RalphBacon/205-Internet-Radio/Arduino IDE Version/readme.md

### Follow the instructions in the ESP32-WROVER_Web_Radio folder

If you have an ESP32-WROVER (ie with extra PSRAM) that we can use for the Circular (Ring) Buffer follow the instructions in the Circular Buffer folder **when you have a working model**.
