RalphBacon/205-Internet-Radio/Arduino IDE Version/ESP32-WROVER_Web_Radio/images/VS1053 Cable connection.jpg

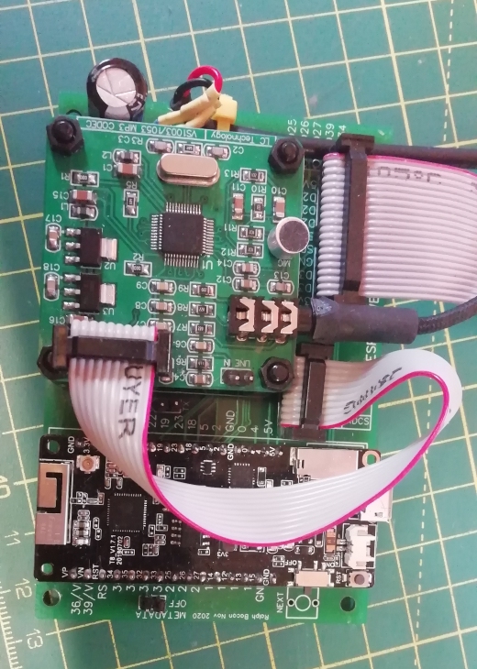
Arduino IDE Version/ESP32-WROVER_Web_Radio/images/VS1053 Cable connection.jpg
