RalphBacon/205-Internet-Radio/Design Schematics/Schematic Jan 2022.jpg

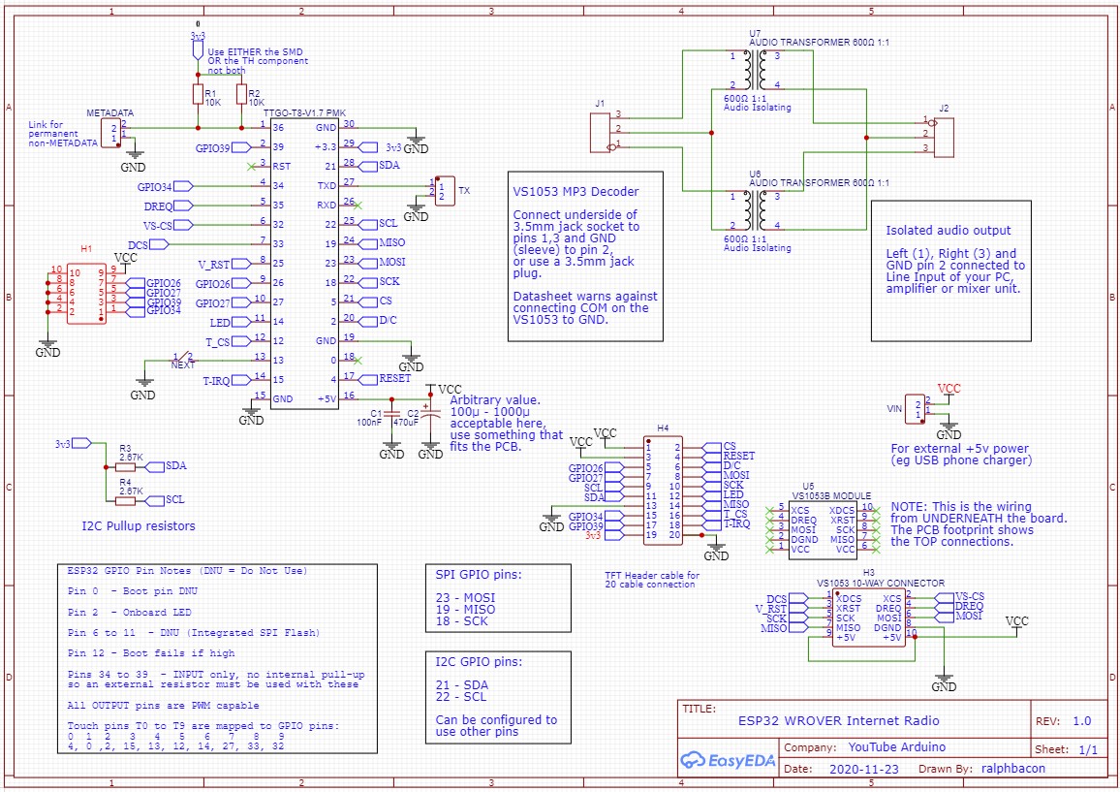
Design Schematics/Schematic Jan 2022.jpg
