RalphBacon/205-Internet-Radio/Design Schematics/TFT Screen Schematic Jan 2022.jpg

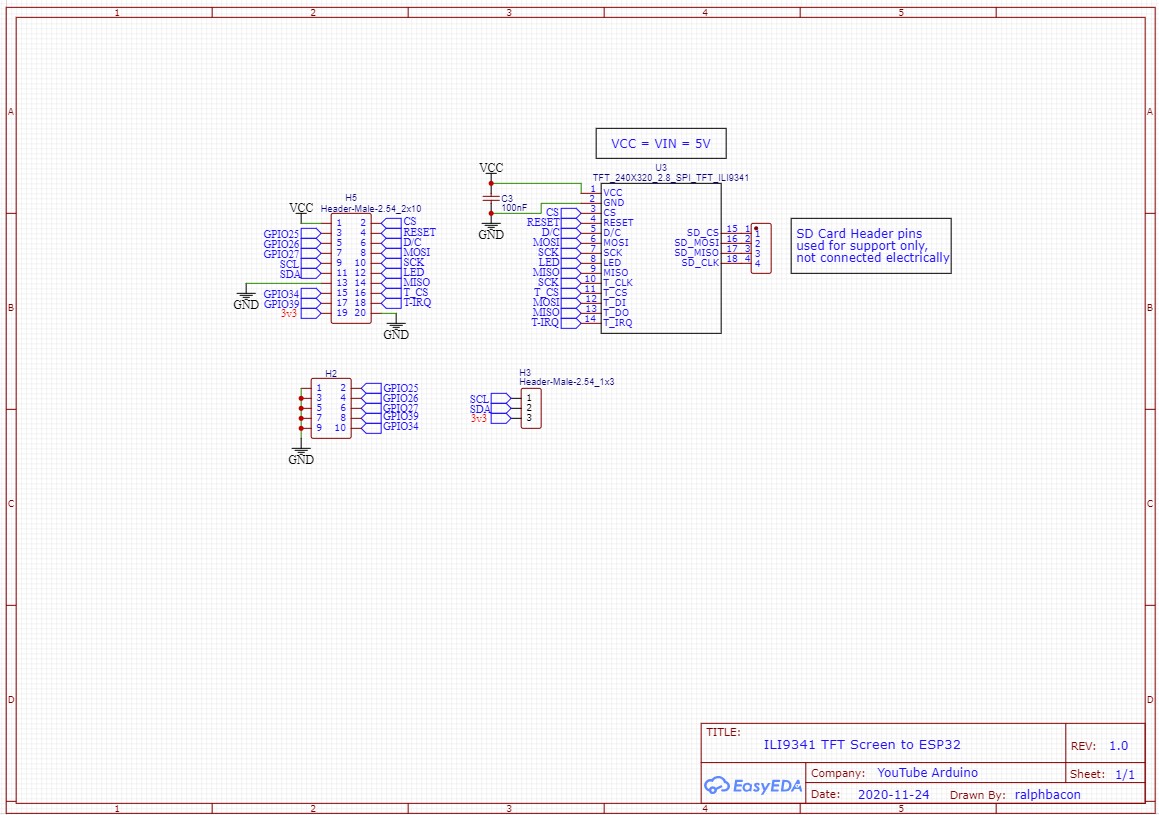
Design Schematics/TFT Screen Schematic Jan 2022.jpg
