RalphBacon/205-Internet-Radio/images/32bytes of data plays for 2mS.JPG

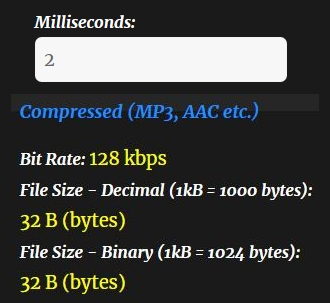
images/32bytes of data plays for 2mS.JPG
