RalphBacon/205-Internet-Radio/images/Internet_Radio.jpg

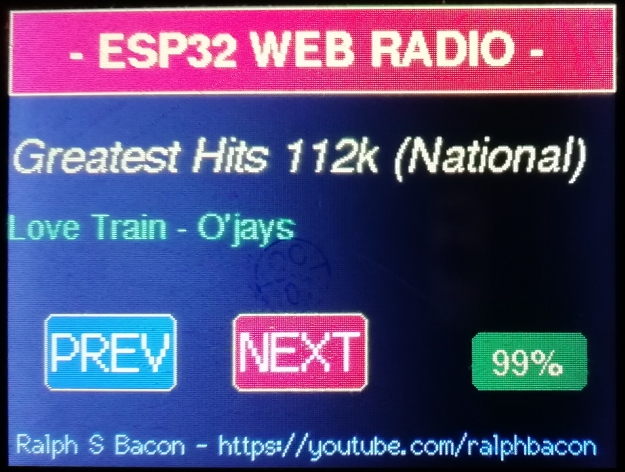
images/Internet_Radio.jpg
