RalphBacon/205-Internet-Radio/images/Long Song Title.jpg

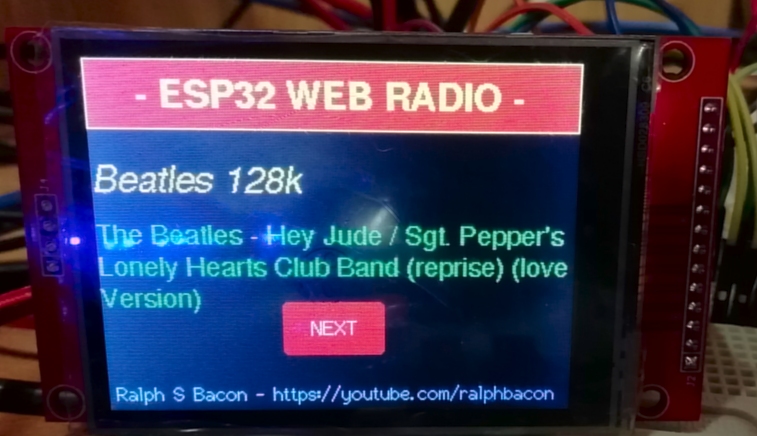
images/Long Song Title.jpg
