RalphBacon/205-Internet-Radio/images/VS1053 PICTURE.JPG

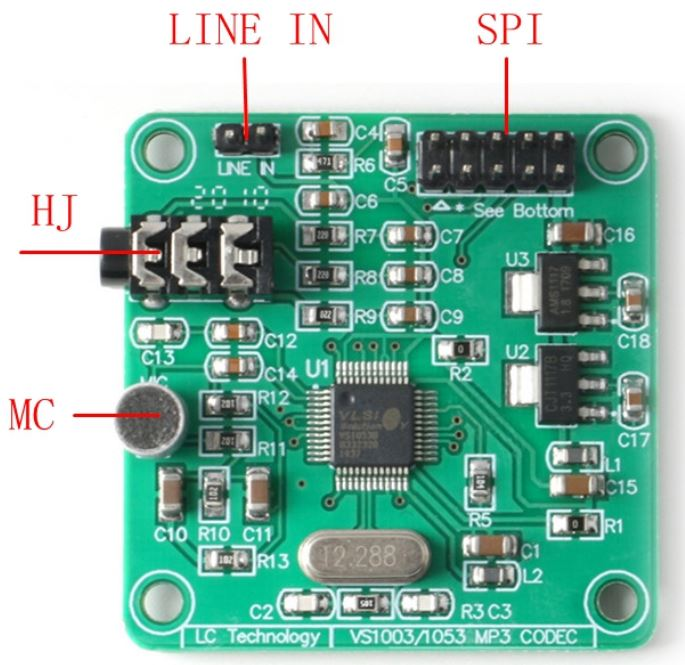
images/VS1053 PICTURE.JPG
