RalphBacon/205-Internet-Radio/PlatformIO/ESP32 Better Internet Radio - YouTube/data/Redirect 2 Example.JPG

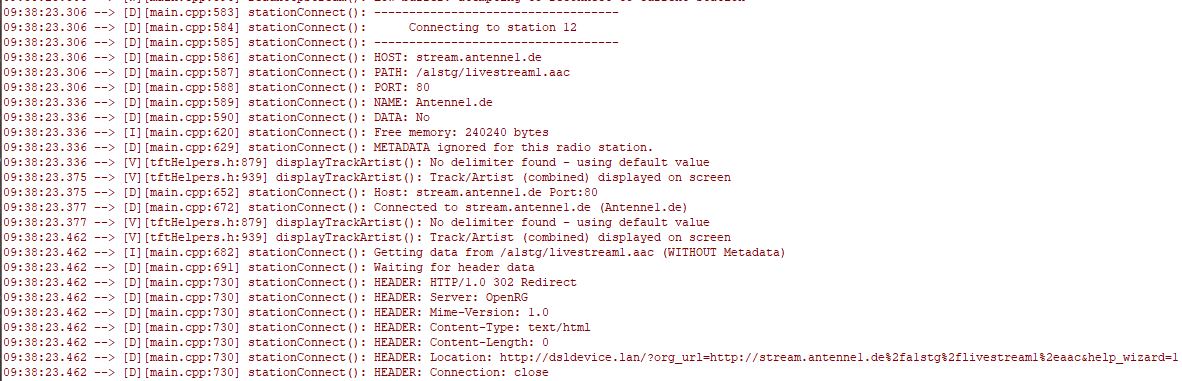
PlatformIO/ESP32 Better Internet Radio - YouTube/data/Redirect 2 Example.JPG
