RalphBacon/205-Internet-Radio/PlatformIO/ESP32 Better Internet Radio - YouTube/data/Redirect Example.JPG

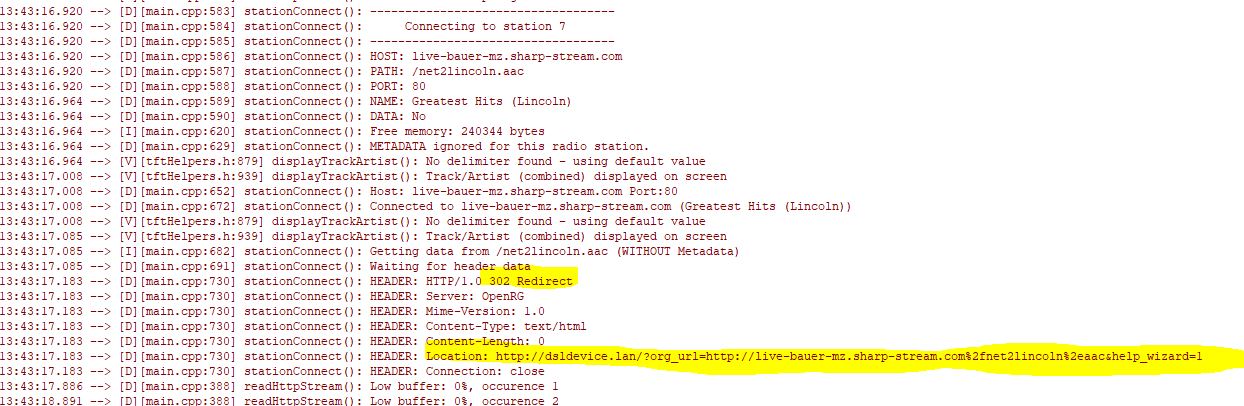
PlatformIO/ESP32 Better Internet Radio - YouTube/data/Redirect Example.JPG
