RalphBacon/205-Internet-Radio/ESP32-Web-Radio-Construction/Audio Isolation Transformers/readme.md

### Instructional video

**If you want to watch a video to show you what I did, click on the link below (the file is too large for GitHub to handle).**

https://www.dropbox.com/s/5mf6carv6id329i/Instructions%20Video%20DVD%20Quality.mp4?dl=0 

If you need the PCB (and you live in the UK) let me know.
