RalphBacon/205-Internet-Radio/ESP32-Web-Radio-Construction/Audio Isolation Transformers/IMG_20210102_132214.jpg

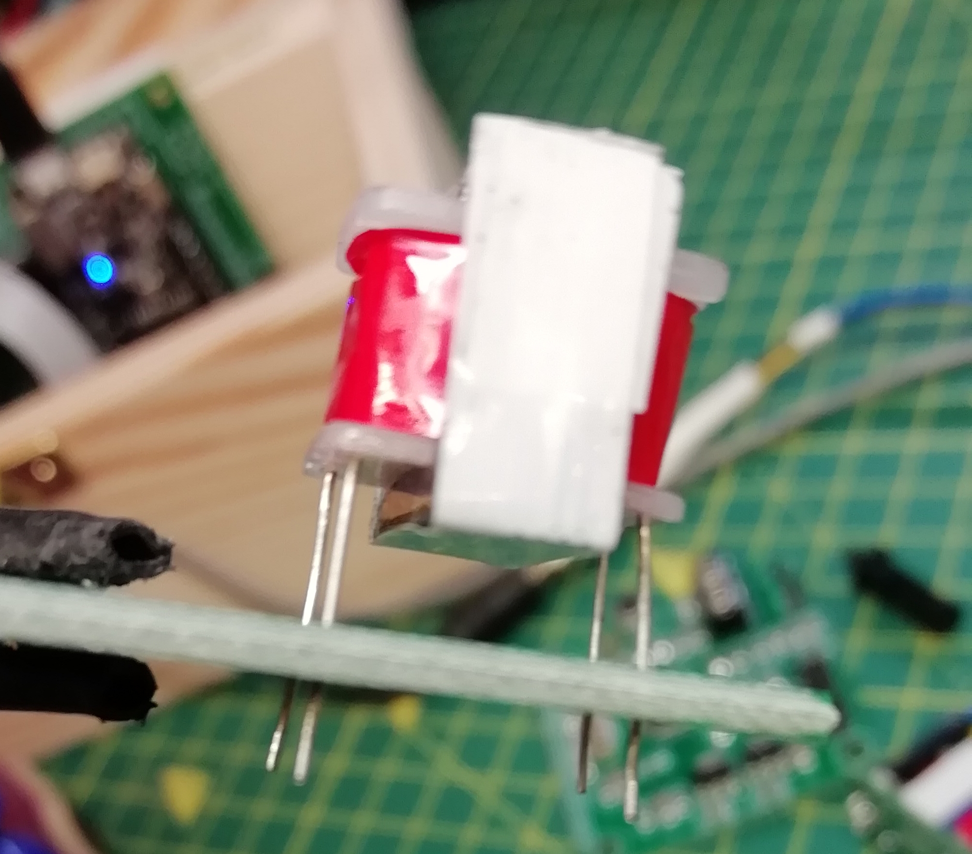
ESP32-Web-Radio-Construction/Audio Isolation Transformers/IMG_20210102_132214.jpg
