RalphBacon/205-Internet-Radio/ESP32-Web-Radio-Construction/Audio Isolation Transformers/IMG_20210102_133005.jpg

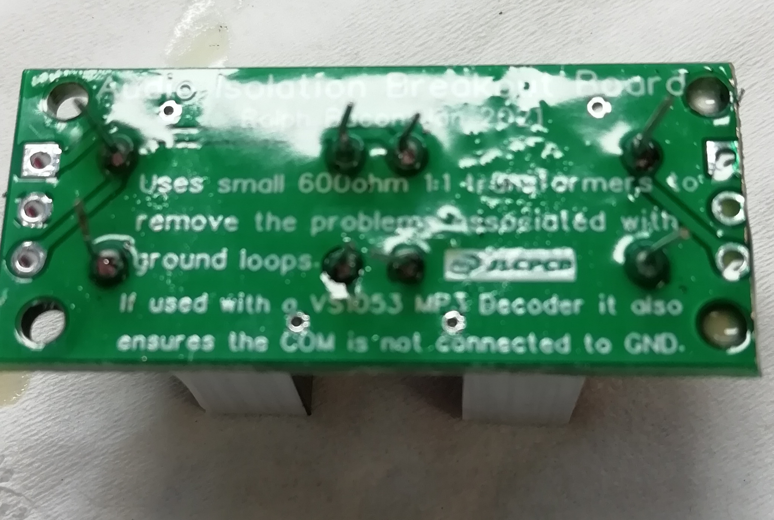
ESP32-Web-Radio-Construction/Audio Isolation Transformers/IMG_20210102_133005.jpg
