RalphBacon/205-Internet-Radio/ESP32-Web-Radio-Construction/Audio Isolation Transformers/IMG_20210108_091936.jpg

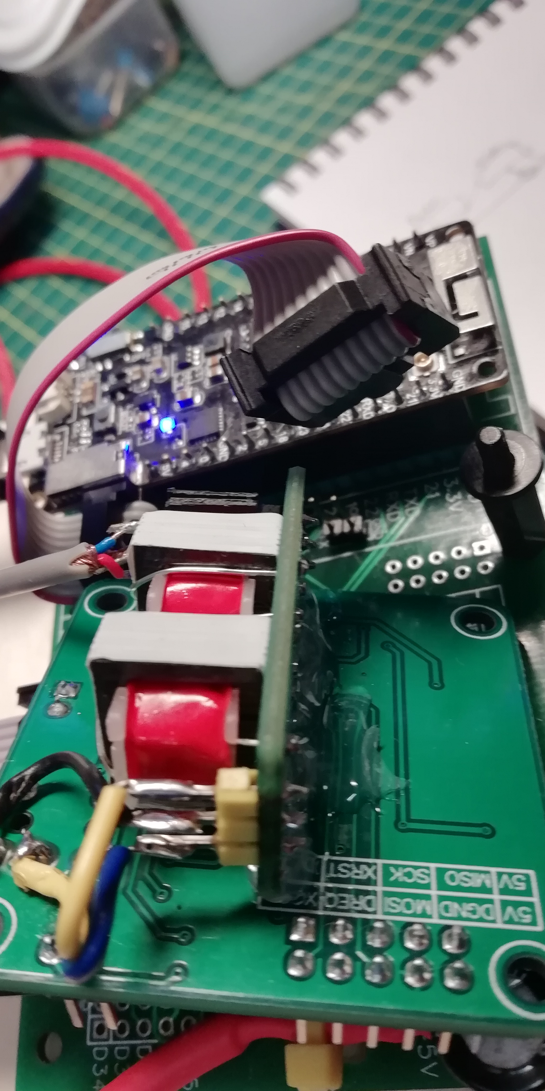
ESP32-Web-Radio-Construction/Audio Isolation Transformers/IMG_20210108_091936.jpg
