RalphBacon/205-Internet-Radio/ESP32-Web-Radio-Construction/Audio Isolation Transformers/Isolating Transformers.JPG

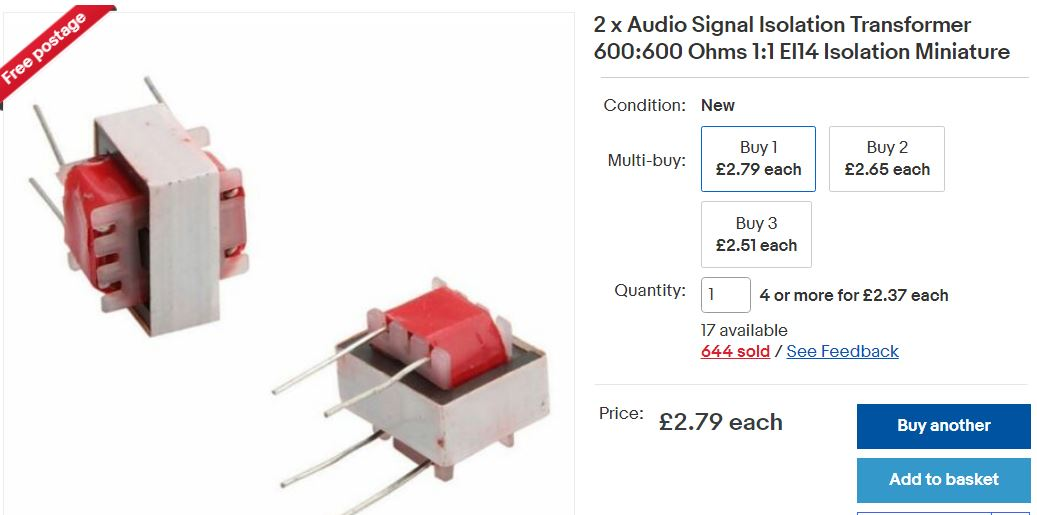
ESP32-Web-Radio-Construction/Audio Isolation Transformers/Isolating Transformers.JPG
