RalphBacon/205-Internet-Radio/ESP32-Web-Radio-Construction/Audio Isolation Transformers/PCB Layout.JPG

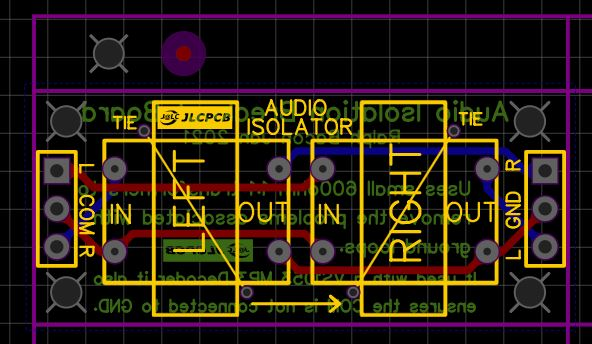
ESP32-Web-Radio-Construction/Audio Isolation Transformers/PCB Layout.JPG
