RalphBacon/205-Internet-Radio/ESP32-Web-Radio-Construction/images/IMG_20201226_133501.jpg

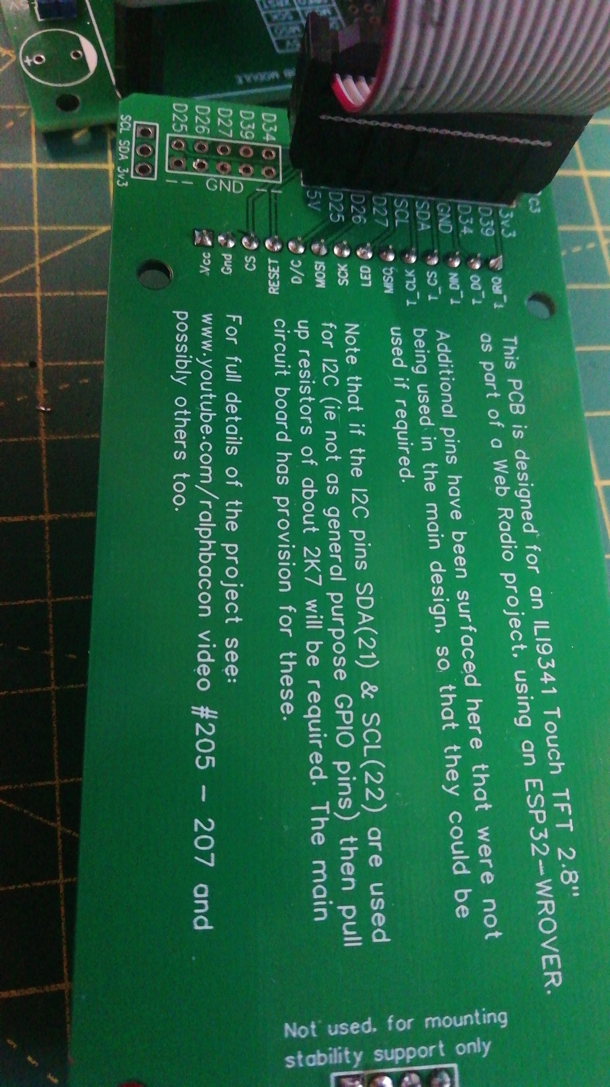
ESP32-Web-Radio-Construction/images/IMG_20201226_133501.jpg
