RalphBacon/205-Internet-Radio/PlatformIO/ESP32 Better Internet Radio - YouTube/data/tune.jpg

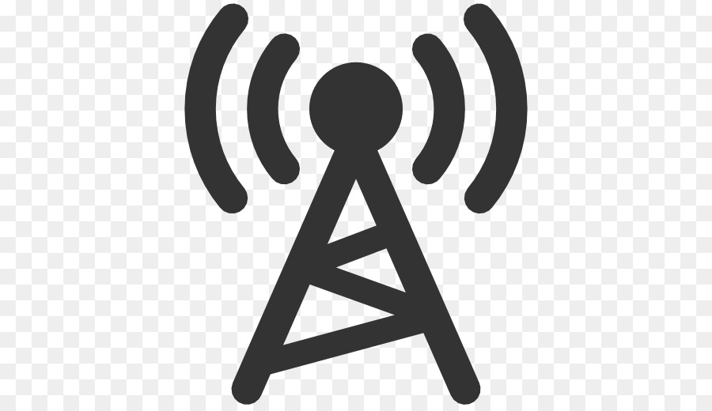
PlatformIO/ESP32 Better Internet Radio - YouTube/data/tune.jpg
