RalphBacon/205-Internet-Radio/(threads)

Thread 1 (2020-11-20):

ESP32 ECO V3

NonaSuomy, 2020-11-20:
Hi Ralph,

Was just watching your video and heard you say the latest version is V1 and that you were looking at using the PSRAM. Just wanted to show you this nfo from Expressif in case you hit these issues with the WROVER PSRAM on older V1 versions instead of the V3.

https://www.espressif.com/sites/default/files/documentation/ESP32_ECO_V3_User_Guide__EN.pdf

Earlier versions had bugs in the silicon which they have fixed in this revision.

Design Change in ECO V3

Espressif has recently released one wafer-level change on ESP32 Series of products (ECO
V3). This document describes differences between V3 and previous ESP32 silicon wafer
revisions. Below are the main design changes in ECO V3 Series of chips:

1. PSRAM Cache Bug Fix: Fixed “When the CPU accesses the external SRAM in a certain
sequence, read & write errors can occur.”. Details of the issue can be found in item 3.9
in ESP32 ECO and Workarounds for Bugs.

2. Fixed “When each CPU reads certain different address spaces simultaneously, a read
error can occur.” Details of the issue can be found in item 3.10 in ESP32 ECO and
Workarounds for Bugs.

3. Optimized 32.768 KHz crystal oscillator stability, the issue was reported by client that
there is a low probability that under ECO V1 hardware, the 32.768 KHz crystal oscillator
couldn’t start properly.

4. Fixed Fault injection issues regarding secure boot and flash encryption are fixed.
Reference: Security Advisory concerning fault injection and eFuse protections
(CVE-2019-17391) & Espressif Security Advisory Concerning Fault Injection and Secure
Boot (CVE-2019-15894)

5. Improvement: Changed the minimum baud rate supported by the CAN module from 25
kHz to 12.5 kHz.

6. Allowed Download Boot mode to be permanently disabled by programming new eFuse
bit UART_DOWNLOAD_DIS. When this bit is programmed to 1, Download Boot mode
cannot be used and booting will fail if the strapping pins are set for this mode. Software
program this bit by writing to bit 27 of EFUSE_BLK0_WDATA0_REG, and read this bit by
reading bit 27 of EFUSE_BLK0_RDATA0_REG. Write disable for this bit is shared with
write disable for the flash_crypt_cnt eFuse field.

Great job with the webradio videos keep it up! Please keep deep-diving into how the code and ring buffers work!

I was playing with https://github.com/Edzelf/ESP32-Radio before and helped include iHeartRadio to it a long while ago. The thing I liked about this code base is you can use MQTT to control the radio for home automation.

RalphBacon, 2020-11-21:
Good morning Nona Suomy!

Thank you so much for the information.

Unfortunately I get a “forbidden” message when accessing that web page, but your summary serves well. I will read it in much more detail today.

I have implemented a software workaround for the PSRAM error in V1 chips (makes me wonder how much testing they ever did).

I looked at the Web Radio from “Edzelf” aka Ed Smallenburg and realised it was very well featured but I wanted to be able to design and build my own design, which I feel I have now done (hardware issues not withstanding). But I have quite a lot more work to do if I am going to make more useful so I won’t get bored.

I’ve been running my ESP32 Rev 1 WROVER board (delivered yesterday) all last night and overnight without a single disconnect. I’m going to be testing how well it (re) connects to the WiFi today and see whether my issues have disappeared. My other V1 chip ran great for 2 days then got the same errors. I have a nagging doubt that it was my config, the router or just my Internet connection that might have been to blame. Perhaps I’ll never find out. What I do know is the ESP8266 version ran without issue at all, ever.

Thanks for the info again, great to hear from you.

Best Regards

Ralph S Bacon

 <https://www.youtube.com/ralphbacon> https://www.youtube.com/ralphbacon

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

NonaSuomy, 2020-11-23:
Sorry I fixed the link on github but it already emailed you the bad link. Was basically just what I put below that.

Here is the ECO V3 version https://www.aliexpress.com/item/4001095751970.html?spm=a2g0o.cart.0.0.c58e3c00UAaLaV&mp=1

I wonder if using an antenna on the board as well would help with reception instead of the pcb ant. Some breakout boards put the ground planes under the pcb ant which is apparently a no-no.

Even with edzelf and karadio https://github.com/karawin/Ka-Radio32 I had that same stuttering issue. Will be great if you find a solution with your build!

I'm glad you are doing your own version as it's nice to see someone explain all the finer details instead of just dumping a bunch of code online. Just doesn't do justice for the extreme curious.

I one time contacted SpriteTM (ExpressIF staff) and asked what he thinks about using this 1053 codec board with the esp32 as a webradio. He told me in his colourful way that it's pointless as the esp32 can do all that without it :) more food for thought? haha...

Keep on hacking! Great content and thanks!

RalphBacon, 2020-11-23:
Thanks for the link to the up-to-date ESP32 V3 (ECO no less!) – I wish there was a suitable board to mount it on, rather than having to remove an existing ESP32 or creating a brand new board (with the voltage regulators, USB connectivity etc). I did find several like this (“Adapter board for welding”):

 <https://www.aliexpress.com/item/32980341113.html> https://www.aliexpress.com/item/32980341113.html

but the design is only suitable for DuPont cables or a PCB – in which case I could do a better job with a custom PCB myself! And I have vague memories of Andreas Spiess warning against them as they were missing a couple of essential resistors.

I have no stuttering at all on my WROVER version (you will hear my thoughts in Friday’s video, but not the radio). Rock solid. Working now for 4 days without a problem. I will have to post the updated code to my GitHub soon. Of course, stuttering depends on the Internet generally, but also the radio server to which you are connected. My buffering (10 seconds) will do nothing for problems in either of those areas! Apart from BBC Radio 4 (don’t get me started) my design work just fine. If I connect to BBC Radio 4 without requesting metadata then that works fine too. Good old BBC. Not.

Actually, it works “too well”. I’m very tempted to just throw it into a box and keep it running in there!!! But I want a PCB and an enclosure of some sort, bearing in mind the screen must be exposed for the touch functionality. I’ve been urged by other viewers to use a Nextion screen (just three wires, including the power!) so I will make the whole design screen agnostic for other to plug in what they want. Time permitting.

Regarding the antenna, my WROVER has a built in bit of flimsy metal (not a PCB trace) that seems to work well, but also has a connection point for an external aerial. I discuss this in Friday’s video.

I’m learning so much on this project about the ESP32 (and PlatformIO) it’s been a great topic and could go on and on!

Thanks for all the info, really useful, keep tuned!

Best Regards

Ralph S Bacon

 <https://www.youtube.com/ralphbacon> https://www.youtube.com/ralphbacon

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

RalphBacon, 2021-01-24:
This will be progressed (using a V3 ECO chip) in the future.

Closed 2021-01-24.

Thread 2 (2021-01-06):

Need help to start, please

Aleks-Ale, 2021-01-06:
Please help me to run this project by any method.
ESP32 WROOM + 2.8"ili9341 w/touch + VS1053
TFT_eSPI-2.2.23\examples\320 x 240\TFT_Clock - work fine
ESP_VS1053_Library\examples\SimpleMp3Player - work fine

Arduino IDE: Compilation runs without errors. But after loading the program into ESP32, I see only a white screen and a cyclic restart in the serial port monitor.

```
rst:0xc (SW_CPU_RESET),boot:0x13 (SPI_FAST_FLASH_BOOT)
configsip: 0, SPIWP:0xee
clk_drv:0x00,q_drv:0x00,d_drv:0x00,cs0_drv:0x00,hd_drv:0x00,wp_drv:0x00
mode:DIO, clock div:1
load:0x3fff0018,len:4
load:0x3fff001c,len:1044
load:0x40078000,len:8896
load:0x40080400,len:5816
entry 0x400806ac
abort() was called at PC 0x401578ef on core 0

Backtrace: 0x4008dc5c:0x3ffe3ab0 0x4008de8d:0x3ffe3ad0 0x401578ef:0x3ffe3af0 0x40157936:0x3ffe3b10 0x4013f85f:0x3ffe3b30 0x4013f94e:0x3ffe3b50 0x4013f905:0x3ffe3b70 0x400dd0b9:0x3ffe3b90 0x400d1ef4:0x3ffe3bb0 0x400e063b:0x3ffe3bd0 0x400820d9:0x3ffe3bf0 0x400822e8:0x3ffe3c20 0x40079053:0x3ffe3c40 0x400790b9:0x3ffe3c70 0x400790c4:0x3ffe3ca0 0x4007928d:0x3ffe3cc0 0x400806de:0x3ffe3df0 0x40007c31:0x3ffe3eb0 0x4000073d:0x3ffe3f20

Rebooting...`
```

PlatformIO: Unsuccessfully again.
I installed for the first time Visual Studio Code with PlatformIO Core: 5.0.4 in Python 3.9.1.

```
Library Manager: Installing git+https://github.com/lorol/LITTLEFS.git
FileNotFoundError: [WinError 2]
  File "C:\users\alexander\.platformio\penv\lib\site-packages\platformio\builder\main.py", line 170:
    env.SConscript("$BUILD_SCRIPT")
  File "C:\Users\Alexander\.platformio\packages\tool-scons\scons-local-4.0.1\SCons\Script\SConscript.py", line 598:
    return _SConscript(self.fs, *files, **subst_kw)
  File "C:\Users\Alexander\.platformio\packages\tool-scons\scons-local-4.0.1\SCons\Script\SConscript.py", line 287:
    exec(compile(scriptdata, scriptname, 'exec'), call_stack[-1].globals)
  File "C:\users\alexander\.platformio\platforms\espressif32\builder\main.py", line 224:
    target_elf = env.BuildProgram()
  File "C:\Users\Alexander\.platformio\packages\tool-scons\scons-local-4.0.1\SCons\Environment.py", line 219:
    return self.method(*nargs, **kwargs)
  File "C:\users\alexander\.platformio\penv\lib\site-packages\platformio\builder\tools\platformio.py", line 62:
    env.ProcessProjectDeps()
  File "C:\Users\Alexander\.platformio\packages\tool-scons\scons-local-4.0.1\SCons\Environment.py", line 219:
    return self.method(*nargs, **kwargs)
  File "C:\users\alexander\.platformio\penv\lib\site-packages\platformio\builder\tools\platformio.py", line 140:
    project_lib_builder = env.ConfigureProjectLibBuilder()
  File "C:\Users\Alexander\.platformio\packages\tool-scons\scons-local-4.0.1\SCons\Environment.py", line 219:
    return self.method(*nargs, **kwargs)
  File "C:\users\alexander\.platformio\penv\lib\site-packages\platformio\builder\tools\piolib.py", line 1062:
    project.install_dependencies()
  File "C:\users\alexander\.platformio\penv\lib\site-packages\platformio\builder\tools\piolib.py", line 898:
    lm.install(spec)
  File "c:\users\alexander\.platformio\penv\lib\site-packages\platformio\package\manager\_install.py", line 49:
    spec, silent=silent, skip_dependencies=skip_dependencies, force=force
  File "c:\users\alexander\.platformio\penv\lib\site-packages\platformio\package\manager\library.py", line 86:
    force=force,
  File "c:\users\alexander\.platformio\penv\lib\site-packages\platformio\package\manager\_install.py", line 97:
    pkg = self.install_from_url(spec.url, spec, silent=silent)
  File "c:\users\alexander\.platformio\penv\lib\site-packages\platformio\package\manager\_install.py", line 141:
    vcs = VCSClientFactory.new(tmp_dir, url)
  File "c:\users\alexander\.platformio\penv\lib\site-packages\platformio\package\vcsclient.py", line 55:
    src_dir, remote_url, tag, silent
  File "c:\users\alexander\.platformio\penv\lib\site-packages\platformio\package\vcsclient.py", line 137:
    self.configure()
  File "c:\users\alexander\.platformio\penv\lib\site-packages\platformio\package\vcsclient.py", line 146:
    result = proc.exec_command([cls.command, "--exec-path"])
  File "c:\users\alexander\.platformio\penv\lib\site-packages\platformio\proc.py", line 113:
    p = subprocess.Popen(*args, **kwargs)
  File "C:\Users\Alexander\.platformio\python3\lib\subprocess.py", line 800:
    restore_signals, start_new_session)
  File "C:\Users\Alexander\.platformio\python3\lib\subprocess.py", line 1207:
    startupinfo)
```

RalphBacon, 2021-01-06:
The Arduino version is somewhat out-of-date and I don't think it auto-detects whether you have a WROVER installed or not (ie additional PSRAM) so I suspect it's trying to allocate all your SRAM to the circular buffer. Go to the main.h and reduce the circular buffer size to 10,000 (ten thousand) which will be fine for WROOM-based ESP32s, although you only get about half a second of buffering. Let me know.

Aleks-Ale, 2021-01-07:
> reduce the circular buffer size to 10,000
Thank you! I tested different values. 80,000 is good.
Now I'm trying to understand why pressing the NEXT button on touch srceen does not work. I added calibration and getTouchRaw for the test. These tests work. But pressing the touch button does not work to switch station.
Any ideas?

RalphBacon, 2021-01-07:
Do any on screen controls work? Check that the T_IRQ from the screen is connected correctly and is being detected.

Aleks-Ale, 2021-01-08:
I understood and corrected all my stupid mistakes.
This made it possible to prepare for your next project # 208. I really liked your work.
This is a good example for understanding and learning.
For example, your solution to change the screen brightness is very interesting.
I will gladly study your project code # 208.
Do you have a plan to integrate a spectrum analyzer? For example like this:
https://github.com/blotfi/ESP32-Radio-with-Spectrum-analyzer
It is also possible to create a screen with station names to scroll through the screen and select the desired station by touching.

RalphBacon, 2021-01-08:
I regret that I won't be implementing a spectrum analyser.
But I have already implemented a station lister (it now reads from a text file in the SPIFFS partition) and selects from the screen; I have not uploaded to GitHub yet, as it is in PlatformIO project format only right now. I will have to port it to the Arduino format "soon".
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

The two photos show the new format of the screen. Pressing the "?" button will bring up pages of stations to choose from.

Aleks-Ale, 2021-01-08:
> implemented a station lister (it now reads from a text file in the SPIFFS partition) and selects from the screen

OMG!!! You rock!!! You're cool!!
Short story. My first web player is a project from Edzelf. The next modification with a spectrum analyzer from blotfi.
I made this screen design for myself.

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

It works, but a lot of code, a lot of unnecessary functions, no touch.
I dreamed of finding a short project with touch control. Web radio only.
Because I am a beginner and cannot create such a solution.
Your project is short and understandable.
If you can send me this project, as in your photo, as it is, I will be very grateful to you. Maybe I can port it for arduino ide.

Aleks-Ale, 2021-01-18:
> I have already implemented a station lister

Dear Mr. Ralph Bacon,
Sorry to bother you again.
May I ask you to share this project with me?
This is very interesting and important to me.
Thank you!

RalphBacon, 2021-01-18:
There is now an Arduino ported version here:
https://github.com/RalphBacon/205-Internet-Radio

See the Arduino IDE Version folder.

Aleks-Ale, 2021-01-18:
Thank you SO MUCH! I will see right now!

Aleks-Ale, 2021-01-22:
Dear Ralf,
Could you check it out:

stationList.txt : Is necessary to have a comma at the end of each line except the last.
stationSelectHelper.h : swap port and path

```
typedef struct radioStationLayout
{
	std::string host;
        uint16_t port;
	std::string path;
	std::string friendlyName;
	uint8_t useMetaData;

```
Thank you.

RalphBacon, 2021-01-22:
1. You do not need a comma at the end of each line. This is an extract of my current list:
"stream.antenne1.de",80,"/a1stg/livestream1.aac","Antenne1.de","1"
"bbcmedia.ic.llnwd.net","80","/stream/bbcmedia_radio4fm_mf_q","BBC Radio 4",0
"stream.antenne1.de",80,"/a1stg/livestream2.mp3","Antenne1 128k",1

2. The only way to close the station list without changing station is to find the (highlighted) current station and choose that, as you have found out. I will probably change that behaviour in the future with a simple cancel button at the foot of the list (near page X of y). All a work in progress!

tadder, 2021-01-22:
Hi Ralph,
Your station lister addition is fortuitous as I have been attempting to add an extra station to the code as follows.
//8
  "internetradio.com",
  "/virgin",
  80,
  "Virgin Radio",
  1,
The lister renders this code redundant, so I will concentrate on adding the lister. Are there any guidelines I should follow when adding a new station?

RalphBacon, 2021-01-22:
The format of the station listing is pretty straightforward:

<host>,<port>,<path>,<friendly name>,<use MetaData>

Quotes are optional, it's the commas that matter (so ensure you don't have any, except to delimit the fields)

http is assumed (so don't add that as part of the host.
Port is mostly 80 but might be something else.
Friendly name is what you see on screen, so don't make it too long.
Metadata (0=no, 1=yes) will cause the station to fail if it does not transmit Metadata but you have put a 1 here - that said, the station SHOULD still honour that setting (and just send 0 byte metadata) but some don't seem to follow the rules. Always try it out on a browser (or Winamp) if you have problems to see whether track/artist information is being sent out.

Note that the absence of Track/Artist does not mean they don't send out metadata: I'm listening to a radio station right now that SHOULD send out metadata (and does, but only 0 byte markers, no actual track info) and when I queried it with them they said they were running off a backup server that doesn't send out that info but their main one (when repaired) will do so again!

Aleks-Ale, 2021-01-22:
> 1. You do not need a comma at the end of each line.
Unfortunately, I am not an expert in programming and I do not know why we have different results.
I see what I see :)  This is the log if you run the sketch without any changes.

```

[I][tftHelpers.h:148] setupDisplayModule(): TFT Initialised
[D][ESP32-WROVER_Web_Radio.ino:79] setup(): Starting player
[V][tftHelpers.h:484] displayTrackArtist(): No delimiter found - using default value
[D][ESP32-WROVER_Web_Radio.ino:84] setup(): Waiting for VS1053 initialisation to complete.
[D][ESP32-WROVER_Web_Radio.ino:91] setup(): Switch player to MP3 mode
[V][tftHelpers.h:484] displayTrackArtist(): No delimiter found - using default value
[V][tftHelpers.h:484] displayTrackArtist(): No delimiter found - using default value
[V][stationSelectHelper.h:399] populateStationList(): Parameter:'stream.antenne1.de'
[V][stationSelectHelper.h:399] populateStationList(): Parameter:'80'
[V][stationSelectHelper.h:399] populateStationList(): Parameter:'/a1stg/livestream1.aac'
[V][stationSelectHelper.h:399] populateStationList(): Parameter:'Antenne1.de'
[V][stationSelectHelper.h:399] populateStationList(): Parameter:'1bbcmedia.ic.llnwd.net'
[V][stationSelectHelper.h:474] addStationToArray(): Vector size:1
[V][stationSelectHelper.h:399] populateStationList(): Parameter:'80'
[V][stationSelectHelper.h:399] populateStationList(): Parameter:'/stream/bbcmedia_radio4fm_mf_q'
[V][stationSelectHelper.h:399] populateStationList(): Parameter:'BBC Radio 4'
[V][stationSelectHelper.h:399] populateStationList(): Parameter:'0stream.antenne1.de'
[V][stationSelectHelper.h:399] populateStationList(): Parameter:'80'
[V][stationSelectHelper.h:474] addStationToArray(): Vector size:2
[V][stationSelectHelper.h:399] populateStationList(): Parameter:'/a1stg/livestream2.mp3'
[V][stationSelectHelper.h:399] populateStationList(): Parameter:'Antenne1 128k'
[V][stationSelectHelper.h:399] populateStationList(): Parameter:'1listen.181fm.com'
[V][stationSelectHelper.h:399] populateStationList(): Parameter:'80'
[V][stationSelectHelper.h:399] populateStationList(): Parameter:'/181-beatles_128k.mp3'

[I][stationSelectHelper.h:446] populateStationList(): Radio stations imported successfully.
[D][stationSelectHelper.h:456] populateStationList(): 0 - stream.antenne1.de /a1stg/livestream1.aac 80 (Antenne1.de) YES
[D][stationSelectHelper.h:456] populateStationList(): 1 - 80 BBC Radio 4 0 (0stream.antenne1.de) NO
[D][stationSelectHelper.h:456] populateStationList(): 2 - /a1stg/livestream2.mp3 1listen.181fm.com 0 (80) NO
[D][stationSelectHelper.h:456] populateStationList(): 3 - Beatles 128k 80 1 (/magicmellow.mp3) NO
[D][stationSelectHelper.h:456] populateStationList(): 4 - 1edge-bauermz-03-gos2.sharp-stream.com /net2national.mp3 80 (Greatest Hits 112k (National)) YES
[D][stationSelectHelper.h:456] populateStationList(): 5 - 8024 Mowtown Magic Oldies 0 (1live-bauer-mz.sharp-stream.com) NO
[D][stationSelectHelper.h:456] populateStationList(): 6 - /magicmellow.aac 1stream.btsstream.com 0 (8000) NO

```

As you can see, the sections are formed incorrectly. Now I put commas at the end of the line.
Parsing completes correctly and creates a list of stations.

```
[V][tftHelpers.h:484] displayTrackArtist(): No delimiter found - using default value
[V][stationSelectHelper.h:399] populateStationList(): Parameter:'stream.antenne1.de'
[V][stationSelectHelper.h:399] populateStationList(): Parameter:'80'
[V][stationSelectHelper.h:399] populateStationList(): Parameter:'/a1stg/livestream1.aac'
[V][stationSelectHelper.h:399] populateStationList(): Parameter:'Antenne1.de'
[V][stationSelectHelper.h:399] populateStationList(): Parameter:'1'
[V][stationSelectHelper.h:474] addStationToArray(): Vector size:1
[V][stationSelectHelper.h:399] populateStationList(): Parameter:'bbcmedia.ic.llnwd.net'
[V][stationSelectHelper.h:399] populateStationList(): Parameter:'80'
[V][stationSelectHelper.h:399] populateStationList(): Parameter:'/stream/bbcmedia_radio4fm_mf_q'
[V][stationSelectHelper.h:399] populateStationList(): Parameter:'BBC Radio 4'
[V][stationSelectHelper.h:399] populateStationList(): Parameter:'0'
[V][stationSelectHelper.h:474] addStationToArray(): Vector size:2
[V][stationSelectHelper.h:399] populateStationList(): Parameter:'stream.antenne1.de'
[V][stationSelectHelper.h:399] populateStationList(): Parameter:'80'
[V][stationSelectHelper.h:399] populateStationList(): Parameter:'/a1stg/livestream2.mp3'
[V][stationSelectHelper.h:399] populateStationList(): Parameter:'Antenne1 128k'
[V][stationSelectHelper.h:399] populateStationList(): Parameter:'1'

[I][stationSelectHelper.h:446] populateStationList(): Radio stations imported successfully.
[D][stationSelectHelper.h:456] populateStationList(): 0 - stream.antenne1.de /a1stg/livestream1.aac 80 (Antenne1.de) YES
[D][stationSelectHelper.h:456] populateStationList(): 1 - bbcmedia.ic.llnwd.net /stream/bbcmedia_radio4fm_mf_q 80 (BBC Radio 4) NO
[D][stationSelectHelper.h:456] populateStationList(): 2 - stream.antenne1.de /a1stg/livestream2.mp3 80 (Antenne1 128k) YES
[D][stationSelectHelper.h:456] populateStationList(): 3 - listen.181fm.com /181-beatles_128k.mp3 80 (Beatles 128k) YES
[D][stationSelectHelper.h:456] populateStationList(): 4 - stream-mz.planetradio.co.uk /magicmellow.mp3 80 (Mellow Magic (Redirected)) YES
[D][stationSelectHelper.h:456] populateStationList(): 5 - edge-bauermz-03-gos2.sharp-stream.com /net2national.mp3 80 (Greatest Hits 112k (National)) YES
[D][stationSelectHelper.h:456] populateStationList(): 6 - airspectrum.cdnstream1.com /1302_192 8024 (Mowtown Magic Oldies) YES
```

RalphBacon, 2021-01-23:
Make sure you've taken the complete set of code in my GitHub - this looks like a previous codeset.

tadder, 2021-01-23:
I have uploaded the latest Arduino Version and followed the instruction fully. As you can see from the attached photo it is working up to a point. However, I suspect there are issues with reading the ‘stationList’ file. The first in the list ‘Antenne1.de’ plays with no problem but when changing station there appears to be a loss of sync (see 2 Ostream.antenne1 which should be radio 4. 3 is picking up the port number instead of the friendly name). Selecting some reports ‘Connecting’ and hangs others report ‘Could not connect to this station’ and allow further connection. Either way only the first station works.

As an aside, discovering radio station URL’s is difficult. I wonder if this is a ploy to get us to use ‘commercial’ WEB radios with inbuilt station lists?

As a separate exercise I also tried enabling PSRAM which results in ‘almost’ continuous reboots. I tried to get a copy of the output using the Arduino serial monitor, but was unsuccessful (though monitor appears to work when PSRAM is disabled).

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

Aleks-Ale, 2021-01-23:
> I have uploaded the latest Arduino Version

I wrote about this problem above.
Just add a comma at the end of every line except the last line in the station list file.
I think that Ralph doesn't have such a error.

```
"live-bauer-mz.sharp-stream.com",80,"/net2lincoln.aac",Greatest Hits (Lincoln),1,
ais-edge09-live365-dal02.cdnstream.com,80,/a52107?listenerId=esAdblock0650048,Heckington Community Radio,1,
live-bauer-mz.sharp-stream.com,80,/net1lincoln.aac,Radio Lincs FM,1

```

RalphBacon, 2021-01-23:
I've just uploaded **a new version v1.19** for the Arduino IDE.
Remember to also update/upload the **data partition** on your ESP32 to ensure the stationList is in the right format.
The **circular buffer** will not work above about 10000 bytes without a change to the underlying ESP32 Circular Buffer file (which I can document, but it's a bit hacky). Anyone interested?

RalphBacon, 2021-01-23:
Compare your code to the picture in the readme.md file for the Arduino IDE.

Just to be clear, you should NOT need a trailing comma at the end of the stationList.txt file if you are using the most recent codebase.

Aleks-Ale, 2021-01-23:
> Anyone interested?

Yes, of course! Thank you!

RalphBacon, 2021-01-23:
Instructions on how to enable the circular buffer on ESP32-WROVER boards added:

https://github.com/RalphBacon/205-Internet-Radio/tree/main/Arduino%20IDE%20Version

tadder, 2021-01-23:
Thanks for that, I didn’t fully understand that you were describing the same problem. You are indeed right, I have now terminated each line with a comma and they now all work. I am using the Arduino code so I wonder if Ralph doesn’t get this issue because he is using PlatformIO? Just a thought.

I am now attempting to add an extra line at the end as follows:

internet-radio.com,80,/station/xrds/,XRDS.fm Clarksdale,0

This results in “Connected Reading stream…” and no sound. I couldn’t find the Port number so guessed at 80, I wonder if this might be the issue?

Aleks-Ale, 2021-01-23:
> ESP32-WROVER boards
I understood. I used ESP 32 WROOM without SPRAM. I expect delivery of WROVER soon.

RalphBacon, 2021-01-23:
You CAN use the SP32-WROOM quite successfully, just be aware that you might experience more "drop outs".

Use the new code I posted today and get that station list issue sorted out! Otherwise you are hacking, or working around, some sort of weird conflict (perhaps you did not upload the Data folder again?). Whatever, new version is there.

Aleks-Ale, 2021-01-23:
> new version is there

Thanks. Please tell me, for what reasons do you use LITTLEFS instead of the standard SPIFFS ? Is it possible to use SPIFFS in your project? I just replaced LITTLEFS -> SPIFFS in the program text . I use a single ESP32 chip for a couple of current projects that use SPIFFS.

tadder, 2021-01-23:
Software V1.19 now being used. I am using stationList as is (no extra comma’s).

- Libaries ARDUINO_LOG, ESP_vs1053_Library, TFT_eSPI-2.2.23 updated by copying direct to libaries folder in sketch folder (overwrite).
- Data folder content upgraded via ESP32 Sketch Data Upload.
- Code now stops at ‘Starting MP3 Decoder’
-
- So I believe I have carried out the procedure correctly, but no doubt I am missing something.

MONITOR OUTPUT:
ets Jun  8 2016 00:22:57

rst:0x1 (POWERON_RESET),boot:0x13 (SPI_FAST_FLASH_BOOT)
configsip: 0, SPIWP:0xee
clk_drv:0x00,q_drv:0x00,d_drv:0x00,cs0_drv:0x00,hd_drv:0x00,wp_drv:0x00
mode:DIO, clock div:1
load:0x3fff0018,len:4
load:0x3fff001c,len:1216
ho 0 tail 12 room 4
load:0x40078000,len:9720
ho 0 tail 12 room 4
load:0x40080400,len:6352
entry 0x400806b8

[E][ESP32-WROVER_Web_Radio.ino:27] setup(): Version v1.210123_19 - 2021-01-23 14:29:43.815057
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

Aleks-Ale, 2021-01-23:
I see the same problem as Tudder.
Is it possible that we are making the same mistake?
The new version 1.19 is installed.
But you still need a comma at the end of the lines in the list of stations.
Without a comma, the list of stations is formed incorrectly. And I see the same offset of station names in the list.
It doesn't matter to me. It works anyway.
This is a great tutorial on how to work with the touch screen and organize your code.

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

RalphBacon, 2021-01-23:
If it stops at "Starting MP3 Decoder" just it's the reboot on the device. This only happens to me (sometimes) after a new code upload, never at other times. You are powering board from separate +5v supply, not via USB port, right?

RalphBacon, 2021-01-23:
I will look at station list offset tomorrow, i know the problem but I have fixed it, perhaps I have not given you the new library. Only cosmetic!

Aleks-Ale, 2021-01-23:
> i know the problem

No problem, I just use

row[nthRow].setLabelDatum(-140,

tadder, 2021-01-23:
>
>
> If it stops at "Starting MP3 Decoder" just press the reset button on the device. This only happens to me (sometimes) after a new code upload, never at other times. You are powering board from separate +5v supply, not via USB port, right?

Yes, I confirm I am powering the board from a seperate 5V PSU. Unfortunately pressing the reset button just cycles back to the same "Starting MP3 Decoder message.

tadder, 2021-01-23:
Aleks_Ale - Take a look at Ralphs Video #203 it contains a great introduction to LittleFS.

Aleks-Ale, 2021-01-24:
> Video #203

Thanks! I found it now! :)

RalphBacon, 2021-01-24:
Regarding the **on-screen station list being offset,** please check the following:

**library**: TFT_eSPI-2.2.23
**file**: Button.cpp

Line 82/83 was:
   `   _gfx->drawString(long_name, _x1 + (_w/2) + _xd, _y1 + (_h/2) - 4 + _yd);`

Now should be (with above line commented out):
```
// RSB to correct centre alignment regardless of DATUM
_gfx->drawString(long_name, _x1 + _xd, _y1 + (_h/2) - 4 + _yd);

```
This is the correction that works on Arduino IDE and PlatformIO.

RalphBacon, 2021-01-24:
Regarding the **stationList.txt** and the strange comma at the end of the line, please confirm/check the following:

Open the file in an editor that can show you HEX characters (eg notepad++)

At the end of each station line, the last two characters should be 0D 0A (carriage return, line feed). If you don't use Windows it might be different. The order of those characters is important.

"stream.antenne1.de",80,"/a1stg/livestream1.aac","Antenne1.de","1"

22 73 74 72 65 61 6d 2e 61 6e 74 65 6e 6e 65 31 2e 64 65 22 2c 38 30 2c 22 2f 61 31 73 74 67 2f 6c 69 76 65 73 74 72 65 61 6d 31 2e 61 61 63 22 2c 22 41 6e 74 65 6e 6e 65 31 2e 64 65 22 2c 22 31 22 **0d 0a**

If the last two characters are not as shown (in bold) then we have found the issue. Re-edit the file with an editor that puts those characters in there.

tadder, 2021-01-24:
I have reloaded V1.19 but it still hangs at “Starting MP3 Decoder” as described yesterday.
Any thoughts?

RalphBacon, 2021-01-24:
This means the VS1053 is not initialising.

Check the orientation of the cable going from the VS1053 to the motherboard. Specifically, ensure the 5v connections on the VS1053 go to the correct pins on the motherboard. If the cable points away from the VS1053 then it should do the same on the motherboard. If the cable runs across the VS1053 then it will connect to the motherboard with the cable running right next to the socket (a tight fit - see the pictures here: [https://github.com/RalphBacon/205-Internet-Radio/tree/main/ESP32-Web-Radio-Construction](url))

If you disconnect the cable from the VS1053 it will probably continue booting up but, obviously, you will hear no sound.

RalphBacon, 2021-01-24:
I've added a picture of the preferred way of connecting the VS1053:
[https://github.com/RalphBacon/205-Internet-Radio/tree/main/Arduino%20IDE%20Version/ESP32-WROVER_Web_Radio/images](url)
It's in the images folder for the Arduino IDE version.

tadder, 2021-01-24:
Thanks for your assistance Ralph. The board had been working prior to loading V1.19 so to double check I reloaded this prior version and it works. I have checked the wiring but I suspect you would agree in view of the old version working it’s unlikely to be a hardware issue. As you can see the VS1053 is mounted as per your suggestion.

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

RalphBacon, 2021-01-24:
I wasn't aware you had it working prior to the current version!

Go to your sketch, find the setup() routine and find these lines:
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

Comment out those lines and add:
`player.begin();`

This is how it was previously (it doesn't check the result from the call). See how far you get.

Aleks-Ale, 2021-01-24:
> the last two characters should be 0D 0A

Yes, you right. This is your original stationList.txt
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

Aleks-Ale, 2021-01-24:
> _gfx->drawString(long_name, _x1 + _xd, _y1 + (_h/2) - 4 + _yd);

Thanks! Now correct.
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

RalphBacon, 2021-01-24:
@Aleks-Ale  I can only assume that the stationList.txt you show there must be an early version. This is the problem trying to keep two code bases in-line (not forgetting non-code files)!

At least the station list now lines up correctly on-screen, excellent.

Aleks-Ale, 2021-01-24:
> I can only assume that the stationList.txt you show there must be an early version.

Is this the correct download path?
https://github.com/RalphBacon/205-Internet-Radio
I just downloaded this archive again.
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

tadder, 2021-01-24:
OK, that worked, a couple of steps further, it now outputs the welcome message and reads the station list. However it will only connect to the first station in the list, so perhaps I am now experiencing similar issues to Aleks? I will re-visit the thread you have had with him a see if this helps. Thanks as always, looks as if I might actually have this working by the end of the day.

Aleks-Ale, 2021-01-24:
> I can only assume that the stationList.txt you show there must be an early version.

I found a solution to this problem. You just need to open the stations file in MS Word and save it again.
After that, the correct codes appear at the end of the line.

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

Aleks-Ale, 2021-01-24:
I'm really looking forward to seeing how you solve the issue of returning from the list without changing the station.

RalphBacon, 2021-01-24:
Interesting about having to edit that stationList.txt file. My (local) GitHub shows the correct line endings. Perhaps it is the way GitHub processes this? Are you using Windows 10? something for me to bear in mind.

Returning from the station list (without click the current station again) is probably going to be done by touching the Page X of Y area (simple but not so obvious). I shall think about it some more. Perhaps a separate "Return Icon" button would be better.

RalphBacon, 2021-01-24:
@tadder  When you say it "only connects to the first station", does that mean when you select another one it tries to
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

Thread 3 (2021-01-09):

Bug during touch calibration data read

watts-on-root, 2021-01-09:
Whilst trying to figure out the format of the touch calibration data file I noticed a bug in file "tfthelpers.h" at line 40:

			uint16_t calData[5];
			if (f.readBytes((char *)calData, 14) == 14)

A 10 byte buffer (5 x 16-bit) is allocated, but then 14 bytes are being read into it. I'm not sure where the value 14 comes from as I assume 10 is the correct value.

RalphBacon, 2021-01-09:
Yes, this was weird, and I knew it was not logical but I exported the generated TFT calibration file and it had 14-bytes of info (if my memory serves)  If you run the same sketch from the TFT_eSPI-2.2.23 library you can then either export or just check  what it produces. I've attached the source file I hacked to get it to print the values. (I've add to rename it to a .txt type, it's really a .cpp)
[main.cpp.txt](https://github.com/RalphBacon/205-Internet-Radio/files/5791172/main.cpp.txt)

watts-on-root, 2021-01-13:
Yeah, it sure is odd. Maybe once upon a time, the cal data was stored as ascii data, which would be more bytes.
Anyway I've changed my code to only read the 10 bytes as otherwise it is for sure going the trample 4 other bytes of memory, which could hold some other unrelated variable(s).

RalphBacon, 2021-01-16:
I've done the same. I didn't realise I hadn't created the buffer large enough for 14 bytes (oops). But now I only read 10 bytes, the TFT keeps working as it always did, and there's no danger of memory corruption. In the fullness of time I will discover why the TFT calibration sketch stores 14 bytes.

RalphBacon, 2021-01-24:
I've tested this with just the (first) 10 bytes and all seems well, so no further action required.

Closed 2021-01-24.

Thread 4 (2021-01-10):

https

Aleks-Ale, 2021-01-10:
I used the following changes and these changes allow me to listen to https stations and http stations that have mirrored https.

```
main.h
#include <WiFiClientSecure.h>
WiFiClientSecure client;
```

Unfortunately this does not work if the station is http only.
Also I tried to make such improvements, but unfortunately it does not work.
WiFiClient client does not switch to WiFiClientSecure client
Any ideas?

**main.h**
```
#include <WiFiClientSecure.h>
WiFiClientSecure client;
bool http_s = true;
struct radioStationLayout
{
char host[64];
char path[128];
int port;
bool https;       // http=0 | https=1 <-----------!
char friendlyName[64];
uint8_t useMetaData;
};
```

**ESP32-WROVER_Web_Radio.ino**

```
void setup
{
http_s = preferences.getUInt("http_s", 0);
}

bool stationConnect(int stationNo)
{
if (http_s) {
WiFiClientSecure client;
int redirectedPort = 443;
}
else {
WiFiClient client;
int redirectedPort = 80;
}

http_s = radioStation[stationNo].https;
...
preferences.putUInt("http_s", http_s);
...
}
```
*These are not complete changes just to demonstrate the idea.

RalphBacon, 2021-01-11:
That's a good start, but as you have discovered you have to end the current Http session and start a new one (either secure or not) to get https / http. This can be done via the StationConnect function, if we store the flag in the station information (ie whether that station requires https or http).
It's something I can put on the improvements list but so far I've not found an https-only station - but they are bound to exist as http (not secure) is withdrawn by Google).
I wonder if they all transmit on port 443 (the http version have various ports, not always 80).

Aleks-Ale, 2021-01-11:
I use two stations for my tests:

```
//10
"radio-nice.ru",
"/stream",
8285,
0,
"http_S RADIO NICE LOFI",
0,

//11
"radio-nice.ru",
"/radio",
5110,
1,
"http RADIO NICE DEEP",
0,
```
it seems to me that this method has a better perspective of use.

main.h

```
WiFiClient* client = (http_s) ? new WiFiClient() : new WiFiClientSecure();
//WiFiClient client;
```

I tried different possibilities of using this method in the ESP32-WROVER_Web_Radio.ino.
But unfortunately I don't understand very well what I was doing. Therefore, there is no success.
Probably, when switching stations, the client type does not change.

```
void changeStation(int8_t btnValue)

  if (prevStnNo != nextStnNo)
  {
    prevStnNo = nextStnNo;
 client_stop ();
 WiFiClient* client = (http_s) ? new WiFiClient() : new WiFiClientSecure();
```

But my intuition tells me that this has a good perspective.
I need help here please.

Aleks-Ale, 2021-01-11:
The first problem is how to restore http_s from EEPROM in main.h for the correct start of the last station.

main.h

```
Preferences preferences;
bool http_s = true;
  preferences.begin("WebRadio", false);
  http_s = preferences.getUInt("http_s", 0);
WiFiClient* client = (http_s) ? new WiFiClient() : new WiFiClientSecure();
```
main.h:45:3: error: 'preferences' does not name a type
   preferences.begin("WebRadio", false);
   ^
main.h:46:3: error: 'http_s' does not name a type
   http_s = preferences.getUInt("http_s", 0);

Aleks-Ale, 2021-01-11:
> This can be done via the StationConnect function

_Step 1:_

ESP32-WROVER_Web_Radio.ino - No any changes
**main.h**

```
bool http_s = 0;  //For manual switch to unsecure WiFiClient
const int8_t stationCnt = 1;
// Only one HTTP station
struct radioStationLayout radioStation[stationCnt] = {
"radio-nice.ru",
"/radio",
5110,
0,
"http RADIO NICE DEEP",
0,
};
WiFiClient* client = (http_s) ? new WiFiClientSecure() : new WiFiClient();
```
It starts and plays normally.

```
http_s: 0
Current station number: 0
--------------------------------------
        Connecting to station 0
--------------------------------------
http_s_stationConnect: 0
Free memory: 160768 bytes
METADATA ignored for this radio station.
Host: radio-nice.ru Port:5110
Connected to radio-nice.ru (http RADIO NICE DEEP)
Getting data from /radio (WITHOUT Metadata)
Waiting for header data
Bit rate:192
Restored screen brightness to 115
Free memory: 156296 bytes
--------------------------------------
```

_Step 2:_

**ESP32-WROVER_Web_Radio.ino**

```
bool stationConnect(int stationNo)
{
 client->stop (); // Del multiple definition for client
 http_s = 0;  // For manual test

 WiFiClient* client = (http_s) ? new WiFiClientSecure() : new WiFiClient();
}
```
 Unfortunately I saw an error.

```
http_s: 0
Current station number: 0
--------------------------------------
        Connecting to station 0
--------------------------------------
http_s_stationConnect: 0
Free memory: 160712 bytes
METADATA ignored for this radio station.
Host: radio-nice.ru Port:5110
Connected to radio-nice.ru (http RADIO NICE DEEP)
Getting data from /radio (WITHOUT Metadata)
Waiting for header data
Bit rate:192
Restored screen brightness to 115
Free memory: 156252 bytes
Client not connected.      <-------------
Connecting to SSID: brg
Disconnecting from WiFi
Setting ESP32 to STA mode
Setting ESP32 to NOT store credentials in NVR
Setting ESP32 to NOT allow sleep
Setting ESP32 to NOT auto re-connect[D][WiFiGeneric.cpp:337] _eventCallback(): Event: 5 - STA_DISCONNECTED
[W][WiFiGeneric.cpp:353] _eventCallback(): Reason: 8 - ASSOC_LEAVE
Initiating connection with WiFi.
[D][WiFiGeneric.cpp:337] _eventCallback(): Event: 4 - STA_CONNECTED
[D][WiFiGeneric.cpp:337] _eventCallback(): Event: 7 - STA_GOT_IP
[D][WiFiGeneric.cpp:381] _eventCallback(): STA IP: 192.168.1.115, MASK: 255.255.255.0, GW: 192.168.1.1
Waiting for WiFi connection...
WiFi connected with (local) IP address of: 192.168.1.115
--------------------------------------
        Connecting to station 0
--------------------------------------
http_s_stationConnect: 0
Free memory: 151348 bytes
METADATA ignored for this radio station.
.....

```
I do not know what to do.

RalphBacon, 2021-01-11:
There is no need to store this information in EEPROM. When a station change occurs, read the station info (eg host, path, port, metaData AND http format). Then retain the existing webclient if you can, or close it and open a secure one.
The error you highlight is what happens when a connection fails - it retries again, so it is probably retrying using standard http.

Aleks-Ale, 2021-01-11:
My brain is exploding. I give up!
My knowledge is not enough for this.
Are you interested in solving this problem?

RalphBacon, 2021-01-24:
I will look at this but it will be several weeks (if not months) before I get my new workshop setup and that is after moving home (happening any day now).

Keep tuned for an update around Easter (aspirational date).

Closed 2021-01-24.

Thread 5 (2021-01-24):

Editing the Station List

tadder, 2021-01-24:
I am attempting to edit the contents of stationList loaded in LittleFS. I have added an extra line at the end as follows:

internet-radio.com,80,/station/xrds,XRDS.fm Clarksdale,0

This is picked up on the screen but there is no sound only the message “Connected. Reading stream...”

The info comes from the internet-radio web page. I have guessed at the port number because so far I haven't found it specified anywhere.

Have others found a process for adding new stations that has better success?

`"stream.antenne1.de",80,"/a1stg/livestream1.aac","Antenne1.de","1"
"bbcmedia.ic.llnwd.net","80","/stream/bbcmedia_radio4fm_mf_q","BBC Radio 4",0
"stream.antenne1.de",80,"/a1stg/livestream2.mp3","Antenne1 128k",1
"listen.181fm.com",80,"/181-beatles_128k.mp3","Beatles 128k",1
"stream-mz.planetradio.co.uk",80,"/magicmellow.mp3","Mellow Magic (Redirected)",1
"edge-bauermz-03-gos2.sharp-stream.com",80,"/net2national.mp3","Greatest Hits 112k (National)",1
"airspectrum.cdnstream1.com",8024,"/1302_192","Mowtown Magic Oldies",1
"live-bauer-mz.sharp-stream.com",80,"/magicmellow.aac","Mellow Magic (48k AAC)",1
"stream.btsstream.com",8000,"/seaac","South East Radio (AAC 64k)",1
"uk2.internet-radio.com",8024,"/",UK Dance Radio,1
"us4.internet-radio.com",8197,"/stream?type=http&nocache=72","EZ Hits South FLA",0
s1.slotex.pl,7274,"/",Radio Kehlkopf,0
204.187.100.18,1485,"/",De Natchegaal,1
"live-bauer-mz.sharp-stream.com",80,"/net2lincoln.aac",Greatest Hits (Lincoln),1
ais-edge09-live365-dal02.cdnstream.com,80,/a52107?listenerId=esAdblock0650048,Heckington Community Radio,1
live-bauer-mz.sharp-stream.com,80,/net1lincoln.aac,Radio Lincs FM,1
internet-radio.com,80,/station/xrds,XRDS.fm Clarksdale,0`

RalphBacon, 2021-01-24:
Does the buffer show anything other than 0%? If it shows zero then nothing is coming down the line (possibly due to incorrect port). Try typing in the full (ie concatenated) url into your browser. If that doesn't start playing music (wihtout having to click anything) then that's the reason.

This web page has many stations:
https://www.internet-radio.com/

This is UK based:
http://www.radiofeeds.co.uk/mp3.asp

Sometimes you have to download the .pls file and look inside that to get the URL - but always test first on a browser (or WinAmp, even better).

tadder, 2021-01-24:
Thanks for that, internet-radio.com is in fact where I got the first station I tried from.
The latest line I have tried is as follows:
	www.internet-radio.com,80,/station/majesticjukebox/,Majestic Jukebox,1
With the 1 at the end I get ‘No MetaData interval found’ 0%
changing to 0 at the end I get ‘Connected Reading stream’ 1%
I tried with and without WWW.

I put internet-radio.com/station/majesticjukebox/ in my browser which changes it to:
https://www.internet-radio.com/station/majesticjukebox/ it then plays OK in the browser

RalphBacon, 2021-01-25:
That might the problem:

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

My ESP32 Web Radio does not support secure (https) addresses at this time; something I may look at in the future. You need to see if they mirror the stream with a standard http (port 80) url. Most commercial radio stations do, because they want you to listen to them (and the adverts).

RalphBacon, 2021-01-25:
@tadder
I looked at this station and the WinAmp playlist (,pls) shows that the station translates to:
uk3.internet-radio.com,8405,/live,Majestic Jukebox,1
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

Plays OK. No https required.

tadder, 2021-01-25:
Ralph, That great, so my final issue was down to how I interpreted the URL. On Internet-radio.com I just click on the .pls button and read how it's translated. I don’t know if this works for all stations but I have added three so far and they all work. Really pleased.
Some stutter a little so I assume I need to get PSRAM up and running to see if that helps.
Thanks again, I couldn’t have done it without your support.

RalphBacon, 2021-01-26:
@tadder
Yes, downloading the WinAmp .pls file will (should) always show one or more URLs that only require http.

I'll close this issue (for now) but in the fullness of time I want to be able to parse the entire URL (splitting this way was the first step).

In the even longer term I want to be able to upload the URLs without having to upload the entire "data" folder to LittleFS - but that's some way off.

Let me know if you can follow the instruction on the GitHub to getting the circular buffer running (open a different issue if you get stuck).

Closed 2021-01-26.

Thread 6 (2021-01-26):

Loop logging  TFT Calibration Data

rjshiffer, 2021-01-26:
Problem:  Infinite for loop while logging TFT Calibration Data

Environment: Arduino IDE
Hardware:  ESP-WROOM-32 + ILI9341  + VS1053

See file tftHelpers.h, near line 47 and 72:
```
// There are 10 bytes (5 integers @ 2 bytes each) for TFT calibration
#define totCalibrationBytes 10
.
.
.
// Buffer (integer 2 bytes * 5) to hold calibration data
uint16_t calData[5];

// On calibration, 14 bytes were written. TODO: why?
//if (f.readBytes((char *)calData, 14) == 14)
if (f.readBytes((char *)calData, totCalibrationBytes) == totCalibrationBytes)
	tft.setTouch(calData);

log_v("TFT Calibration data:");
for (auto cnt = 0; cnt < totCalibrationBytes; cnt++)
{
	log_v("%04X, ", calData[cnt]);
}

f.close();
log_i("Touch Calibration completed");
```
Notice that calData[5] array only has 5 elements, but the for loop will
end after "totCalibrationBytes" (10+1 for 0 start) loops.  The reference to calData[cnt]
refers to uint16_t (2 bytes), so the loop only needs to execute 5 times.
```
17:42:51.245 -> [E][ESP32-WROVER_Web_Radio.ino:34] setup(): Version v1.210123_19 - 2021-01-23 14:29:43.815057
17:42:51.292 -> [D][ESP32-WROVER_Web_Radio.ino:42] setup(): Total heap: 331196
17:42:51.292 -> [D][ESP32-WROVER_Web_Radio.ino:43] setup(): Free heap: 294856
17:42:51.292 -> [D][ESP32-WROVER_Web_Radio.ino:44] setup(): Total PSRAM: 0
17:42:51.292 -> [D][ESP32-WROVER_Web_Radio.ino:45] setup(): Free PSRAM: 0
17:42:51.292 -> [D][ESP32-WROVER_Web_Radio.ino:46] setup(): Used PSRAM: 0
17:42:51.292 -> [D][ESP32-WROVER_Web_Radio.ino:55] setup(): Starting SPI
17:42:51.292 -> [D][ESP32-WROVER_Web_Radio.ino:59] setup(): Free memory: 294732 bytes
17:42:51.292 -> [I][ESP32-WROVER_Web_Radio.ino:70] setup(): LITTLEFS system mounted SUCCESSFUL.
17:42:51.339 -> [V][tftHelpers.h:80] initDisplay(): TFT Calibration data:
17:42:51.339 -> [V][tftHelpers.h:84] initDisplay(): 0183,
17:42:53.324 -> [V][tftHelpers.h:84] initDisplay(): 0D96,
17:42:55.340 -> [V][tftHelpers.h:84] initDisplay(): 00FA,
17:42:57.320 -> [V][tftHelpers.h:84] initDisplay(): 0D86,
17:42:59.306 -> [V][tftHelpers.h:84] initDisplay(): 0007,
17:43:01.307 -> [V][tftHelpers.h:84] initDisplay(): 7304,
17:43:03.336 -> [V][tftHelpers.h:84] initDisplay(): 3F40,
17:43:05.320 -> [V][tftHelpers.h:84] initDisplay(): 0000,
17:43:07.337 -> [V][tftHelpers.h:84] initDisplay(): 0000,
17:43:09.315 -> [V][tftHelpers.h:84] initDisplay(): 0000,
17:43:11.298 -> [V][tftHelpers.h:84] initDisplay(): 0000,
17:43:13.329 -> [V][tftHelpers.h:84] initDisplay(): 0000,
17:43:15.313 -> [V][tftHelpers.h:84] initDisplay(): 0000,
17:43:17.334 -> [V][tftHelpers.h:84] initDisplay(): 8CE4,
17:43:19.305 -> [V][tftHelpers.h:84] initDisplay(): 3FFB,
17:43:21.333 -> [V][tftHelpers.h:84] initDisplay(): 8C34,
17:43:23.320 -> [V][tftHelpers.h:84] initDisplay(): 3FFB,
17:43:25.343 -> [V][tftHelpers.h:84] initDisplay(): 1EE0,
17:43:27.324 -> [V][tftHelpers.h:84] initDisplay(): 3FFB,
17:43:29.339 -> [V][tftHelpers.h:84] initDisplay(): 1EC0,
.
.
.
.
```
Changing the for loop code to:
```
for (int cnt = 0; cnt <= 4; cnt++)
{
   log_v("%04X, ", calData[cnt]);
}
```
results in:
```
17:46:27.370 -> [I][ESP32-WROVER_Web_Radio.ino:70] setup(): LITTLEFS system mounted SUCCESSFUL.
17:46:27.418 -> [V][tftHelpers.h:80] initDisplay(): TFT Calibration data:
17:46:27.418 -> [V][tftHelpers.h:91] initDisplay(): 0183,
17:46:27.418 -> [V][tftHelpers.h:91] initDisplay(): 0D96,
17:46:27.418 -> [V][tftHelpers.h:91] initDisplay(): 00FA,
17:46:27.418 -> [V][tftHelpers.h:91] initDisplay(): 0D86,
17:46:27.418 -> [V][tftHelpers.h:91] initDisplay(): 0007,
17:46:27.418 -> [I][tftHelpers.h:95] initDisplay(): Touch Calibration completed
```
I have no idea why it loops, but certainly referring to elements beyond array
size is an error.  Also, can't help with the 10 bytes vs 14 bytes question.

Also, I have the same problem with this code found in the utility program that
writes the /TouchCalData1.txt file to the LITTLEFS.
```
Serial.println("Calibration data (14 integers of two bytes each):");
for (int cnt = 0; cnt < 14; cnt++)
{
	Serial.printf("%d. ", cnt);
	Serial.printf("%04X\n", calData[cnt]);
}
```
Ralph, I don't remember where I got the utility code to write the
TouchCalData1.txt file, but I think I may have gotten it from your comments
somewhere.  I couldn't find it on your Github (which would have helped with
may confusion as to how to create the file.)

The project is great.  I have your PCBs ready and I'm just waiting for my
TTGO T8 v1.7 to arrive.

RalphBacon, 2021-01-26:
@rjshiffer
I had issues (very occasionally) when I tried to read 14 bytes into a 10-byte buffer (doh!) but I thought my change had fixed it.

However, you tracing shows that it must be reading 10 bytes (5 integers of 2 bytes). Reading more probably just corrupts the loop counter (as you found out).

I'll look at this again.

rjshiffer, 2021-01-26:
The change with Version V1.29 only prints 2 calData entries.

Version v1.210126_29 - 2021-01-26 10:39:16.425885

```
log_v("TFT Calibration data:");
for (auto cnt = 0; cnt < totCalibrationBytes / sizeof(int); cnt++)
{
    log_v("%04X, ", calData[cnt]);
}
```
The sizeof(int) is 4, but calData is type uint16_t which is 2 bytes. 10/4 = 2  (truncated)

This works:
```
for (auto cnt = 0; cnt < totCalibrationBytes / sizeof(uint16_t); cnt++)
```

``

RalphBacon, 2021-01-27:
@rjshiffer
Oops. That's what happens when you spend years using 8-bit microcontrollers and just "know" that int is 2-bytes long! I've made this correction and I'll upload soon.

RalphBacon, 2021-01-27:
As this is a non-functional change (it just displays the calibration data, with the workaround described above) and will be included in the next release this bug is now closed.

Closed 2021-01-27.

Thread 7 (2021-01-26):

ESP32 log messages do not appear in Serial Monitor

rjshiffer, 2021-01-26:
Problem: ESP32 log messages from the log_n, log_d, etc., functions do not appear in the Serial Monitor
Environment: Arduino IDE
Hardware: ESP-WROOM-32 + ILI9341 + VS1053

I may be doing something wrong, but I could not get the logging messages from all the logging functions
(log_e, log_d, etc.) to appear in the Serial Monitor.

Is there something in the Arduino IDE to set to enable this logging by default?  Perhaps the Platform.io environment sets something during the build process to enable logging.

I had to add the following to the very beginning of ESP32-WROVER_Web_Radio.ino file:
```
#ifdef CORE_DEBUG_LEVEL
#undef CORE_DEBUG_LEVEL
#endif

#define CORE_DEBUG_LEVEL 5
#define LOG_LOCAL_LEVEL ESP_LOG_DEBUG
```
After this, all the logging messages appeared on the Serial Monitor.

RalphBacon, 2021-01-26:
@rjshiffer  Yup, this is a recent regression bug!

When I now compile the code for the Arduino (using PlatformIO initially, so that it increments the build number you see in the title bar and in the serial monitor output) I have set the debugging level to _Informational_ - meaning that messages for debug (_d) and verbose (_v) won't be shown. I do this because my "stable" version (as used in the Arduino) is the version I listen to all day and don't need so much debugging; I have another unit for that.

Your workaround was perfect and something I need to think about how I might incorporate that into the Arduino version. I need to so this otherwise when you get the next version (has a cancel button in the on-screen station list, amongst other refinements in the code) your version will get reverted.

Of course, you could switch to PlatformIO... :)

RalphBacon, 2021-01-27:
@rjshiffer
Alsoi, ensure you have set the Core Debug Level correctly:
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

My Arduino version "just works" by doing this.

rjshiffer, 2021-01-27:
@RalphBacon
Perfect!  That's exactly what I needed.  No code changes either.  I learn something new from you every day. And yes,  PlatformIO is next!  :)  Thanks.

RalphBacon, 2021-01-27:
Good luck with PlatformIO - it's definitely worth the initial head-against-brick-wall moments!

Closed 2021-01-27.

Thread 8 (2021-01-26):

Incorporating PSRAM

tadder, 2021-01-26:
I downloaded the latest version and straight off the bat it works fine. However when I attempt to incorporate PSRAM with the new cbuf.cpp code the following two results are manifest.

       With PSRAM enabled and the new version of cbuf.cpp
       Serial monitor output:

Rebooting...
ets Jun  8 2016 00:22:57

rst:0xc (SW_CPU_RESET),boot:0x13 (SPI_FAST_FLASH_BOOT)
configsip: 0, SPIWP:0xee
clk_drv:0x00,q_drv:0x00,d_drv:0x00,cs0_drv:0x00,hd_drv:0x00,wp_drv:0x00
mode:DIO, clock div:1
load:0x3fff0018,len:4
load:0x3fff001c,len:1216
ho 0 tail 12 room 4
load:0x40078000,len:9720
ho 0 tail 12 room 4
load:0x40080400,len:6352
entry 0x400806b8
[E][ESP32-WROVER_Web_Radio.ino:27] setup(): Version v1.210126_29 - 2021-01-26 10:39:16.425885
Guru Meditation Error: Core  0 panic'ed (LoadProhibited). Exception was unhandled.
Core 0 register dump:
PC      : 0x40165225  PS      : 0x00060030  A0      : 0x80167e40  A1      : 0x3ffaf330
A2      : 0xfffffffd  A3      : 0x0000001f  A4      : 0x00000034  A5      : 0x00000000
A6      : 0x00000000  A7      : 0x00000000  A8      : 0x3f401670  A9      : 0x00000000
A10     : 0x00000000  A11     : 0x00000000  A12     : 0x00000000  A13     : 0x00000001
A14     : 0x00060420  A15     : 0x00000000  SAR     : 0x00000010  EXCCAUSE: 0x0000001c
EXCVADDR: 0xfffffffd  LBEG    : 0x4000c2e0  LEND    : 0x4000c2f6  LCOUNT  : 0xffffffff

Backtrace: 0x40165225:0x3ffaf330 0x40167e3d:0x3ffaf350 0x40092047:0x3ffaf370 0x40093508:0x3ffaf3a0 0x400912ab:0x3ffaf3d0 0x4009331d:0x3ffaf470 0x4008c905:0x3ffaf4b0

           With PSRAM disabled and the new version of cbuf.cpp:

Arduino: 1.8.13 (Windows 10), Board: "ESP32 Dev Module, Disabled, Default 4MB with spiffs (1.2MB APP/1.5MB SPIFFS), 240MHz (WiFi/BT), QIO, 80MHz, 4MB (32Mb), 921600, None"

C:\Users\Tadder\AppData\Local\Arduino15\packages\esp32\hardware\esp32\1.0.4\cores\esp32\cbuf.cpp: In member function 'size_t cbuf::resize(size_t)':

C:\Users\Tadder\AppData\Local\Arduino15\packages\esp32\hardware\esp32\1.0.4\cores\esp32\cbuf.cpp:59:6: error: 'BOARD_HAS_PSRAM' was not declared in this scope

  if (BOARD_HAS_PSRAM)

      ^

Multiple libraries were found for "User_Setup.h"

 Used: C:\Users\Tadder\Documents\Arduino\libraries\TFTTFT_eSPI-2.2.23

 Not used: C:\Users\Tadder\Documents\Arduino\libraries\TFT_eSPI-2.2.23

Multiple libraries were found for "ArduinoLog.h"

 Used: C:\Users\Tadder\Documents\Arduino\libraries\ArduinoArduinoLog

 Not used: C:\Users\Tadder\Documents\Arduino\libraries\Arduino-Log

Multiple libraries were found for "VS1053.h"

 Used: C:\Users\Tadder\Documents\Arduino\libraries\ESP_VS1053_Library

 Not used: C:\Users\Tadder\Documents\Arduino\libraries\ESPESP_VS1053_Library

exit status 1

Error compiling for board ESP32 Dev Module.

RalphBacon, 2021-01-27:
When you  selected the board, did you ensure it was the ES32-WROVER board? If you selected ESP32 Dev Module you need an additional parameter:

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

Please check and confirm. The first error you got looks very much as though PSRAM was NOT being used so you used all the SRAM up. Keep the circular buffer value (in main.h) to 10000 (ten thousand) until we have this working for you.

The serial output will show immediately  (unless it panics) whether PSRAM is detected and how much was used.

tadder, 2021-01-27:
You were spot on, I did indeed have Dev Module selected. I have changed this to Wrover Module and this does compile. I note that Wrover Board does not provide the option in Tools of enabling PSRAM.

Confirmed that CIRCULARBUFFERSIZE is 10000

The board works for a few seconds and then reboots with the message:
Guru Meditation Error: Core  1 panic'ed (StoreProhibited). Exception was unhandled.
What does ‘panic’ mean in this context?

Serial OP is as follows:

[V][tftHelpers.h:809] displayTrackArtist(): No delimiter found - using default value
[V][tftHelpers.h:809] displayTrackArtist(): No delimiter found - using default value
[V][tftHelpers.h:809] displayTrackArtist(): No delimiter found - using default value
[V][tftHelpers.h:809] displayTrackArtist(): No delimiter found - using default value
[V][tftHelpers.h:809] displayTrackArtist(): No delimiter found - using default value
[V][tftHelpers.h:809] displayTrackArtist(): No delimiter found - using default value
[V][tftHelpers.h:809] displayTrackArtist(): No delimiter found - using default value
[V][tftHelpers.h:809] displayTrackArtist(): No delimiter found - using default value
[V][tftHelpers.h:809] displayTrackArtist(): No delimiter found - using default value
[D][ESP32-WROVER_Web_Radio.ino:86] setup(): Waiting for VS1053 initialisation to complete.
[V][tftHelpers.h:809] displayTrackArtist(): No delimiter found - using default value
[D][ESP32-WROVER_Web_Radio.ino:97] setup(): Switch player to MP3 mode
[V][tftHelpers.h:809] displayTrackArtist(): No delimiter found - using default value
[V][ESP32-WROVER_Web_Radio.ino:119] setup(): Previous volume was 99
[V][tftHelpers.h:809] displayTrackArtist(): No delimiter found - using default value
[V][tftHelpers.h:809] displayTrackArtist(): No delimiter found - using default value
[V][stationSelectHelper.h:420] populateStationList(): Parameter:'stream.antenne1.de'
[V][stationSelectHelper.h:420] populateStationList(): Parameter:'80'
[V][stationSelectHelper.h:420] populateStationList(): Parameter:'/a1stg/livestream1.aac'
[V][stationSelectHelper.h:420] populateStationList(): Parameter:'Antenne1.de'
[V][stationSelectHelper.h:420] populateStationList(): Parameter:'1'
[V][stationSelectHelper.h:496] addStationToArray(): Vector size:1
[V][stationSelectHelper.h:420] populateStationList(): Parameter:'bbcmedia.ic.llnwd.net'
[V][stationSelectHelper.h:420] populateStationList(): Parameter:'80'
[V][stationSelectHelper.h:420] populateStationList(): Parameter:'/stream/bbcmedia_radio4fm_mf_q'
[V][stationSelectHelper.h:420] populateStationList(): Parameter:'BBC Radio 4'
[V][stationSelectHelper.h:420] populateStationList(): Parameter:'0'
[V][stationSelectHelper.h:496] addStationToArray(): Vector size:2
[V][stationSelectHelper.h:420] populateStationList(): Parameter:'stream.antenne1.de'
[V][stationSelectHelper.h:420] populateStationList(): Parameter:'80'
[V][stationSelectHelper.h:420] populateStationList(): Parameter:'/a1stg/livestream2.mp3'
[V][stationSelectHelper.h:420] populateStationList(): Parameter:'Antenne1 128k'
[V][stationSelectHelper.h:420] populateStationList(): Parameter:'1'
[V][stationSelectHelper.h:496] addStationToArray(): Vector size:3
[V][stationSelectHelper.h:420] populateStationList(): Parameter:'listen.181fm.com'
[V][stationSelectHelper.h:420] populateStationList(): Parameter:'80'
[V][stationSelectHelper.h:420] populateStationList(): Parameter:'/181-beatles_128k.mp3'
[V][stationSelectHelper.h:420] populateStationList(): Parameter:'Beatles 128k'
[V][stationSelectHelper.h:420] populateStationList(): Parameter:'1'
[V][stationSelectHelper.h:496] addStationToArray(): Vector size:4
[V][stationSelectHelper.h:420] populateStationList(): Parameter:'stream-mz.planetradio.co.uk'
[V][stationSelectHelper.h:420] populateStationList(): Parameter:'80'
[V][stationSelectHelper.h:420] populateStationList(): Parameter:'/magicmellow.mp3'
[V][stationSelectHelper.h:420] populateStationList(): Parameter:'Mellow Magic (Redirected)'
[V][stationSelectHelper.h:420] populateStationList(): Parameter:'1'
[V][stationSelectHelper.h:496] addStationToArray(): Vector size:5
[V][stationSelectHelper.h:420] populateStationList(): Parameter:'edge-bauermz-03-gos2.sharp-stream.com'
[V][stationSelectHelper.h:420] populateStationList(): Parameter:'80'
[V][stationSelectHelper.h:420] populateStationList(): Parameter:'/net2national.mp3'
[V][stationSelectHelper.h:420] populateStationList(): Parameter:'Greatest Hits 112k (National)'
[V][stationSelectHelper.h:420] populateStationList(): Parameter:'1'
[V][stationSelectHelper.h:496] addStationToArray(): Vector size:6
[V][stationSelectHelper.h:420] populateStationList(): Parameter:'airspectrum.cdnstream1.com'
[V][stationSelectHelper.h:420] populateStationList(): Parameter:'8024'
[V][stationSelectHelper.h:420] populateStationList(): Parameter:'/1302_192'
[V][stationSelectHelper.h:420] populateStationList(): Parameter:'Mowtown Magic Oldies'
[V][stationSelectHelper.h:420] populateStationList(): Parameter:'1'
[V][stationSelectHelper.h:496] addStationToArray(): Vector size:7
[V][stationSelectHelper.h:420] populateStationList(): Parameter:'live-bauer-mz.sharp-stream.com'
[V][stationSelectHelper.h:420] populateStationList(): Parameter:'80'
[V][stationSelectHelper.h:420] populateStationList(): Parameter:'/magicmellow.aac'
[V][stationSelectHelper.h:420] populateStationList(): Parameter:'Mellow Magic (48k AAC)'
[V][stationSelectHelper.h:420] populateStationList(): Parameter:'1'
[V][stationSelectHelper.h:496] addStationToArray(): Vector size:8
[V][stationSelectHelper.h:420] populateStationList(): Parameter:'stream.btsstream.com'
[V][stationSelectHelper.h:420] populateStationList(): Parameter:'8000'
[V][stationSelectHelper.h:420] populateStationList(): Parameter:'/seaac'
[V][stationSelectHelper.h:420] populateStationList(): Parameter:'South East Radio (AAC 64k)'
[V][stationSelectHelper.h:420] populateStationList(): Parameter:'1'
[V][stationSelectHelper.h:496] addStationToArray(): Vector size:9
[V][stationSelectHelper.h:420] populateStationList(): Parameter:'uk2.internet-radio.com'
[V][stationSelectHelper.h:420] populateStationList(): Parameter:'8024'
[V][stationSelectHelper.h:420] populateStationList(): Parameter:'/'
[V][stationSelectHelper.h:420] populateStationList(): Parameter:'UK Dance Radio'
[V][stationSelectHelper.h:420] populateStationList(): Parameter:'1'
[V][stationSelectHelper.h:496] addStationToArray(): Vector size:10
[V][stationSelectHelper.h:420] populateStationList(): Parameter:'us4.internet-radio.com'
[V][stationSelectHelper.h:420] populateStationList(): Parameter:'8197'
[V][stationSelectHelper.h:420] populateStationList(): Parameter:'/stream?type=http&nocache=72'
[V][stationSelectHelper.h:420] populateStationList(): Parameter:'EZ Hits South FLA'
[V][stationSelectHelper.h:420] populateStationList(): Parameter:'0'
[V][stationSelectHelper.h:496] addStationToArray(): Vector size:11
[V][stationSelectHelper.h:420] populateStationList(): Parameter:'s1.slotex.pl'
[V][stationSelectHelper.h:420] populateStationList(): Parameter:'7274'
[V][stationSelectHelper.h:420] populateStationList(): Parameter:'/'
[V][stationSelectHelper.h:420] populateStationList(): Parameter:'Radio Kehlkopf'
[V][stationSelectHelper.h:420] populateStationList(): Parameter:'0'
[V][stationSelectHelper.h:496] addStationToArray(): Vector size:12
[V][stationSelectHelper.h:420] populateStationList(): Parameter:'204.187.100.18'
[V][stationSelectHelper.h:420] populateStationList(): Parameter:'1485'
[V][stationSelectHelper.h:420] populateStationList(): Parameter:'/'
[V][stationSelectHelper.h:420] populateStationList(): Parameter:'De Natchegaal'
[V][stationSelectHelper.h:420] populateStationList(): Parameter:'1'
[V][stationSelectHelper.h:496] addStationToArray(): Vector size:13
[V][stationSelectHelper.h:420] populateStationList(): Parameter:'live-bauer-mz.sharp-stream.com'
[V][stationSelectHelper.h:420] populateStationList(): Parameter:'80'
[V][stationSelectHelper.h:420] populateStationList(): Parameter:'/net2lincoln.aac'
[V][stationSelectHelper.h:420] populateStationList(): Parameter:'Greatest Hits (Lincoln)'
[V][stationSelectHelper.h:420] populateStationList(): Parameter:'1'
[V][stationSelectHelper.h:496] addStationToArray(): Vector size:14
[V][stationSelectHelper.h:420] populateStationList(): Parameter:'ais-edge09-live365-dal02.cdnstream.com'
[V][stationSelectHelper.h:420] populateStationList(): Parameter:'80'
[V][stationSelectHelper.h:420] populateStationList(): Parameter:'/a52107?listenerId=esAdblock0650048'
[V][stationSelectHelper.h:420] populateStationList(): Parameter:'Heckington Community Radio'
[V][stationSelectHelper.h:420] populateStationList(): Parameter:'1'
[V][stationSelectHelper.h:496] addStationToArray(): Vector size:15
[V][stationSelectHelper.h:420] populateStationList(): Parameter:'live-bauer-mz.sharp-stream.com'
[V][stationSelectHelper.h:420] populateStationList(): Parameter:'80'
[V][stationSelectHelper.h:420] populateStationList(): Parameter:'/net1lincoln.aac'
[V][stationSelectHelper.h:420] populateStationList(): Parameter:'Radio Lincs FM'
[V][stationSelectHelper.h:420] populateStationList(): Parameter:'1'
[V][stationSelectHelper.h:496] addStationToArray(): Vector size:16
[V][stationSelectHelper.h:420] populateStationList(): Parameter:'uk3.internet-radio.com'
[V][stationSelectHelper.h:420] populateStationList(): Parameter:'8405'
[V][stationSelectHelper.h:420] populateStationList(): Parameter:'/live'
[V][stationSelectHelper.h:420] populateStationList(): Parameter:'Majestic Jukebox'
[V][stationSelectHelper.h:420] populateStationList(): Parameter:'1'
[V][stationSelectHelper.h:496] addStationToArray(): Vector size:17
[V][stationSelectHelper.h:420] populateStationList(): Parameter:'198.58.106.133'
[V][stationSelectHelper.h:420] populateStationList(): Parameter:'8321'
[V][stationSelectHelper.h:420] populateStationList(): Parameter:'/stream'
[V][stationSelectHelper.h:420] populateStationList(): Parameter:'XRDS.fm  Clarksdale Mississippi'
[V][stationSelectHelper.h:496] addStationToArray(): Vector size:18
[I][stationSelectHelper.h:467] populateStationList(): Radio stations imported successfully.
[D][stationSelectHelper.h:478] populateStationList(): 0 - stream.antenne1.de /a1stg/livestream1.aac 80 (Antenne1.de) YES
[D][stationSelectHelper.h:478] populateStationList(): 1 - bbcmedia.ic.llnwd.net /stream/bbcmedia_radio4fm_mf_q 80 (BBC Radio 4) NO
[D][stationSelectHelper.h:478] populateStationList(): 2 - stream.antenne1.de /a1stg/livestream2.mp3 80 (Antenne1 128k) YES
[D][stationSelectHelper.h:478] populateStationList(): 3 - listen.181fm.com /181-beatles_128k.mp3 80 (Beatles 128k) YES
[D][stationSelectHelper.h:478] populateStationList(): 4 - stream-mz.planetradio.co.uk /magicmellow.mp3 80 (Mellow Magic (Redirected)) YES
[D][stationSelectHelper.h:478] populateStationList(): 5 - edge-bauermz-03-gos2.sharp-stream.com /net2national.mp3 80 (Greatest Hits 112k (National)) YES
[D][stationSelectHelper.h:478] populateStationList(): 6 - airspectrum.cdnstream1.com /1302_192 8024 (Mowtown Magic Oldies) YES
[D][stationSelectHelper.h:478] populateStationList(): 7 - live-bauer-mz.sharp-stream.com /magicmellow.aac 80 (Mellow Magic (48k AAC)) YES
[D][stationSelectHelper.h:478] populateStationList(): 8 - stream.btsstream.com /seaac 8000 (South East Radio (AAC 64k)) YES
[D][stationSelectHelper.h:478] populateStationList(): 9 - uk2.internet-radio.com / 8024 (UK Dance Radio) YES
[D][stationSelectHelper.h:478] populateStationList(): 10 - us4.internet-radio.com /stream?type=http&nocache=72 8197 (EZ Hits South FLA) NO
[D][stationSelectHelper.h:478] populateStationList(): 11 - s1.slotex.pl / 7274 (Radio Kehlkopf) NO
[D][stationSelectHelper.h:478] populateStationList(): 12 - 204.187.100.18 / 1485 (De Natchegaal) YES
[D][stationSelectHelper.h:478] populateStationList(): 13 - live-bauer-mz.sharp-stream.com /net2lincoln.aac 80 (Greatest Hits (Lincoln)) YES
[D][stationSelectHelper.h:478] populateStationList(): 14 - ais-edge09-live365-dal02.cdnstream.com /a52107?listenerId=esAdblock0650048 80 (Heckington Community Radio) YES
[D][stationSelectHelper.h:478] populateStationList(): 15 - live-bauer-mz.sharp-stream.com /net1lincoln.aac 80 (Radio Lincs FM) YES
[D][stationSelectHelper.h:478] populateStationList(): 16 - uk3.internet-radio.com /live 8405 (Majestic Jukebox) YES
[D][stationSelectHelper.h:478] populateStationList(): 17 - 198.58.106.133 /stream 8321 (XRDS.fm  Clarksdale Mississippi) YES
[I][stationSelectHelper.h:83] stationSelectSetup(): Total stations found: 18
[D][stationSelectHelper.h:87] stationSelectSetup(): This will require 4 pages
[V][ESP32-WROVER_Web_Radio.ino:599] readLITTLEFSInfo(): Looking for key 'SSID'
[D][ESP32-WROVER_Web_Radio.ino:662] readLITTLEFSInfo(): LITTLEFS parameter 'SSID'
[V][ESP32-WROVER_Web_Radio.ino:599] readLITTLEFSInfo(): Looking for key 'WiFiPassword'
[D][ESP32-WROVER_Web_Radio.ino:662] readLITTLEFSInfo(): LITTLEFS parameter 'WiFiPassword'
[D][wifiHelpers.h:8] connectToWifi(): -----------------------------------
[D][wifiHelpers.h:9] connectToWifi(): Connecting to SSID: ASUSBUCK_45
[D][wifiHelpers.h:10] connectToWifi(): -----------------------------------
[D][wifiHelpers.h:21] connectToWifi(): Setting ESP32 to STA mode
[D][WiFiGeneric.cpp:337] _eventCallback(): Event: 0 - WIFI_READY
[D][WiFiGeneric.cpp:337] _eventCallback(): Event: 2 - STA_START
[D][wifiHelpers.h:25] connectToWifi(): Setting ESP32 to NOT store credentials in NVR
[D][wifiHelpers.h:29] connectToWifi(): Setting ESP32 to NOT allow sleep
[D][wifiHelpers.h:32] connectToWifi(): Setting ESP32 to ALLOW auto re-connect
[D][wifiHelpers.h:44] connectToWifi(): Initiating connection with WiFi.
[D][wifiHelpers.h:47] connectToWifi(): Setting ESP32 to REDUCE maximum transmit power
[D][WiFiGeneric.cpp:337] _eventCallback(): Event: 4 - STA_CONNECTED
[D][WiFiGeneric.cpp:337] _eventCallback(): Event: 7 - STA_GOT_IP
[D][WiFiGeneric.cpp:381] _eventCallback(): STA IP: 192.168.1.229, MASK: 255.255.255.0, GW: 192.168.1.1
[D][wifiHelpers.h:53] connectToWifi(): Waiting for WiFi connection...
[D][wifiHelpers.h:63] connectToWifi(): WiFi connected with (local) IP address of: 192.168.1.229
[D][ESP32-WROVER_Web_Radio.ino:181] setup(): Current station 0 appears on page 0
[V][tftHelpers.h:809] displayTrackArtist(): No delimiter found - using default value
[D][ESP32-WROVER_Web_Radio.ino:185] setup(): Current station number: 0
[D][ESP32-WROVER_Web_Radio.ino:388] stationConnect(): -----------------------------------
[D][ESP32-WROVER_Web_Radio.ino:389] stationConnect():      Connecting to station 0
[D][ESP32-WROVER_Web_Radio.ino:390] stationConnect(): -----------------------------------
[D][ESP32-WROVER_Web_Radio.ino:391] stationConnect(): HOST: stream.antenne1.de
[D][ESP32-WROVER_Web_Radio.ino:392] stationConnect(): PATH: /a1stg/livestream1.aac
[D][ESP32-WROVER_Web_Radio.ino:393] stationConnect(): PORT: 80
[D][ESP32-WROVER_Web_Radio.ino:394] stationConnect(): NAME: Antenne1.de
[D][ESP32-WROVER_Web_Radio.ino:395] stationConnect(): DATA: Yes
[D][ESP32-WROVER_Web_Radio.ino:977] fadeOutMusic(): Fading music OUT
[V][ESP32-WROVER_Web_Radio.ino:409] stationConnect(): Player volume now: 0
[D][ESP32-WROVER_Web_Radio.ino:412] stationConnect(): Circ buffer FLUSHED
[I][ESP32-WROVER_Web_Radio.ino:417] stationConnect(): Free memory: 137260 bytes
[V][tftHelpers.h:809] displayTrackArtist(): No delimiter found - using default value
[D][ESP32-WROVER_Web_Radio.ino:449] stationConnect(): Host: stream.antenne1.de Port:80
[D][ESP32-WROVER_Web_Radio.ino:469] stationConnect(): Connected to stream.antenne1.de (Antenne1.de)
[V][tftHelpers.h:809] displayTrackArtist(): No delimiter found - using default value
[I][ESP32-WROVER_Web_Radio.ino:478] stationConnect(): Getting data from /a1stg/livestream1.aac (WITH Metadata)
[D][ESP32-WROVER_Web_Radio.ino:487] stationConnect(): Waiting for header data
[V][ESP32-WROVER_Web_Radio.ino:526] stationConnect(): HEADER: ⸮⸮⸮?
[V][ESP32-WROVER_Web_Radio.ino:526] stationConnect(): HEADER: ⸮⸮⸮?
[V][ESP32-WROVER_Web_Radio.ino:526] stationConnect(): HEADER: ⸮⸮⸮?
[V][ESP32-WROVER_Web_Radio.ino:526] stationConnect(): HEADER: icy-br:64
[V][ESP32-WROVER_Web_Radio.ino:542] stationConnect(): Bit rate:64
[V][ESP32-WROVER_Web_Radio.ino:526] stationConnect(): HEADER: ⸮⸮⸮?O
[V][ESP32-WROVER_Web_Radio.ino:526] stationConnect(): HEADER: icy-br:64
[V][ESP32-WROVER_Web_Radio.ino:542] stationConnect(): Bit rate:64
[V][ESP32-WROVER_Web_Radio.ino:526] stationConnect(): HEADER: ⸮⸮⸮?O
[V][ESP32-WROVER_Web_Radio.ino:526] stationConnect(): HEADER: ⸮⸮⸮?
[V][ESP32-WROVER_Web_Radio.ino:526] stationConnect(): HEADER: ⸮⸮⸮?
[V][ESP32-WROVER_Web_Radio.ino:526] stationConnect(): HEADER: ⸮⸮⸮?
[V][ESP32-WROVER_Web_Radio.ino:526] stationConnect(): HEADER: icy-pub:1
[V][ESP32-WROVER_Web_Radio.ino:526] stationConnect(): HEADER: ⸮⸮⸮?
[V][ESP32-WROVER_Web_Radio.ino:526] stationConnect(): HEADER: ⸮⸮⸮?
[V][ESP32-WROVER_Web_Radio.ino:526] stationConnect(): HEADER: ⸮⸮⸮?/
[V][ESP32-WROVER_Web_Radio.ino:526] stationConnect(): HEADER: ⸮⸮⸮?
[V][ESP32-WROVER_Web_Radio.ino:526] stationConnect(): HEADER: ⸮⸮⸮?
[V][ESP32-WROVER_Web_Radio.ino:526] stationConnect(): HEADER: ⸮⸮⸮?O
[V][ESP32-WROVER_Web_Radio.ino:526] stationConnect(): HEADER: ⸮⸮⸮??
[V][ESP32-WROVER_Web_Radio.ino:526] stationConnect(): HEADER: ⸮⸮⸮?
[V][ESP32-WROVER_Web_Radio.ino:526] stationConnect(): HEADER: ⸮⸮⸮?/
[V][ESP32-WROVER_Web_Radio.ino:526] stationConnect(): HEADER: ⸮⸮⸮?
[D][ESP32-WROVER_Web_Radio.ino:534] stationConnect(): NEW Metadata Interval:16000
[D][ESP32-WROVER_Web_Radio.ino:221] setup(): Restored screen brightness to 215
[D][ESP32-WROVER_Web_Radio.ino:227] setup(): Free memory: 126476 bytes
[D][ESP32-WROVER_Web_Radio.ino:763] readMetaData(): Metadata block size: 48
[D][ESP32-WROVER_Web_Radio.ino:766] readMetaData(): Waiting for METADATA
[D][ESP32-WROVER_Web_Radio.ino:780] readMetaData(): MetaData: StreamTitle='MAX GIESINGER - LEGENDEN';
[I][ESP32-WROVER_Web_Radio.ino:833] readMetaData(): MAX GIESINGER - LEGENDEN
[V][tftHelpers.h:783] displayTrackArtist(): Found delimiter at position 13
[D][tftHelpers.h:788] displayTrackArtist(): Artist: 'Max Giesinger'
[D][tftHelpers.h:793] displayTrackArtist(): Title: 'Legenden'
[W][ESP32-WROVER_Web_Radio.ino:361] populateRingBuffer(): Unable to read data from the stream, attempt:1
[V][tftHelpers.h:232] drawPercentageLine(): Volume 50, volume line length 5
[V][tftHelpers.h:232] drawPercentageLine(): Volume 50, volume line length 5
[V][tftHelpers.h:232] drawPercentageLine(): Volume 50, volume line length 5
[V][tftHelpers.h:232] drawPercentageLine(): Volume 50, volume line length 5
[V][tftHelpers.h:232] drawPercentageLine(): Volume 50, volume line length 5
[V][tftHelpers.h:232] drawPercentageLine(): Volume 60, volume line length 25
[V][tftHelpers.h:232] drawPercentageLine(): Volume 61, volume line length 27
[V][tftHelpers.h:232] drawPercentageLine(): Volume 62, volume line length 29
[V][tftHelpers.h:232] drawPercentageLine(): Volume 63, volume line length 31
[V][tftHelpers.h:232] drawPercentageLine(): Volume 64, volume line length 33
[V][tftHelpers.h:232] drawPercentageLine(): Volume 65, volume line length 35
[V][tftHelpers.h:232] drawPercentageLine(): Volume 66, volume line length 37
[V][tftHelpers.h:232] drawPercentageLine(): Volume 67, volume line length 40
[V][tftHelpers.h:232] drawPercentageLine(): Volume 68, volume line length 42
[V][tftHelpers.h:232] drawPercentageLine(): Volume 69, volume line length 44
[V][tftHelpers.h:232] drawPercentageLine(): Volume 70, volume line length 46
[V][tftHelpers.h:232] drawPercentageLine(): Volume 71, volume line length 48
[V][tftHelpers.h:232] drawPercentageLine(): Volume 72, volume line length 50
[V][tftHelpers.h:232] drawPercentageLine(): Volume 73, volume line length 52
[V][tftHelpers.h:232] drawPercentageLine(): Volume 74, volume line length 54
[V][tftHelpers.h:232] drawPercentageLine(): Volume 75, volume line length 56
[V][tftHelpers.h:232] drawPercentageLine(): Volume 76, volume line length 58
[V][tftHelpers.h:232] drawPercentageLine(): Volume 77, volume line length 60
[V][tftHelpers.h:232] drawPercentageLine(): Volume 78, volume line length 62
[V][tftHelpers.h:232] drawPercentageLine(): Volume 79, volume line length 64
[V][tftHelpers.h:232] drawPercentageLine(): Volume 80, volume line length 66
[V][tftHelpers.h:232] drawPercentageLine(): Volume 81, volume line length 68
[V][tftHelpers.h:232] drawPercentageLine(): Volume 82, volume line length 70
[V][tftHelpers.h:232] drawPercentageLine(): Volume 83, volume line length 72
[V][tftHelpers.h:232] drawPercentageLine(): Volume 84, volume line length 75
[V][tftHelpers.h:232] drawPercentageLine(): Volume 85, volume line length 77
[V][tftHelpers.h:232] drawPercentageLine(): Volume 86, volume line length 79
[V][tftHelpers.h:232] drawPercentageLine(): Volume 87, volume line length 81
[V][tftHelpers.h:232] drawPercentageLine(): Volume 88, volume line length 83
[V][tftHelpers.h:232] drawPercentageLine(): Volume 89, volume line length 85
[V][tftHelpers.h:232] drawPercentageLine(): Volume 90, volume line length 87
[V][tftHelpers.h:232] drawPercentageLine(): Volume 91, volume line length 89
[V][tftHelpers.h:232] drawPercentageLine(): Volume 92, volume line length 91
[V][tftHelpers.h:232] drawPercentageLine(): Volume 93, volume line length 93
[V][tftHelpers.h:232] drawPercentageLine(): Volume 94, volume line length 95
[V][tftHelpers.h:232] drawPercentageLine(): Volume 95, volume line length 97
[V][tftHelpers.h:232] drawPercentageLine(): Volume 96, volume line length 99
[V][tftHelpers.h:232] drawPercentageLine(): Volume 97, volume line length 101
[V][tftHelpers.h:232] drawPercentageLine(): Volume 98, volume line length 103
[V][tftHelpers.h:232] drawPercentageLine(): Volume 99, volume line length 105
Guru Meditation Error: Core  1 panic'ed (Unhandled debug exception)
Debug exception reason: BREAK instr
Core 1 register dump:
PC      : 0x400803c0  PS      : 0x00060736  A0      : 0x00000001  A1      : 0x3ffd1530
A2      : 0x800976a2  A3      : 0x00000000  A4      : 0x00000001  A5      : 0x400e56a6
A6      : 0x7dc8bf9b  A7      : 0x58a6ead8  A8      : 0x800d81fd  A9      : 0xc8bf9b59
A10     : 0x3ffc157c  A11     : 0x00000003  A12     : 0x00000050  A13     : 0x3ffb1cb0
A14     : 0x00000000  A15     : 0x3ffd1690  SAR     : 0x00000018  EXCCAUSE: 0x00000001
EXCVADDR: 0x800976a2  LBEG    : 0x4000c349  LEND    : 0x4000c36b  LCOUNT  : 0x00000000

Backtrace: 0x400803c0:0x3ffd1530 0x7ffffffe:0x3ffd1610 0x400d2787:0x3ffd1630 0x400d27c6:0x3ffd1650 0x4008c8f1:0x3ffd1670

Rebooting...
ets Jun  8 2016 00:22:57

rst:0xc (SW_CPU_RESET),boot:0x13 (SPI_FAST_FLASH_BOOT)
configsip: 0, SPIWP:0xee
clk_drv:0x00,q_drv:0x00,d_drv:0x00,cs0_drv:0x00,hd_drv:0x00,wp_drv:0x00
mode:DIO, clock div:1
load:0x3fff0018,len:4
load:0x3fff001c,len:1216
ho 0 tail 12 room 4
load:0x40078000,len:9720
ho 0 tail 12 room 4
load:0x40080400,len:6352
entry 0x400806b8
[D][esp32-hal-psram.c:47] psramInit(): PSRAM enabled
[E][ESP32-WROVER_Web_Radio.ino:27] setup(): Version v1.210126_29 - 2021-01-26 10:39:16.425885
[D][ESP32-WROVER_Web_Radio.ino:35] setup(): Total heap: 321148
[D][ESP32-WROVER_Web_Radio.ino:36] setup(): Free heap: 195120
[D][ESP32-WROVER_Web_Radio.ino:37] setup(): Total PSRAM: 4194252
[D][ESP32-WROVER_Web_Radio.ino:38] setup(): Free PSRAM: 4194252
[D][ESP32-WROVER_Web_Radio.ino:39] setup(): Used PSRAM: 0
[D][ESP32-WROVER_Web_Radio.ino:47] setup(): Starting SPI
[D][ESP32-WROVER_Web_Radio.ino:51] setup(): Free memory: 194996 bytes
[I][ESP32-WROVER_Web_Radio.ino:62] setup(): LITTLEFS system mounted SUCCESSFUL.
[V][tftHelpers.h:80] initDisplay(): TFT Calibration data:
[V][tftHelpers.h:83] initDisplay(): 0179,
[V][tftHelpers.h:83] initDisplay(): 0DD2,
[I][tftHelpers.h:87] initDisplay(): Touch Calibration completed
[V][bitmapHelper.h:74] drawBmp(): Loaded in 4l ms
[V][bitmapHelper.h:74] drawBmp(): Loaded in 6l ms
[V][bitmapHelper.h:74] drawBmp(): Loaded in 5l ms
[I][tftHelpers.h:206] setupDisplayModule(): TFT Initialised
[D][ESP32-WROVER_Web_Radio.ino:70] setup(): Starting player
[V][tftHelpers.h:809] displayTrackArtist(): No delimiter found - using default value
[V][tftHelpers.h:809] displayTrackArtist(): No delimiter found - using default value

RalphBacon, 2021-01-27:
@tadder
The key point to note here is that PSRAM is enabled (by default on the WROVER board) but is NOT being used:

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

You need to add the "patch" (it's only a one line change) by following the instructions in the Circular Buffer folder (part of the Arduino IDE Version folder).

The reboot seems to indicate that you're running out of memory but even if it does allocate the 10K circular buffer in SRAM it should not cause a reboot. I'm suspicious of the 10000 (10K) buffer you say you have allocated, compare the output from my startup:

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
According to this I have an extra 100K of SRAM for the program to run in!

Also, check that the SPI frequency set to 40MHz (not 80Mhz which can cause issues)?

Try the circular buffer "hack" as described and let me see the debug output from a clean reboot (I need to see the stuff right at the start of the output, as shown in my snip above).

tadder, 2021-01-27:
Just to confirm I copied cbuf.cpp direct (the entire file) from Arduino IDE Version/Circular Buffer on github. However to double check here is the code:

// RSB Use PSRAM here if required
	char *newbuf;
	if (BOARD_HAS_PSRAM)
	{
		newbuf = (char *)ps_malloc(newSize);
	}
	else
	{
		newbuf = new char[newSize];
	}
	char *oldbuf = _buf;

To confirm Circular Buffer Size here is the relevant code in main.h. I assume I have the correct file?

// Circular "Read Buffer" to stop stuttering on some stations
#ifdef BOARD_HAS_PSRAM
#define CIRCULARBUFFERSIZE 10000 // Divide by 32 to see how many 2mS samples this can store
#else
#define
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

Thread 10 (2021-02-09):

PSRAM

tadder, 2021-02-09:
Circular (Ring) Buffer

As suggested before my ESP32 went to the PCB bin in the sky, I have carried out a new implementation of the Arduino IDE (1.8.13) on my laptop. I have downloaded the alternative version of “cbuf.cpp” from the Circular Buffer section in github (205-Internet-Radio) and this I have placed in:
C:\Users\Tadder\AppData\Local\Arduino15\packages\esp32\hardware\esp32\1.0.4\cores\esp32

I confirm that the CIRCULARBUFFERSIZE is set at 10,000

As can be seen from the following output PSRAM is enabled, but Used PSRAM still reports 0.
Any further thoughts?

ets Jun  8 2016 00:22:57

rst:0x1 (POWERON_RESET),boot:0x13 (SPI_FAST_FLASH_BOOT)
configsip: 0, SPIWP:0xee
clk_drv:0x00,q_drv:0x00,d_drv:0x00,cs0_drv:0x00,hd_drv:0x00,wp_drv:0x00
mode:DIO, clock div:1
load:0x3fff0018,len:4
load:0x3fff001c,len:1216
ho 0 tail 12 room 4
load:0x40078000,len:9720
ho 0 tail 12 room 4
load:0x40080400,len:6352
entry 0x400806b8
[D][esp32-hal-psram.c:47] psramInit(): PSRAM enabled
[E][ESP32-WROVER_Web_Radio.ino:27] setup(): Version v1.210126_29 - 2021-01-26 10:39:16.425885
[D][ESP32-WROVER_Web_Radio.ino:35] setup(): Total heap: 321172
[D][ESP32-WROVER_Web_Radio.ino:36] setup(): Free heap: 285232
[D][ESP32-WROVER_Web_Radio.ino:37] setup(): Total PSRAM: 4194252
[D][ESP32-WROVER_Web_Radio.ino:38] setup(): Free PSRAM: 4194252
[D][ESP32-WROVER_Web_Radio.ino:39] setup(): Used PSRAM: 0
[D][ESP32-WROVER_Web_Radio.ino:47] setup(): Starting SPI
[D][ESP32-WROVER_Web_Radio.ino:51] setup(): Free memory: 285108 bytes
[I][ESP32-WROVER_Web_Radio.ino:62] setup(): LITTLEFS system mounted SUCCESSFUL.
[V][tftHelpers.h:80] initDisplay(): TFT Calibration data:
[V][tftHelpers.h:83] initDisplay(): 0179,
[V][tftHelpers.h:83] initDisplay(): 0DD2,
[I][tftHelpers.h:87] initDisplay(): Touch Calibration completed
[V][bitmapHelper.h:74] drawBmp(): Loaded in 6l ms
[V][bitmapHelper.h:74] drawBmp(): Loaded in 9l ms
[V][bitmapHelper.h:74] drawBmp(): Loaded in 9l ms
[I][tftHelpers.h:206] setupDisplayModule(): TFT Initialised
[D][ESP32-WROVER_Web_Radio.ino:70] setup(): Starting player
[V][tftHelpers.h:809] displayTrackArtist(): No delimiter found - using default value
[D][ESP32-WROVER_Web_Radio.ino:86] setup(): Waiting for VS1053 initialisation to complete.
[V][tftHelpers.h:809] displayTrackArtist(): No delimiter found - using default value
[D][ESP32-WROVER_Web_Radio.ino:97] setup(): Switch player to MP3 mode
[V][tftHelpers.h:809] displayTrackArtist(): No delimiter found - using default value

RalphBacon, 2021-02-09:
Another maker (see the previous thread on this topic) reinstalled everything including the Arduino IDE, ESP32 boards and it all "just worked" without any hacks required. It also seemed to depend on where he took the Arduino IDE code from and what version of Windows he ran (7 or 10).

However, back to your issue, that is a clear sign that PSRAM is not being used. Try removing just the ESP32 board(s) so that everything in this folder (and below) should disappear:
`C:\Users\Tadder\AppData\Local\Arduino15\packages\esp32\hardware\esp32\1.0.4\`
Then reinstall the ESP32 boards (and hence environment) and check the cbuf.cpp to see whether it is the updated version that requires no hack. If it still has the edited hack then it is not being replaced by doing the above. You might have to manually deep clean it all and try again.

When you recompile, look very closely at the output from the compiler. It is is using a cached, previously compiled version you will have to delete that to force a new compilation. But I don't fully understand why the Arduino behaviour is so different from that of PlatformIO. Talk about confusing us all.

tadder, 2021-02-11:
Yes, I remember the other maker and the ‘cure’ that worked for him. I am using Windows 10 Pro and downloaded the Arduino IDE (1.8.13) from www.arduino.cc/en/Main/Software&.
As you suggested I removed the ESP32 core and confirm that everything in
C:\Users\Tadder\AppData\Local\Arduino15\packages\esp32\hardware\esp32\1.0.4\
did disappear. Once the core was reloaded (via the Expressif link in additional board manager) cbuf.cpp was indeed a new version.
Unfortunately PSRAM usage is still 0. I cannot see any reference in the compiler output to a previously cached version being used.

The fact that I appear to be the only one of your Arduino IDE users having an issue is worrying and I am very aware of taking up a significant amount of you time. I therefore think the best way forward is for me to attempt to utilise PlatformIO as this clearly works for you. The process of working out how to import your code into my copy of PlatformIO seems to be my biggest challenge, but once I have conquered that hurdle I will hopefully be on the road to a solution. The project is currently working well with the odd ‘hiccup’ due to buffering issues, so although not urgent I would rather not be beaten by this. Challenges like this are what being an “Arduinoite” is all about (he said with his positive hat on).

RalphBacon, 2021-07-21:
New version v1.35 for the Arduino IDE now available.

Closed 2021-07-21.

Thread 9 (2021-02-09):

Static Issues

tadder, 2021-02-09:
"At this point I'd suspect that you are zapping the devices with static electricity. If they are all connected up via the USB socket (but with the switch set to OFF, so the main unit is not powered via it) then they are grounded. If you then switch them on and off via a wall wart (mains switch, don't keep unplugging them) they should last. It's too easy to zap devices with static (thankfully rare, though) so try the above of keeping them connected to a GND point. And don't physically touch them!"

The first of my replacement ESP32 has arrived and has been flashed OK.
Exactly what switch are you referring to above?

In the future I shall treat the board with a little more respect and be less cavalier with my static precautions.

But, your suggestion has got me thinking (always dangerous). In my setup, power reaches the WebRadio by two routes:
    1. Via USB connected to my PC, usually only when flashing, but sometimes concurrent with -
    2. Bench PSU (Tenma 72-2690) to a barrel jack connected to the main PCB +5V.

However, I don’t currently strap the PSU negative to GND, so I wonder is it possible that allowing this to float combined with the USB derived power could result in excessive voltage?
I’m not very o fay with this subject, but my limited research would suggest that this is at least theoretically possible?

RalphBacon, 2021-02-09:
There is a slide switch near the battery connector (assuming you have a TTGO T8-style unit) on the LHS when viewed from the battery connector end. Push that _away_ from the USB socket end. This now means that the USB cable will only power the serial interface but not the ESP32 and other circuitry. Using two power sources simultaneously is often fraught with danger as power can flow in the wrong direction (eg into a laptop's USB port with potentially disastrous consequences). You'll know when you have done this correctly because the PC will identify a COM port but the ESP32 (and screen etc) will not be running.

My unit is powered by a wall wart-type phone charger, 5v (about 2A but I take that with a pinch of salt). It's not connected to ground. The USB cable is, of course, connected to ground via my PC and I have noticed that if I (dis)connect the cable it can cause lockups. Hence I leave it connected all the time on one of my units so I can monitor the serial output. The other is not connected via the USB at all (except when I infrequently reflash an updated program).

I'd want to check the Tenma power supply on a scope to see what happens when you switch it on (or off). Is there a spike, however brief? It's the same PSU as I have and I've never experienced any issues whilst prototyping with it but you never know. You might want to consider a dedicated wall wart charger (a better quality one, not a cheap Chinese one that delivers 6v @ 100mA). When I built my mum's Home Alone (movement alert) monitor, I bought a medical grade plug-in PSU just to be safe. Yeah, cost about 5 times what a cheap Asian brand would sell at.

Now, I don't think you will get excessive voltage with your setup, but unless you actually check it you won't know. I'd suspect the static zapping by you touching the device rather than that. You can mitigate that risk by earthing yourself via a wrist band (connected to mains earth via a built-in 1MΩ resistor - some don't have the resistor which are death traps!) Alternatively, don't touch the device, especially not the pins, just the edge of the board. And touch a GND connector first to discharge any static you are carrying.

I'll leave you to setting this up and getting it running - good luck and no more failed devices! My two units are running all day (no longer overnight, my soak testing is now complete) without an issue.

tadder, 2021-02-11:
I have checked the output of my PSU with a scope and as far as I can see it’s very clean. There is no visible sign of any spikes although I have to accept if it was very fast It wouldn't show. But on balance I would say this is not my problem.

So I will continue to implement the suggestions you have made re static precautions. Thanks as always for sharing your knowledge.

I will now close this issue.

tadder, 2021-08-08:
The following may be of interest just for the record:
After replacing the ESP32 WROVER board in February everything has worked fine. However, the other day I went to switch the project on and my finger slipped off the ‘POWER’ switch (on my Tenma PSU). I surmise that this may have sent a spike to the board, because afterward it was dead. Did some fault finding which with my competence level is pretty much restricted to ensuring VCC is present (it was). Luckily after the problems earlier in the year I had a spare in the draw and after replacing the dead unit everything jumped back to life.
I now have three ESP 32 WROVER boards that are RIP. They do appear to be a little sensitive to power glitches. I have now moved to using a WallWart PSU, lets hope this stops me consuming the boards which are this year costing in excess of £10 a piece.

RalphBacon, 2021-08-08:
Condolences on your loss.

However, I have to admit I would never leave an item connected to my Tenma PSU then switch the PSU on. At switch on there could easily be a surge, spike or some other nasty. I  always switch on the PSU, _then_ connect any equipment.

Maybe you were unlucky, but a lesson learned for us all, for sure.

Regarding sensitivity of the ESP32 modules, I noticed that if I even _touch_ the GND connection (eg via the USB cable) with another cable (ie the metal outer sheath of another cable to a spare USB socket) my ESP32 will crash/hang. A power on reset sorts it out. Drives me nuts, but luckily the ESP32 is pretty much a floating ground device as long as the USB cable is not attached (I power mine from a wall-wart and the audio output is isolated via those tiny transformers).

tadder, 2021-08-09:
I have the project power connected via a standard barrel jack. The irony is that I switched on my Tenma after connecting for the very reason (I thought) that this would ensure a clean connection i.e. no potential fiddling around with the jack trying to make a connection whilst the power alternatively made and unmade its connection due to my fumbling hands. I suspect from what you say, that my thinking is flawed as far as this goes.
At the time I was experimenting with adding extra stations to the list. This involved much trial and error and subsequent multiple downloads to the data folder. It therefore seemed to make sense to retain the USB connection at least while developing.

Closed 2021-08-13.

Thread 11 (2021-02-13):

Using PlatformIO with the Code from this github

tadder, 2021-02-13:
I am attempting to get to grips with platformio. I have successfully compiled and loaded to a TTGO T8 a blink sketch. But so far no luck with the Web Radio Sketch.

In the Sketch folder you have a README.md file that states:
### For PlatformIO
This is the complete project, you know what to do to include it into your workspace. (Note, you may need to edit your workspace folder at the same level as your Project's folder) to something like this:
```
"folders": [
		{
			"name": "ESP32 Better Internet Radio",
			"path": "Projects\\ESP32 Better Internet Radio"
		}
	],
  ```
  It will then appear in PlatformIO's workspace list of projects.

When I attempt to compile it throws up a number of ‘include’ errors and I suspect it may be something to do with ‘levels’ Can you explain what you mean by the above please?
Maybe I need to get up to speed with vcpkg package manager?

RalphBacon, 2021-02-14:
If you find my email address in the about tab of my channel here: https://www.youtube.com/c/RalphBacon/about and click on the Show Email Address button (this won't work using a phone BTW) then we can communicate via email.

I've just created a new VM running Window 10 so I can (eventually) show Arduinites how to install PlatformIO (for this project, ostensibly, but it will apply for all uses) and all the things I did to get it to work so wonderfully well!

Closed 2021-07-21.

Thread 12 (2021-02-23):

compile issue

pipikupi, 2021-02-23:
hi
durring compilation had some errors how can I deal with it ?
Thanks indeed

In file included from C:\Users\user\AppData\Local\Temp\arduino_build_369445\sketch\main.h:40:0,
                 from C:\Users\user\Documents\Arduino\ESP32-WROVER_Web_Radio\ESP32-WROVER_Web_Radio.ino:2:
C:\Users\user\Documents\Arduino\libraries\TFT_eSPI/TFT_eSPI.h:368:25: error: 'TFT_WIDTH' was not declared in this scope
   TFT_eSPI(int16_t _W = TFT_WIDTH, int16_t _H = TFT_HEIGHT);
                         ^
C:\Users\user\Documents\Arduino\libraries\TFT_eSPI/TFT_eSPI.h:368:49: error: 'TFT_HEIGHT' was not declared in this scope
   TFT_eSPI(int16_t _W = TFT_WIDTH, int16_t _H = TFT_HEIGHT);
                                                 ^
In file included from C:\Users\user\Documents\Arduino\ESP32-WROVER_Web_Radio\ESP32-WROVER_Web_Radio.ino:2:0:
main.h:211:25: error: call to 'TFT_eSPI::TFT_eSPI(int16_t, int16_t)' uses the default argument for parameter 1, which is not yet defined
 TFT_eSPI tft = TFT_eSPI();
                         ^
main.h:211:25: error: call to 'TFT_eSPI::TFT_eSPI(int16_t, int16_t)' uses the default argument for parameter 2, which is not yet defined
In file included from C:\Users\user\Documents\Arduino\ESP32-WROVER_Web_Radio\ESP32-WROVER_Web_Radio.ino:3:0:
C:\Users\user\AppData\Local\Temp\arduino_build_369445\sketch\tftHelpers.h: In function 'void initDisplay()':
tftHelpers.h:78:9: error: 'class TFT_eSPI' has no member named 'setTouch'
     tft.setTouch(calData);
         ^
C:\Users\user\AppData\Local\Temp\arduino_build_369445\sketch\tftHelpers.h: In function 'void setupDisplayModule(bool)':
tftHelpers.h:151:19: error: 'FreeSansBold12pt7b' was not declared in this scope
  tft.setFreeFont(&FreeSansBold12pt7b);
                   ^
C:\Users\user\AppData\Local\Temp\arduino_build_369445\sketch\tftHelpers.h: In function 'void drawStnChangeButton()':
tftHelpers.h:304:19: error: 'FreeSansBold12pt7b' was not declared in this scope
  tft.setFreeFont(&FreeSansBold12pt7b);
                   ^
C:\Users\user\AppData\Local\Temp\arduino_build_369445\sketch\tftHelpers.h: In function 'void drawPlusButton(bool)':
tftHelpers.h:351:19: error: 'FreeSansBold12pt7b' was not declared in this scope
  tft.setFreeFont(&FreeSansBold12pt7b);
                   ^
C:\Users\user\AppData\Local\Temp\arduino_build_369445\sketch\tftHelpers.h: In function 'void drawMinusButton(bool)':
tftHelpers.h:357:19: error: 'FreeSansBold12pt7b' was not declared in this scope
  tft.setFreeFont(&FreeSansBold12pt7b);
                   ^
C:\Users\user\AppData\Local\Temp\arduino_build_369445\sketch\tftHelpers.h: In function 'void drawBufferLevel(size_t, bool)':
tftHelpers.h:423:21: error: 'FreeSans9pt7b' was not declared in this scope
    tft.setFreeFont(&FreeSans9pt7b);
                     ^
C:\Users\user\AppData\Local\Temp\arduino_build_369445\sketch\tftHelpers.h: In function 'bool getStnChangeButtonPress()':
tftHelpers.h:436:24: error: 'class TFT_eSPI' has no member named 'getTouch'
  boolean pressed = tft.getTouch(&t_x, &t_y, 50);
                        ^
C:\Users\user\AppData\Local\Temp\arduino_build_369445\sketch\tftHelpers.h: In function 'void getPlusButtonPress()':
tftHelpers.h:472:25: error: 'class TFT_eSPI' has no member named 'getTouch'
   boolean pressed = tft.getTouch(&t_x, &t_y);
                         ^
C:\Users\user\AppData\Local\Temp\arduino_build_369445\sketch\tftHelpers.h: In function 'void getMinusButtonPress()':
tftHelpers.h:548:25: error: 'class TFT_eSPI' has no member named 'getTouch'
   boolean pressed = tft.getTouch(&t_x, &t_y);
                         ^
C:\Users\user\AppData\Local\Temp\arduino_build_369445\sketch\tftHelpers.h: In function 'void getSpkrButtonPress()':
tftHelpers.h:624:25: error: 'class TFT_eSPI' has no member named 'getTouch'
   boolean pressed = tft.getTouch(&t_x, &t_y, 20);
                         ^
C:\Users\user\AppData\Local\Temp\arduino_build_369445\sketch\tftHelpers.h: In function 'void getBulbButtonPress()':
tftHelpers.h:714:25: error: 'class TFT_eSPI' has no member named 'getTouch'
   boolean pressed = tft.getTouch(&t_x, &t_y, 50);
                         ^
C:\Users\user\AppData\Local\Temp\arduino_build_369445\sketch\tftHelpers.h: In function 'void displayStationName(std::__cxx11::string)':
tftHelpers.h:755:19: error: 'FreeSansOblique12pt7b' was not declared in this scope
  tft.setFreeFont(&FreeSansOblique12pt7b);
                   ^
C:\Users\user\AppData\Local\Temp\arduino_build_369445\sketch\tftHelpers.h: In function 'void displayTrackArtist(std::__cxx11::string)':
tftHelpers.h:819:19: error: 'FreeSans9pt7b' was not declared in this scope
  tft.setFreeFont(&FreeSans9pt7b);
                   ^
tftHelpers.h:830:20: error: 'FreeSans12pt7b' was not declared in this scope
   tft.setFreeFont(&FreeSans12pt7b);
                    ^
C:\Users\user\AppData\Local\Temp\arduino_build_369445\sketch\tftHelpers.h: In function 'void drawDummyPlusMinusButtons()':
tftHelpers.h:844:19: error: 'FreeSansBold12pt7b' was not declared in this scope
  tft.setFreeFont(&FreeSansBold12pt7b);
                   ^
In file included from C:\Users\user\Documents\Arduino\ESP32-WROVER_Web_Radio\ESP32-WROVER_Web_Radio.ino:6:0:
C:\Users\user\AppData\Local\Temp\arduino_build_369445\sketch\stationSelectHelper.h: In function 'void listStationsOnScreen(int)':
stationSelectHelper.h:147:20: error: 'FreeSans9pt7b' was not declared in this scope
   tft.setFreeFont(&FreeSans9pt7b);
                    ^
C:\Users\user\AppData\Local\Temp\arduino_build_369445\sketch\stationSelectHelper.h: In function 'void drawNextStationBtn(bool)':
stationSelectHelper.h:180:19: error: 'FreeSans9pt7b' was not declared in this scope
  tft.setFreeFont(&FreeSans9pt7b);
                   ^
C:\Users\user\AppData\Local\Temp\arduino_build_369445\sketch\stationSelectHelper.h: In function 'void drawPrevStationBtn(bool)':
stationSelectHelper.h:196:19: error: 'FreeSans9pt7b' was not declared in this scope
  tft.setFreeFont(&FreeSans9pt7b);
                   ^
C:\Users\user\AppData\Local\Temp\arduino_build_369445\sketch\stationSelectHelper.h: In function 'void drawStationCancelButton()':
stationSelectHelper.h:212:19: error: 'FreeSansBold9pt7b' was not declared in this scope
  tft.setFreeFont(&FreeSansBold9pt7b);
                   ^
C:\Users\user\AppData\Local\Temp\arduino_build_369445\sketch\stationSelectHelper.h: In function 'void stationNextPrevButtonPressed()':
stationSelectHelper.h:233:22: error: 'class TFT_eSPI' has no member named 'getTouch'
   bool pressed = tft.getTouch(&x, &y, 30);
                      ^
C:\Users\user\AppData\Local\Temp\arduino_build_369445\sketch\stationSelectHelper.h: In function 'int getStationListPress()':
stationSelectHelper.h:314:22: error: 'class TFT_eSPI' has no member named 'getTouch'
   bool pressed = tft.getTouch(&x, &y, 30);
                      ^
C:\Users\user\Documents\Arduino\ESP32-WROVER_Web_Radio\ESP32-WROVER_Web_Radio.ino: In function 'void setup()':
ESP32-WROVER_Web_Radio:80:24: error: could not convert 'player.VS1053::begin()' from 'void' to 'bool'
  } while (!player.begin() && mp3StartCount > 0);
                        ^
ESP32-WROVER_Web_Radio:80:25: error: in argument to unary !
  } while (!player.begin() && mp3StartCount > 0);
                         ^
ESP32-WROVER_Web_Radio:115:25: error: invalid conversion from 'uint16_t {aka short unsigned int}' to 'uint8_t* {aka unsigned char*}' [-fpermissive]
  player.setTone(SCI_BASS);
                         ^
In file included from C:\Users\user\AppData\Local\Temp\arduino_build_369445\sketch\main.h:29:0,
                 from C:\Users\user\Documents\Arduino\ESP32-WROVER_Web_Radio\ESP32-WROVER_Web_Radio.ino:2:
C:\Users\user\Documents\Arduino\libraries\ESP_VS1053_Library-master\src/VS1053.h:136:10: note:   initializing argument 1 of 'void VS1053::setTone(uint8_t*)'
     void setTone(uint8_t *rtone);
          ^
ESP32-WROVER_Web_Radio:208:16: error: 'TFT_BL' was not declared in this scope
  ledcAttachPin(TFT_BL, 0);

RalphBacon, 2021-02-24:
The problem lies with the TFT_eSPI-2.2.23 library - I can only assume you are using a different version. Use the one I included in the libraries folder (205-Internet-Radio/Arduino IDE Version/ESP32-WROVER_Web_Radio/libraries/) in the GitHub and ensure you do not have any other libraries that might be picked up by the Arduino IDE instead of this one.

Closed 2021-07-21.

Thread 13 (2021-06-10):

Very choppy audio (without PSRAM) and some more questions

bepaald, 2021-06-10:
Hi! First of all thank you very much for this project and the corresponding youtube videos. I had a TFT display lying around, and always a couple of esp32's so I ordered the vs1053 since this seemed like it would be fun to make.

I think I have a working radio on a breadboard now, though I had a lot of trouble with the wiring. I should note I am not a hardware-guy, and it is all a bit new to me. But after going through the source code, the board schematics and some youtube comments, and realizing 3 of the four SPI connections can be shared (and that the touch devices' mosi and miso are labelled with other names) I think I have the wiring correct. The only one I'm not sure about is the vs1053's 'XRST' pin. I have it hooked up to the esp32's 'EN' pin (which I believe is the reset), but I read in a youtube comment that it should not be connected to the esp32 at all? I think I tested it unconnected, but then I get no audio. Could you help me with that?

Now, I only had WROOM modules around, so I was expecting a bit of a glitch in the audio once in a while, however, it is much worse. I think there is about as much glitching as there is playing even though I already increased the ring buffer to 50000 bytes. I also sometimes hear the audio 'catch up' (playing sped up) after having been cut out for a bit. I made a little video of it here: [https://sendvid.com/nloezqcf](https://sendvid.com/nloezqcf). Is this expected? Is it just a matter of swapping in the WROVER (it is already underway) and enabling the PSRAM, or do you suspect something else is wrong. Maybe my wiring is bad, or am I missing some passive components? At the moment the project is just the esp32, tft, vs1053, a breadboard and dupont wires.

Lastly, I notice that the `player.begin()` loop almost always (but strangely enough not always) runs the full countdown without ever breaking early because `player.begin()` returns true. I notice no change in performance between the 'failed' initializing and the rare few times were true is returned and the countdown doesn't reach zero. Should `player.begin()` usually return true quickly? I notice, in the current upstream version, `VS1053::begin()` is a void function and the example code provided does no checking for success. Also, the next loop again has the structure for a countdown, but `mp3StartCount` is never actually decremented, not sure but that looks unintended.

Thanks again, sorry for the long post.

RalphBacon, 2021-06-12:
Hi bepaald!

Sorry to hear you have issues with choppy sound.

Firstly, even when not using a circular buffer of much substance (eg 10K on a non-WROVER device) the sound should be fine if your internet stream Is stable.

If you are using my code, without any (substantial) changes then it should play just fine (as mine did before I went the WROVER route). Of course, there will be interruptions as the internet stream is never perfect but it should not be choppy as per your example video.

Occasionally, I have had a similar experience if I am outputting too much on the serial port (for debugging/monitoring) as it takes too long and interrupts the process of delivering the 32 byte chunks to the VS1053. If you have lots of serial output (it MUST be at 115200 anyway, anything else is too slow) try reducing the debugging level to WARNING  just to see if that helps.

If the above does not help then I do suspect a wiring issue, but let me know how it goes before we try and investigate further.

One last point: you seem to using an older version (1v29) Arduino ported code; I’ve made some changes to the PlatformIO version 1v32 but the fundamental music streaming should always work.

Best Regards

Ralph S Bacon

 <https://www.youtube.com/ralphbacon> https://www.youtube.com/ralphbacon

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

rjshiffer, 2021-06-12:
Hi Ralph,

In your reply to @bepaald you mentioned that he is using an older version 1v29.  I'm also using that version.  Now that I'm on Platform IO, is the 1v32 Platform IO version available somewhere?  I can't seem to locate it.

Thanks,
Richard (a daily radio listener!)

RalphBacon, 2021-06-12:
A newer version (with a separate task for the music streaming, but it’s not 1v32 as far as I can recall, it was months ago that I did this) for PlatformIO can be found here:  <https://github.com/RalphBacon/208-Arduino-IDE-Web-Radio-using-a-Task> https://github.com/RalphBacon/208-Arduino-IDE-Web-Radio-using-a-Task

If you can install that project into PlatformIO then I can put up a zip of the absolute latest version and it should be simple to update. Yes, I know all this should be done via GitHub but it all takes time.

Remember to update the “data” folder with your Wifisecrets.txt and do calibrate the screen (a bit of a pain) to get the string of numbers out. If you don’t do this you might find all the “buttons” don’t quite seem to be where they should be when you “press” them.

Let me know how it goes.

Best Regards

Ralph S Bacon

 <https://www.youtube.com/ralphbacon> https://www.youtube.com/ralphbacon

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

rjshiffer, 2021-06-12:
Hi Ralph,

The version  <https://github.com/RalphBacon/208-Arduino-IDE-Web-Radio-using-a-Task> is an older version than <https://github.com/RalphBacon/205-Internet-Radio> (version 1v29).  Version1v29 does have a separate task for streaming music.

Let me clarify my setup:  I took  the Arduino IDE version 205-Internet-Radio (1v29) and converted it to PlatformIO. (I used  "208-Arduino-IDE-Web-Radio-using-a-Task" as a PlatformIO model).  So I already have an operating PlatformIO version of the radio.   If you could put up a zip file with the latest version (if not private--1v32 shows in your videos), I could simply replace my PlatformIO version, with the noted exceptions for Wifisecrets.txt and calibration, of course.

Regards,
Richard

RalphBacon, 2021-06-13:
Hi Richard

Well you certainly made yourself a lot of work by re-converting the Arduino code back to PlatformIO code!

Yes, I can zip up my entire project (there will be some external libraries still) and put it in Dropbox, hopefully later today.

Do you get choppy audio too or was that just bepaald?

Best Regards

Ralph S Bacon

 <https://www.youtube.com/ralphbacon> https://www.youtube.com/ralphbacon

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

bepaald, 2021-06-13:
Hi Ralph, thanks for your quick reply. After some fiddling around with the wires yesterday and then applying just the right pressure under just the right angle to some of the connections, I actually had perfect audio! So I definitely have some dodgy dupont wires in my collection. I should be able to work around them (or replace them).

Still, after reading the exchange with @rjshiffer, I too would be very interested in the latest code. No need to port it to arduino on my account if you haven't done so already, I think I can manage. It would be _great_ if you would upload the code to one single git repo sometime in the future, which is then updated from time to time. I also initially thought the code at 208 was newer, but looking at the dates that doesn't seem to be the case. But I do realize it'll be a bit of a time investment to set that up.

Thanks again! Regards,
Selwin

RalphBacon, 2021-07-21:
New version v1.35 for the Arduino IDE now available.

Closed 2021-07-21.

Thread 14 (2021-06-16):

Touch screen problems

pafa17, 2021-06-16:
Hello Ralph
I have just built your excellent radio and most items are working well except for the touch screen. It is the same screen that you used only slightly smaller at 2.4".
The display is perfect but the touch positions don't match. The +,-, Bulb icons can be changed by touching a corresponding position at the top of the screen.
I tried rotating the screen which worked for the background but the button icons stayed in their original positions.
I reverted to original then I ran the touch screen calibration and got " uint16_t calData[5] = [374, 3538, 318, 3518, 3]".
I then substituted this in the folder "TouchCalData1.txt" but still no change.
I am now at a loss as to what to try next. Maybe you could advise

RalphBacon, 2021-06-16:
Hello pafa17

I’m glad you’re getting good (audio) results from this project. Now to your problem.

When you do the screen calibration it must be in the same rotational state as the ESP32 Web Radio sketch.

As the ESP32 Web Radio sketch executes (around line 151 in tftHelpers.h)

    // Rotation as required, the touch calibration MUST match this

    // 0 & 2 Portrait. 1 & 3 landscape

    tft.setRotation(1);

You must also include that line in the screen calibration sketch. If “1” doesn’t work (it’s mirrored/flipped) try “3”. A bit suck it and see. Not very scientific, I know.

It’s been so long since I got this bit working (I too had some issues but I can’t remember if they were the same as yours) that’s the best I can suggest.

When the calibration sketch writes "Touch screen to test!" I’m thinking that should be in the orientation that you are expecting to run the screen. I’m trying to remember whether the display orientation is any different to the touch calibration but I’m pretty sure that as long as the screen was in the correct orientation at the time of calibrating it, it should work fine.

You can always test this theory by rotating the screen using a number from 1 - 4 (0 & 2 Portrait, 1 & 3 landscape) and see where buttons (touch, not displayed) end up!

Let me know how you get on.

Best Regards

Ralph S Bacon

 <https://www.youtube.com/ralphbacon> https://www.youtube.com/ralphbacon

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

pafa17, 2021-06-16:
Hello Ralph,

Thanks for speedy reply.
I have tried the 4 orientations in touch screen calibration with tfthelper line 141 set to (1) and no change whatsoever.

Then I tried changing line 141 to (3) the only thing that flipped was the "ESP32 WEB RADIO" logo ,the v1.29,tune,bulb,+,-,% icons all stayed in their original position and the touch positions never changed position either.

I do not understand
 y Ò
  Ò
  ”?@?
code in the  TouchCalData1.txt file.
 I tried to substitute " uint16_t calData[5] = [374, 3538, 318, 3518, 3]". and
" uint16_t calData[5] = [448, 3432, 343, 3490, 5]" opposite orientation
which I got from touch screen calibrate but it made no difference.
Basically the touch positions stay in their original positions.
Maybe it's my display although I have a second one doing exactly the same thing.

Regards
pafa17

RalphBacon, 2021-06-17:
You may have missed the other orientation commands; see the screen shot where I have highlighted the lines:

The first and last of these commands should be the same, the middle one (rotation 0) is just for the v1.32 so it fits into the banner.

Check you’ve done the first and last rotation setting.

If you’re still having problems, you will need to load another sketch, eg the included examples in lib > TFT_eSPI-2.23 > examples. The Test_Touch_Controller.ino might give you an insight as to how the screen rotation works. I seem to remember I did this before I could understand how it all worked.

FYI the default orientation (rotation 0) of the screen is portrait, which confused me, I was expecting landscape as default.

Best Regards

Ralph S Bacon

 <https://www.youtube.com/ralphbacon> https://www.youtube.com/ralphbacon

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

pafa17, 2021-06-17:
Hello Ralph,
Thankyou for taking the time to help a 72 year old hardware man attempting his first arduino project with very little experience of software.
First of all I can't see a screengrab so I followed your instruction and  changed the rotation  on line
141 tft.setRotation(3); and
166 version no. also to setRotation(3)
I do not see any more rotation instructions
So partial success now I seem to have a mirror image in that the + and minus icons are reversed as are the the bulb and speaker icons.
I could try to figure out the coordinates of these and see if I could swap them.
Thanks again for your help

Best Regards
pafa17

RalphBacon, 2021-06-17:
As you have an earlier version of the code the line numbers here might well be different. Here's the screenshot that you could not see.

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

I'd like to know what screen exactly you have. You should not have to change anything regarding the positioning of the buttons - doing so indicates that the image is mirrored/flipped so we need to resolve that rather than change code (otherwise on my next code update you will lose your updates).

Can you post a photo of your screen, front and back plus anything you know about it please?

pafa17, 2021-06-17:
Hello Ralph,

Those are the very lines that I changed.
I now appreciate the amount of work you put into this project with the slight messing about that I am trying.
The display seems to have the correct touch ic  XPT2046
The label on the display says
2.4" SPI TFT Module
Driver ILI9341
Dots 240x320 touch yes
SKU MSP2402
Thanking You
pafa17

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

RalphBacon, 2021-06-20:
I've checked my TFT lib selections and your screen is identical to mine (except for the actual size). So why you are experiencing a flipped touch screen when using a non-modified version of my code baffles me.

Rather than trying to get it to work by changing the code, I suggest loading up the sketch:
I:\Documents\PlatformIO\Projects\ESP32 Better Internet Radio\lib\TFT_eSPI-2.2.23\examples\Test and diagnostics\Test_Touch_Controller\Test_Touch_Controller.ino

And then check that the coordinates are as expected.

Next try sketch:
I:\Documents\PlatformIO\Projects\ESP32 Better Internet Radio\lib\TFT_eSPI-2.2.23\examples\320 x 240\Keypad_240x320\Keypad_240x320.ino
And see whether the calculator pad behaves correctly.

I remember (vaguely) doing this to get it all working on my setup.

If both these tests work then it is not your screen but something in my code that is either done or hasn't been done but is required for your particular screen.

Have a go with the first two sketches and see what happens before we investigate further.

pafa17, 2021-06-20:
Thanks for the reply Ralph but excuse my ignorance, where do I find both of those files. I am using the arduino ide

RalphBacon, 2021-06-20:
Oh, OK, they are in the library for the screen, in the folder, under examples. Slightly different path but you should find them there.

pafa17, 2021-06-20:
Found them; the test touch controller seems to run forever and unfortunately I cannot interpret it.
The keypad240x320.ino tells me SPIFFS was not declared in this scope.
Sorry for all the hastle but I am a complete noob. I think I might have included a part copy of the test touch controller
[test touch controller.txt](https://github.com/RalphBacon/205-Internet-Radio/files/6682664/test.touch.controller.txt)

pafa17, 2021-06-23:
Hello Ralph
Sorry to be such a pain,I know that you can't lead people by the hand through your projects but finally after watching your video about littlefs & spiffs I finally got the  \TFT_eSPI-2.2.23\examples\320 x 240\Keypad_240x320\Keypad_240x320.ino to work.
I now have the display of the keyboard and when I touch the numbers they all display correctly in the display window so the touch and display sections must be working properly, Any advice where to go from here ?
If you are too busy I will understand and live with the buttons and touch being in reverse

RalphBacon, 2021-06-24:
Hi Ken (I just made that bit up as you are _still_ anonymous!)

Now that you have a working portrait screen, try adding in a line to the sketch to rotate the display using
**tft.setRotation(1);**
as landscape for the parameter - that line is in setup().

Some of the keypad keys may disappear off-screen but we’re not worried about that right now.

Do the keys that you CAN see still correspond to the numbers being displayed? In other words, is the touch orientation the correct one for the screen orientation?

Note: You may have to repeat the calibration part of that sketch again first (i.e. change line **#define REPEAT_CAL false** to **true**).

pafa17, 2021-06-24:
AH! Sorry about that Ralph,I didn't realise. It's Pat from a wet and cool Dublin.
I did as you suggested and the display rotated and the buttons I could see 1-6 when touched displayed perfectly in the display window.
Just to reiterate again as to my situation with the radio display,it seems that only the y axis is reversed ie
V1.29 brings up the station pages.
When the + button is pushed the - button lights up and the volume decreases and vice versa
The bulb icon switches on the mute button
On the station pages the < & > are reversed but the station buttons operate correctly.
Thanks again for your assistance
Pat

RalphBacon, 2021-06-24:
Hi Pat! Thanks for the clarification. Quick question: are you using the Arduino IDE version or PlatformIO?

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

--
Sent from my Android device with K-9 Mail. Please excuse my brevity.

pafa17, 2021-06-24:
Hello Ralph
I'm using the Arduino ide I think it will be a while before I progress to platformio as I am struggling to understand the code in the sketch

Regards

Pat

RalphBacon, 2021-07-21:
New version v1.35 of the Arduino IDE code available.

pafa17, 2021-07-26:
Hi Ralph,

I have used the new version 1.35 and no change in my display issue.
Have you changed anything which may have helped me, if not I will live with
it or possibly buy a third display and see will it work.

Regards

Pat

On Wed, Jul 21, 2021 at 12:12 PM Ralph Bacon ***@***.***>
wrote:

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

RalphBacon, 2021-07-28:
Sorry, I have not found any issues with the screen-related code that would affect you.

That said, you could try loading the calibration sketch and extracting the values to be loaded each time (placed into a file in the data folder).

Alternatively, if you buy the _exact same screen_ as me then you will no issues, as everyone else who has done that testifies. Unfortunately, the price has increased a bit to $10.99 not least because Banggood include VAT now in the price (a 20% increase for UK purchasers and whatever the VAT rate is where you live).
Link: https://www.banggood.com/custlink/3GvdgmuHt3

pafa17, 2021-07-28:
Thanks for the reply Ralph.I just did what you said and purchased the
display from Banggood yesterday. I notice the pcb tracks to the xpt2046 is
different on mine compared to your one
Just as a matter of interest how did you get the data in the file
TouchCaldata 1.txt.
Again thanks for all your help the radio is working well otherwise.

Regards

Pat

On Wed, Jul 28, 2021 at 6:12 PM Ralph Bacon ***@***.***>
wrote:

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

RalphBacon, 2021-07-30:
@pafa17
I’m sure the new screen will perform flawlessly, Pat! Drat the VAT!

I got the data into the text file simply by copying what was on screen (sent via the Serial monitor output) and typing it into a text file! I was too lazy to get the program to write to a file, then me having to extract the file to prevent it being overwritten every time. You should only need to calibrate it once.

Let me know how you get on.

rjshiffer, 2021-08-04:
@pafa17
Hi Pat,

I see that your question about the contents of the "TouchCalData1.txt" file
was not answered.  I too had trouble understanding and creating
the "TouchCalData1.txt" file.   I had to create mine manually. I don't
know a shorter way. Maybe this will help:

Short Answer: The TouchCalData1.txt file contains the 5 2-byte integer
values shown in the serial output of the touch screen calibrate sketch
**EXACTLY** in the format stored in the ESP32 memory (i.e, uint16_t).

Long Answer:  Let's use your data from your 1st post:

>uint16_t calData[5] = [374, 3538, 318, 3518, 3]

1. These are in decimal, so first convert to hex:

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

2. The ESP32 is what's called a "Little endian machine". That is, it stores
data little-end first. When looking at multiple bytes, the first byte is
smallest. For example, 0x'0176' is actually stored in memory as 0x'7601'.
Don't ask me why.

3. Flip the bytes to match EXACTLY the ESP32 format:

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

4. So the TouchCalDate1.txt file should be (in binary):

>7601d20d3e01be0d0300

   @RalphBacon's file is:

>7901d20d0401d20d0700..........

   @RalphBacon's file has more bytes but they are not used.

5.  How do you enter this binary data in the file?  I use the VIM editor
that permits binary editing. If it's easier, I created a TouchCalData1.txt
file using your data and is attached.  Save the original file in
the data folder, replace it with the attached, upload the LITTLEFS file system
using the Arduino IDE.
[TouchCalData1.txt](https://github.com/RalphBacon/205-Internet-Radio/files/6934469/TouchCalData1.txt)

6. Monitor the serial output from ESP32 Radio to verify your touch calibrate numbers are used.

7. Good Luck.

P.S. The extra 2 bytes in the file are CR-LF and are ignored.

pafa17, 2021-08-05:
Hello rjshiffer
Thank you very much for taking the time to explain the data in CalTouchData1.txt.
That is very interesting and quite convoluted.
I did as you suggested and unfortunately the display now works diagonally ie touching bottom left affects top right.
Thinking about it, it occured to me that when I did the original touch cal sketch I didn't set the rotation to 3.
I have rerun the touch cal again and got these values
( 436, 3448, 235, 3458, 5 ) I converted these to hex and got
0x01B4. 0X0D78, 0X0EB, 0X0DB2, 0X0005  which I then changed them to
0XB41. 0X780D, 0XBE0, 0XB20D, 0X0500
Which gives me
B41780DBE0B20D00500
I cannot figure how to get this to the data used in the CalTouchData1.txt file
Any help would be much appreciated.

Regards

Pat

rjshiffer, 2021-08-05:
@pafa17

Hi Pat,

You have a few mistakes.  3458 is 0x'0d82' and you're missing some zeros in the final string of digits.

I made another file:

>b401 780d eb00 820d 0500  <-- digits

>b401780deb00820d0500      <--- file contents

[TouchCalData1.txt](https://github.com/RalphBacon/205-Internet-Radio/files/6940210/TouchCalData1.txt)

I didn't give rotation any thought when I generated my numbers.  I don't know how that will effect the display.  I think we're in "trial and error" mode.

Richard

RalphBacon, 2021-08-05:
Guys, remember you must set the rotation correctly (for the orientation you intend to use the screen) when running the calibration sketch, otherwise the universe will (probably) implode.

As the ESP32 Web Radio is setting the screen to landscape (default is portrait) set the rotation to:
`tft.setRotation(1);`
in your calibration sketch to get the right numbers.

Good luck and if the universe _does_ implode I'll know why.

pafa17, 2021-08-06:
Hi Richard,
Thanks again for your help and sorry for my mistakes.
I ran the new data that you provided and looking at the serial out,the data shows cal data
01B4, 0D78, 20EB, 0D82, 2005.
Does it look as if the 3rd data is wrong (20EB)
No Touch working at the moment

Pat

PVsolar, 2021-08-06:
Hello Richard, Ralph,
I am following your discussion with Pat with more than normal interest; I have simmilar problems (sorry, challenge it should be called). In V1.29 all positioning was ok (but a few other issues)
In V1.35 everything else is solved but the buttons at the lower line (SET, bulb, +, - , and speaker) can only be touched in the area bolow the button. It looks the sensitive area has shifted down exactly the button size. The Station button is right at the correct location. At the station pages the touch position of the stations is ok but also the lower line buttons have to be touched below the button. So I am not sure there is a calibration issue because it not linear from top correct to bottom shifted but 80% top is ok and 20% bottom is shifted. I have modified the position of the bulb and speaker touch area but for the other buttons I have not found the location of the position setting yet. @Ralph, can you give me an indication? But as said before, I do not like to modify in the program as newer releases have to be modified as well. I rather understand the touchcall procedure.
 I have understand following:
Result from the calibration.  uint16_t calData[5] = { 342, 3477, 640, 3110, 7 };
my calculations:
Hex: 		0176, 0D95, 0280, 0C26, 0007
LSBfirst:	        7601, 950D, 8002, 260C, 0700
To VIM editor:	7601950D8002260C0700
But what should the VIM editor do? When I open the touchcall data txt file with a notepad I see some symbols and weird signs but unreadable and less characters as in the list above. It looks simmilar to the result as opening a mp3 file in the notepad. So to which program or code should it be converted?
I am very happy with the result so far and could live with this small deviation but I am also curious and want to learn.
Kind Regards, Hans

pafa17, 2021-08-07:
Hi Richard,

Again apologies,when I had first built the radio I had changed the rotation in tfthelpers file to rotate the display and the data that you worked on originally was pre rotation.
So after thinking about it for a while I realised this and when I reverted the rotation to the original settings the display now functions perfectly,
Thank you for your concise explanation and new data. I would never have been able to fix it myself.
It is good to know that there are people out there that will help novices like myself

Best Regards

Pat

rjshiffer, 2021-08-09:
@pafa17

Hi Pat,

Good news on getting your display working.  It looks like my bad eyes
and bi-focals made errors too on that 2nd file.  Good that the 1st file
worked. Glad I could be of help.

@PVsolar

Hi Hans,

Here is an updated TouchCalData1.txt file for you.

For:

> uint16_t calData[5] = { 342, 3477, 640, 3110, 7 };

I get:

>Hex: 0156, 0d95, 0280, 0c26, 0007
>LSBfirst: 5601, 950d, 8002, 260c, 0700
>File: 5601950d8002260c0700

Notice that for 342 I get 0x'0156'

Here's the file.

[TouchCalData1.txt](https://github.com/RalphBacon/205-Internet-Radio/files/6951987/TouchCalData1.txt)

Save the original file in the data folder, replace it with the attached,
upload the LITTLEFS file system using the Arduino IDE. Monitor the serial
output from ESP32 Radio to verify your touch calibrate numbers are used.

Although I use the VIM editor, you may find that the Notepad++ editor
with the HEX-Editor plugin installed an easier way to create these
binary files.

PVsolar, 2021-08-10:
Hello Richard,
Thank you for the translation (and correction of my typo) of the calibration data.
Unfortunatly it did not work. As you can see in the monitoring data the program could not find the caldata. Using the old file did work as intended.
I installed the HEX converter in notepad++ and played with the data and formats. I still does not understand why in the standard notepad all those weird characters are showed, but notepad++ seems to understand it and converts it back to readable numbers. I noticed two things: in the converted file the last figure 0007 was converted into 2007. That file contains two lines while the original file has three. Maybe not of interest but it shows I do not understand what I am doing. The result of using the new file is that the touch point of the lower line buttons lies on the lower edge of the title block and the station button cannot be used. I did do some calibration repetitions and the outcome gives different but close to each other numbers. Can you explain step by step what I have to do to the conversion via notepad++?

Kind Regards, Hans

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
[Calibration history.txt](https://github.com/RalphBacon/205-Internet-Radio/files/6962055/Calibration.history.txt)

PVsolar, 2021-08-11:
Hello Richard,
It works perfectly! Thank you for spending so much time for us. I don't know what is different now compared to yesterday. The only thing I can think of is that I got several times error messages from littlefs when uploading Data. Sometimes the third or forth time it worked without changing anything. (monitor was off all the times) Today the first attempt was right and all buttons are touchable perfectly in the centre. The data is identical to the CalData except for the 0007 which is now 2007 but it seems not of influence.
Kind Regards, Hans
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

rjshiffer, 2021-08-12:
Hello Hans,

Good news that the button selection is working fine.  Although I'm curious about the last value showing '2007' rather than '0007'.  That means the last part of the file contains x'0720'.  How can that be?

I ran the file I sent you and I get:
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

Can you verify that the last bytes in the TouchCalData1.txt file you are using ends in x'0700'?  I don't know the implications if some future update to the code will cause a problem with the wrong value.

Two solutions:

1.  If you are adventuresome use notepad++ and the HEXeditor to change  x'0720' to x'0700' in the file and upload the data/ folder.

or

2. Simply re-download my file from a previous message to ensure you are using an un-modified file, verify x'0700' at the end (via notepad++, etc)  and then upload the data/ folder.

Richard

PVsolar, 2021-08-12:
Hello Richard,
I noticed the change from 0007 into 2007 already in your first converted file. As there are many different apearances fro the same data (which I do not understand all) I made an overview of all my actions.
First, the difference in line number from tftHelpers (h:90 in yours and h:92 in mine) comes from two modifications I made for the location of the bulb and speaker to try to shift the touchpoint to the icon. I left the original location but commented out so two additional lines. I deleted my modifications and uncommented the original lines because the caldata works fine now. In the monitor output the lines are now h:90 also. (but still 2007)
I made a file "Calibration history.txt" but to show what I see in the various programs and settings I made a screenshot called caldat_history12-8.PNG. In this file you see the different actions I took from calData[5] output until the translation I got from you (first time) but showed in the "simple" notepad. (Kladblok means Notepad)
When I open the TouchCalData1.txt in Notepad++ I get the lines as shown in the lowest line in screenshot caldata12-8. (VSOH.....etc.) I copy/pste these lines in a file called TouchCalData11.txt (just to have another name) and activated the HEX in plugins. Only the 0156 is recognizable but the rest... I don't know. BUT, when I in the original TouchCalData1 (lowest line) switch to Hex via plugins I get the output on the top. Exactly as in the monitor output. At the end of the HEX files some characters are showing up under Dump but I think that is not of interest.
I hope you can make something up from what happens here. Espescially the difference between copy/past> HEX and direct showing in HEX I do not understand at all.

Kind Regards, Hans

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

Thread 15 (2021-07-06):

Simple Schematic Question

geoffw123, 2021-07-06:
I would like to have a crack at building this web radio, but after having downloaded the latest repo I cant find the schematic diagram to work to. Have I missed it, or is it missing ? A link to it here would be great please. Thanks for your help (Ralph or anyone that has a copy of the schematic)

RalphBacon, 2021-07-06:
Just before I dig out that info, Geoff, can you tell me please:

1) Are you in the UK?
2) Can you use PlatformIO as your IDE of choice or are you an Arduino IDE person?

Whilst you answer this I'll dig out that information :)

geoffw123, 2021-07-06:
Hiya Ralph
Thanks for the speedy reply, a PlatformIO Brummie here :)

If I can ask another simple question please, are you selling any excess supplies of  your WebRadio PCB, or maybe your repo provides your  Gerber files for sending to JLPCB?
Thanks

RalphBacon, 2021-07-06:
Hence my reason for asking (although commiserations for having to live in Birmingham, but I guess someone has to 🤣)

Ok, enough foolishness (not to mention rudeness 😁)

Yes, I have a spare PCB. In fact, two, one for the motherboard and one for the screen.

If you are going to use these PCBs there are some other, specific, parts you will need.

- 1 x TFT **Touch** Screen link: https://www.banggood.com/custlink/DmDyHMw4SR
- 1x 10-way (2 rows of 5 pins) IDC female cable (the same as used in programming the Arduino with an ISP)
  Like this one: https://www.hobbytronics.co.uk/idc-ribbon-cable-12-10?keyword=IDC
- 1 x 20-way (2 rows of 10 pins) IDC female cable to connect the screen to the motherboard
  Like this one: https://www.ebay.co.uk/itm/220mm-IDC20-IDC-Female-Female-Flat-Ribbon-Cable-20-Pin-Gray/272723050970
  Or this one: https://www.ebay.co.uk/itm/114032991586?ViewItem=&item=114032991586
- 1 x 470μF capacitor (at least 10v but don’t go mad as they get bigger the higher the voltage) or similar (whatever fits nicely on the board, you can go as low as 100μF)
- 1 x 10kΩ resistor
- 1 x two-pin pushbutton (optional just for testing but mandatory if you don’t have the screen).
- 1 x 100nF SMD capacitor (optional, a case of belt-and-braces)
- 2.5mm (0.1”) pin headers just like on the Arduino, but for the IDC cables to plug into. Total pins approx. 80 pins, very cheap to buy!
- 2 x 15-way female sockets for the ESP32 to plug into: https://amzn.to/3axmvsf

You can also make your own IDC cables of course, something I did too. Just be very careful of the cable orientation or the whole thing will be reversed which will only end badly when you plug it in.

None of the above is particularly pricey, although the Chinese sites now seem to add VAT on as per the EU directive (hang on, didn't we Brexit a while back?). Since I did this project they increased the price of the screen to $11.99 (was $6.99) such is my influence! At least shipping is free to the UK.

Anyway, if you think you can source those components, I'll be more than happy to send you the PCBs FOC, and as you're a PlatformIO developer it makes things _very_ much simpler with the up-to-date code (I'll send the entire project).

Let me know your thoughts.

RalphBacon, 2021-07-06:
Most importantly are the schematics, which you can find here:
https://github.com/RalphBacon/208-Arduino-IDE-Web-Radio-using-a-Task/tree/main/Schematics%20(subject%20to%20change)
Note that this GitHub, although a later video than #205, doesn't contain the latest code (but as you're PlatformIO you get a newer version anyway).

I didn't mention items such as the VS1053 decoder or the ESP32 WROOM TTGO v1.7.1 as I take these requirements as read but if you need to know where I got them from (The ESP32 from a UK supplier) let me know.

The components really need to be an exact replica of what I have if the PCBs are going to work.

geoffw123, 2021-07-06:
Hi Ralph

Many thanks for the detailed reply. I have already got most of the parts for this, I am going to build it on a breadboard to begin with and see what problems I hit. Just a matter of finding the free time and the brain power to do it !  I will give you a shout in the future if I have success and would like to put it on a pcb. Thanks for the offer of your spare board.

RalphBacon, 2021-07-07:
Good luck with your build; it will be much more difficult on the breadboard than a PCB, of course; as you saw in my video there was a huge number of DuPont wires I had to use! The PCB construction is pretty much like Lego, plug and play. No, that's _play_ not _pray_. 😁

When you need the newest code just let me know; I may have organised myself enough to get the PlatformIO repository up-to-date by then :)

If you get stuck let me know how far you've got, the stumbling block and I'll try and help.

RalphBacon, 2021-07-21:
New version v1.35 of the Arduino IDE code now available.

Closed 2021-07-21.

Thread 16 (2021-07-15):

Some stations give no sound

PVsolar, 2021-07-15:
Hello Ralph,

Thank you for this great project. I already build an ESP32 radio but without touch screen and without buffer. I learned a lot from that project (originally I am a hardware guy) but your design is next level. It gave me a lot of learning moments the last weeks and now the radio is working and I am very happy. To learn even more I will modify things, like more than one AP to be selected automatically or on screen and truncating the music title because it now sometimes is printed over the buttons.
But one thing is very important and I don't know what to do: Some radio stations can be contacted, deliver meta data and I can see the bytes are streaming in. But no sound is heard and the buffer remains empty. Selecting the same station on my "old" radio produces music so the station is sending. The difference with working stations is that the logging of the stream is continuing endless and in portions of 2 to max 28 b, while the working stations after some time produce 32b continiously and stop logging because the buffer is full. Can you give me some direction how to get these stations working? The one I like most for the moment is: 208.92.53.98,3690,"/SRGSTR25AAC_SC","Classic FM Chill Out",1
Thank you in advance, Hans.

RalphBacon, 2021-07-15:
@PVsolar
Hi Hans!
Last things first. I added that station to my list and it plays normally. With metadata.
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

However, you did not tell me whether you are using the very, very, very old Arduino code or the slightly less old PlatformIO project?

The code has moved on a bit (now V1.35) but not yet uploaded to GitHub. It now deals with long song titles/artists and reduces the font title until it fits. for example. Plus a few dozen other (mostly behind-the-scenes) fixes. Like working with chunked data on the BBC and HTTP/1v1.

If you are using Arduino this is a problem as I have promised others to upload newer code but this takes time (to convert from PlatformIO to Arduino IDE).

Let me know what IDE you use first please and we will take it from there.

PVsolar, 2021-07-16:
Hello Ralph,
Thank you for the quick response. I am glad to see my issue has been solved already. I also see a new button in the lower left corner so I have to update. I am using version 1.29 from your 205 video on Arduino and Arduino IDE. As said, from education I am a hardware guy and could up till my retirement leave the software to the specialists in my department. I started two years ago learning the Arduino IDE and have found my way more or less but still learning every day. Because of your enthousiasme I want to try to dive in platformIO but I am afraid to be confused and mix both platforms. If it's necessary to follow your updates is a motivator. Originally I used the same ESP32 version as in your earlier videos and there I had the same problem where ti connect the reset. Connecting to enable (pin 1) did not work. So now I have the same T8 version as in your 205 video.
Hans
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

RalphBacon, 2021-07-16:
I think it best that I update the Arduino version, not just for you but for many others too. PlatformIO is not something you can pick up in an hour (I'm still learning after several months - yes, I'm obviously a slow learner).

I will endeavour to update the code in video #205 to V1.35 very soon; if you do not hear anything in one week please nudge me again.

BTW that "SET" button in the bottom left of my screenshot is being developed still, to allow adjustments to the bass, treble and anything else I can think of. But it is not finished yet so don't get too excited about that!

I like your slimline case for the radio - did you 3D print that yourself?

PVsolar, 2021-07-16:
Hello Ralph,

You are fast!
So no need to dive into platformIO yet. I’ll wait for your update to V1.35. I tried to subscribe your channel but it seems I have to have a google account first. Is that true?
The housing is from Otto, Germany but as far as I could find not in production anymore. There are comparable housings from e.g. Hammond. The “secret” in this compact setup is the use of special Ampmodu connectors for the display. The connector body is on the component side but the contact entrance on the solder side. Also I soldered the pins on the ESP at the component side so the components are “hanging” between the headers. The location of the ESP32 and the VS1053 are such that the usb and audio socket are just protruding the side walls. A power inlet fits just beside the ESP and some C’s found a place inbetween. The interconnection board is so simple that I could make it with discrete wires but as always, I made a layout first. Mechanical work at the housing took most of the time. If you are interested I can make a 3D printable housing. That’s another direction I started learning last two years.

Have a nice weekend, Hans
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

RalphBacon, 2021-07-21:
@PVsolar
Good afternoon, Hans!

The new v1.35 is available from this GitHub for the Arduino IDE. I've downloaded it, compiled and uploaded to my test rig and all seems fine.

If you fancy a go please let me know how you get on by opening a new Issue!

Closed 2021-07-21.

Thread 17 (2021-07-21):

Programm too big; continiously rebooting

PVsolar, 2021-07-21:
Hello Ralph,
Thank you for your swift action to convert version 1.35. Unfortunately it did not succeed here up till now.
Because I was working on some older programs I had to replace some files before the compilation id work (cbuf, VS1053)
I also changed the playlist and wifi secrets for my own data.
Then the compilation succeeded but a failure notice poped up the the program was too big for memory.
I put the debug mode to none and that helped somewhat but I had to remove the ToDo.h to get it small enough.
After the upload the processor continiously rebooted.
I have to prepair for tomorrow now and tomorrow I have no time at all so I will continue looking for a solution on Friday and the weekend. If you have a suggestion in the mean time that will be welcome.
Kind Regards, Hans

[reboot data_V1.35- 20210721.txt](https://github.com/RalphBacon/205-Internet-Radio/files/6856755/reboot.data_V1.35-.20210721.txt)
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

rjshiffer, 2021-07-22:
@PVsolar, I  also had continuous reboots after installing v1.35 until I realized that I did not change the size of the Circular Buffer to 10000 if the changes to cbuf.cpp not installed.  The boot error messages seem identical to yours.

I changed the #define found in main.h near line 100:

    #ifdef BOARD_HAS_PSRAM
    //#define CIRCULARBUFFERSIZE 150000 // Divide by 32 to see how many 2mS samples this can store
    #define CIRCULARBUFFERSIZE 10000
    #else
    #define CIRCULARBUFFERSIZE 10000
    #endif

and the radio worked fine without other changes.  Maybe that is also your problem.

@RalphBacon, I have since changed cbuf.cpp and the Circular Buffer size to 150000 and it works without errors.  Even the station that I could not hear the audio now works!  Thanks much.

RalphBacon, 2021-07-23:
@rjshiffer, that's good news! I've since discovered that I need to change the cbuf.cpp to include some compiler directives (rather than a C++ "if" statement) otherwise if you compile a different sketch for the ESP32 you can get compilation errors. I will update in due course on my GitHub.

My cbuf.cpp file resides in this folder:
C:\Users\Ralph\AppData\Local\Arduino15\packages\esp32\hardware\esp32\1.0.6\cores\esp32

If you wish to update your cbuf.cpp file now, this is the change required:
```
//char *newbuf = new char[newSize];
// RSB Use PSRAM here if required
char *newbuf;
#ifdef BOARD_HAS_PSRAM
    newbuf = (char *)ps_malloc(newSize);
#else
#warning "PSRAM not defined or used"
    newbuf = new char[newSize];
#endif

You can remove the warning if you're not bothered about being told about no PSRAM.
	char *oldbuf = _buf;
```

PVsolar, 2021-07-23:
@rjshiffer; Thank you for your solution, it worked!!!! But that made me think: why does this work? I had installed the V1.29 cbuf.cpp so why going back to the smaller size? Just to verify, I checked the version of cbuf.cpp and that was right (V1.29). So without psram the original cbuf.cpp should work also. No way, again rebooting. Going back I changed to the cbuf.cpp from the V1.35 version. That did not work either. But with all this changes I noticed something:
@Ralph: I do have three versions of cbuf.cpp now: the original with on line 21 "#include "cbuf.h" and further no includes. The version that came with V1.29 with on line 21 - 24
"#include "cbuf.h"
"#include "esp_system.h"
"#include "esp_himem.h"
"#include "esp_heap_caps.h"
and finally the version that came with V1.35 with on line 21 and 22
"#include "cbuf.h"
"#include "esp32-hal-psram.h"
At this moment the version V1.29 is installed and the modification of @rjshiffer is in main.h The radio is working except for the "problem station", that still does not work. The difference with before is that the buffer regurarly shows some content but immediately drops to zero again and no sound is heard. (on the other radio still playing)
So for me is the question now: How can I make use of the buffer and which or maybe another version of cbuf.cpp should I use?
Regards, Hans

RalphBacon, 2021-07-23:
I've updated the instructions for updating the cbuf.cpp file for v1.35 which will ensure you use PSRAM.
https://github.com/RalphBacon/205-Internet-Radio/blob/main/Arduino%20IDE%20Version/Circular%20Buffer/readme.md

Ensure you take the entire Arduino code set for v1.35 otherwise we'll all be very confused!

PVsolar, 2021-07-24:
Hello Ralph,
I tried the 1.29 version of cbuf.cpp because the 1.35 version did not work.
I now replaced it by the 1.35 version. In combination with a smaller buffer size the program loads (up to 100k) but larger gives the reboot again. In all cases the used PSRAM is 0. The 1.35 version cbuf.cpp is not completely identical to the modifications in the "read me"  so I copied these modification in it. No difference.
During al these experiments I saw Littlefs failures and the program failed. Clearing all PSRAM and reloading and quitting and starting the arduino IDE again (to not use cash items) it succeeded to get the program working again but still no PSRAM in use. I hope you have a suggestion.
Have a nice weekend, Hans.
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

RalphBacon, 2021-07-24:
@PVsolar  Hans, I believe your Arduino IDE is not picking up the cbuf.cpp ESP32 framework as expected. I've had this before and nothing I did would make it recompile the ESP32 framework.

Can you please confirm the following for me:

1. The cbuf.cpp file you edited is found in:

RalphBacon, 2021-07-24:
@PVsolar  While you're at it, please just confirm your Arduino IDE Boards Manager entry for the ESP32 looks like this:

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

PVsolar, 2021-07-24:
Hello Ralph,
Both questions affirmative. The board manager is identical and as you can see the cbuf.cpp is in the same location. ("gebruiker" is Dutch for user)
BY the way, I had great trouble when I started this project to get littlefs running. In contrast with your instructions in the video I had to locate the mklittlefs.exe in the tools of 1.0.6. Could that be of influence?
Hans
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

RalphBacon, 2021-07-24:
@PVsolar

Yes, having the LittleFS tools in the tools folder of the core is correct:
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
(I have updated the information in my LittleFS video as so many users were having issues).

There are a couple of things you can now try to get the Arduino IDE to recompile the ESP32 framework and pick up your edits.

1. Open the Arduino IDE with your sketch loaded.
2. Change the board to another ESP32 board.
3. Recompile. You should see the following lines:

PVsolar, 2021-07-24:
Hello Ralph,
Regrettable. All lines come as you described. I did use ESP 32 Dev board all the time and now changed to ESP 32 Wrover. First attemt did not work so I changed back to DEV board (whiched worked but without PSRAM) and back again to Wrover. Now it works but still without PSRAM.
Does using another board help?

Hans

RalphBacon, 2021-07-24:
@PVsolar
Well, Hans this will be a little more work for you (but not much) to find out why the edited core is not being used.

1. Follow the **new** instructions to update the `cbuf.cpp` file, from here:
https://github.com/RalphBacon/205-Internet-Radio/tree/main/Arduino%20IDE%20Version/Circular%20Buffer
(This now uses compilation `#ifdef` conditions rather than C++ `if` statements)

2.  Compile a simple Blink sketch (so it is quick) but choose a random ESP32 board (_not_ the WROVER).

If the edit has worked you will see a compilation warning like this:
```
C:\Users\Ralph\AppData\Local\Arduino15\packages\esp32\hardware\esp32\1.0.6\cores\esp32\cbuf.cpp:57:2: warning: #warning "PSRAM not defined or used" [-Wcpp]
 #warning "PSRAM not defined or used"
```
Note: the warning will be amongst many, many lines so you may miss it if you do not pay attention! You can scroll back when the compilation has finished to double check.

If there is _no warning_ (and you followed the instruction in step 1 above) then it cannot be compiling the correct core.

Let me know you get on!

PVsolar, 2021-07-24:
Hi Ralph,
I checked the cbuf.cpp again and corrected some tab settings but all lines are as in your instructions.
I used ESP 32 pico kit and compiled several programs from examples. Blink did not work because "ledpin" was missing. None of the programs generated the warning. I also searched with ctr+F but everything seems ok.
I will try some other boards tomorrow and let you know the results.
Thank so far for the help, Hans

PVsolar, 2021-07-25:
Hello Ralph,
Partial success!!! PSRAM is available now and used. Don't ask me why but I did do following:
Used various boards and example programs but never got a cbuf warning. I noticed that with each board change I had to go through all settings in tools. (didn't do that in some ocasions before) Then I went back to wrover module and noticed there is no line to enable/disable PSRAM. However, I did try it and from now on also renewed data update also after renewing all tool settings. Back to DEV board and all over again. Then I went back to the original cbuf.cpp. No problem to load the program but still no result. Back again to the 1.35 version of cbuf.cpp AND IT WORKED. The only thing I can think of is the consequent checking the tool settings and data upload. Now I switched over to wrover module, all data and settings renewed except for PSRAM enabled because that is not there. And that also works.
The only minor thing is that my classic fm still gives no sound. In the monitor (verbose) I see 10 times low buffer and restart. The time in between the attempts is much shorter now compared to 1.29. Did you changed anything in that part? Most of the time buffer content is 0 but always the second attempt is appr. 25% and the next 0 again. Counting starts again until 10 or meta data. The content type is audio/aacp.
Also the TFT calibration seems different because I have to touch below the buttons for reaction but that I should be able to solve myself. Also the text in the station menu is shifted half the sceen as was in version 1.29. There I solved that in the program so could be done here the same I asume.
So if you have some hints to get the classic fm working I will be very happy.

Hans
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

RalphBacon, 2021-07-25:
@PVsolar
Well done on getting it working, Hans, even if it was a bit "hit and miss"!

The station listing offset is a bug in the library I am using; if you cannot solve it quickly let me know and I will dig out the simple, one-line solution.

Classic FM is playing here perfectly OK (I've been listening to it this morning). **NB the station.txt entry is this one:**
21293.live.streamtheworld.com,80,/SRGSTR25.mp3,"Classic FM Chill Out",1

I've attached what the (verbose) log looks like when I select that station
[Classic FM Chill Out - log.txt](https://github.com/RalphBacon/205-Internet-Radio/files/6873711/Classic.FM.Chill.Out.-.log.txt)

Ensure you are using the above entry in your stations.txt file and check your output against mine.

PVsolar, 2021-07-25:
Hurray,

Thank you Ralph. Your weblink dit work immediately. I do not onderstand why my web address works on the other radio and not here but there is a good saying:
If you don't understand, admire it.
I see your output is coming from main.cpp and mine from web_radio.ino. I have the setting in tools "verbose". Is there an explanation for this difference?
Thanks again. Hans
[monitor output Hans.txt](https://github.com/RalphBacon/205-Internet-Radio/files/6873838/monitor.output.Hans.txt)

PVsolar, 2021-07-25:
I see the the content type is audio/mpeg. Could that be the reason?

RalphBacon, 2021-07-25:
My output is from my VS Code (PlatformIO) "main.cpp" program which in Arduino IDE speak is "web_radio.ino". But the code is (at the moment, at least) identical!

Glad you got it working, Hans. Nothing else to do but to listen to the music? All done?

RalphBacon, 2021-07-25:
> I see the the content type is audio/mpeg. Could that be the reason?

I can listen to both URLs for that station at the moment but sometimes the non-MP3 one stops in the way you describe. So best to use the one I gave you and see how that goes.

PVsolar, 2021-07-25:
I'll check the TFT calibration for better allignment of the buttons and the position of the text in the station list so you can see the whole line. I understood from Pat that his alignment problem is not solved with version 1.35. So we will discuss that in direct e-mail.
I use the radio all day when behind the computer so now with display. I am happy.
After that, up to the next project.

RalphBacon, 2021-07-25:
The station text title is fixed by a simple edit in this file (search for RSB):
**\TFT_eSPI-2.2.23\Extensions\Button.cpp**

Just replace your TFT_eSPI-2.2.23 library with the one in my GitHub and the station text list will correct itself.

PVsolar, 2021-07-25:
You already solved all the issues. I have to think what the next project can be.

Hans

RalphBacon, 2021-12-30:
Closed.

Closed 2021-12-30.

Thread 18 (2021-07-30):

Arduino Version fails to compile

tadder, 2021-07-30:
Hi Ralph, my building work has finally been finished, it seems like a long time since I last worked on the radio, good to see you back to your regular slot on YouTube after your move.

Thanks for compiling an Arduino Version of the Internet Radio. I updated the esp32 core to 1.0.6 and used your modified cbuf.cpp file, Version 1.5 now compiles fine until it hangs at line 126 with the message:

	'class VS1053' has no member named 'setAudio'
	Could not find boards.txt in C:\Users\Tadder\AppData\Local\Arduino15\packages\esp32\	hardware\esp32\1.0.2. Is it pre-1.5?

There are two versions 1.0.2 and 1.0.6; 1.0.2 does not contain ‘boards.txt’. so I tried removing 1.0.2 to force the use of 1.0.6 but no joy.

The ‘Adafruit VS1053 Library’ is at Version 1.2.0.

I suspect I am missing something basic, but wonder if you can point me in the right direction please?

RalphBacon, 2021-07-30:
This means that you have not replaced the "official" version of the VS1053 library with the one in my GitHub, to which I've added a function (or two). You can find the library you need here, just put it in your usual "libraries" folder (which is in the sketches folder, usually).
https://github.com/RalphBacon/205-Internet-Radio/tree/main/Arduino%20IDE%20Version/ESP32-WROVER_Web_Radio/libraries

I know I shouldn't really modify other people's libraries like this but it's a work in progress!

RalphBacon, 2021-07-30:
@tadder I've just noticed you had TWO queries.

For the query regarding why "boards.txt" is missing, well, my boards.txt can be found here:
C:\Users\Ralph\AppData\Local\Arduino15\packages\esp32\hardware\esp32\1.0.6

I don't think it's changed since the last (1.0.2) release so I've attached it here for you but you really should not have had v1.0.2 _and_ v1.0.6 installed at the same time, sounds like a recipe for disaster (or, at the very least, confusion). Did you _update_ to 1.0.6 or _install_ that version (whilst keeping the previous one)?

You could try uninstalling all versions of the ESP32 framework (via the Boards Manager) and then installing only the latest.

[boards.txt](https://github.com/RalphBacon/205-Internet-Radio/files/6908172/boards.txt)

tadder, 2021-07-31:
I can confirm that the libraries folder is contained in the same folder as the ESP32-WROVER_Web_Radio.ino the date on this folder and all the files therein is 26/7/21. So I assume this is correctly using your modified libraries?

I deleted ESP32 framework and then installed 1.0.6 and this seems fine now (no reference to missing boards.text)

Unfortunately I seem to have swapped the original problem for a new one:

the compilation now terminates at line 21 of 'main.h' (#include <Preferences.h>)
with error:
_In file included from C:\Users\Tadder\Documents\Arduino\RalphBacon\July21\205-Internet-Radio-main\Arduino IDE Version\ESP32-WROVER_Web_Radio\ESP32-WROVER_Web_Radio.ino:2:0:
main.h:21:10: fatal error: Preferences.h: No such file or directory
 #include <Preferences.h>_

So I wonder where 'Prefereces' is/should be located?

I think I am almost there (or a mad optimist).

RalphBacon, 2021-08-02:
@tadder
The "Preferences.h" file is located within the ESP32 framework and allows writing to (pseudo) EEPROM for storing the last used volume, the current station and so forth.

On my Arduino IDE system (and yours too, I expect) it should be found here:
C:\Users\Ralph\AppData\Local\Arduino15\packages\esp32\hardware\esp32\1.0.6\libraries\Preferences\src

If you don't have that file then your 1.0.6 environment has not been correctly set up. Remove it from the Tools>Boards, shut down the Arduino IDE, restart it and reinstall the ESP32 boards again.

If you do have it, that's a different concern as the compiler is not finding it (but should do). Which version of the Arduino IDE are you running, 1.8.15 (the latest at time of writing)? If not, please do the upgrade as that might fix missing paths etc.

As you say, nearly there, but this is more environmental now.

tadder, 2021-08-03:
Hi Ralph,

Significant progress (I’m listening to Majestic Jukebox as I type). You were correct in suggesting that my version of the IDE was not the latest, I have now updated this to 1.8.15 and it now locates Preferences just fine.

The case of the libraries and in particular ESP_VS1053_Libary was interesting. I had read the Arduino documentation as to how the compiler determines which library to use. As you know, it starts with whatever it can find in the libraries folder in the SKETCH folder. I had deduced (incorrectly as it turns out) that libraries held in the same folder as the sketch, being further down the hierarchy would take preference, however it seems that these are ignored.

You advise that any libraries that need to be replaced (e.g. with your older proven versions) should be moved to another location, so that the replacement is picked up by the compiler. I duly renamed the library I didn’t want as ESP_VS1053_LibaryHOLD, thinking this would have the desired effect, but no, this original library was still used.

In desperation I moved the offending file to my desktop, and bingo it found the correct file. I fail to see how logically this is any different from my renaming exercise, but hey ho it works. I’m sure you are nodding your head sagely, (after all you did say) but a lesson learnt for me.

I have now to see if PSRAM is being used. This entails, as you know, monitoring the output with a serial monitor. This is something I have done in the past, but have since forgotten how to do it. It will come back to me, I’m sure, thanks for your support.

RalphBacon, 2021-08-04:
@tadder
Significant progress indeed!

The reason the "old" library was still found, even though you had renamed the folder, is because the folder name is pretty much irrelevant; the compiler digs down deep and can still find the ".h" file in a subordinate folder. Moving the old library to your desktop was a good idea: firstly, you have the old library intact, and secondly, the compiler does not consider your desktop folder a candidate for libraries so doesn't look there.

To see the serial output, load the sketch (it should have the correct port, as you have previously uploaded the code to it) and click on the magnifying glass. That will load a new window with the serial output (set the speed to 115200 if not already set).

Image shows the details:
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

tadder, 2021-08-04:
Hi Ralph,
Thanks for the explanation, helps a lot.
I have no problem with monitoring the Serial output, using either the IDE or Cool Term; my problem is getting some useful data.

If I reset I just get the following 12 lines, nothing more:

ets Jun  8 2016 00:22:57

rst:0x1 (POWERON_RESET),boot:0x13 (SPI_FAST_FLASH_BOOT)
configsip: 0, SPIWP:0xee
clk_drv:0x00,q_drv:0x00,d_drv:0x00,cs0_drv:0x00,hd_drv:0x00,wp_drv:0x00
mode:DIO, clock div:1
load:0x3fff0018,len:4
load:0x3fff001c,len:1216
ho 0 tail 12 room 4
load:0x40078000,len:10944
load:0x40080400,len:6388
entry 0x400806b4
[E][ESP32-WROVER_Web_Radio.ino:46] setup(): Version v1.210701_35 - 2021-07-01 14:37:42.854906

I wonder (pure guess work on my behalf) but could this lack of output be tied up with what we might call the Diagnostic Level? (I’m sure there is a proper name) As specified from line 12 of the project? I seem to remember you were able to monitor operation to quite a low level when conducting a soak test. Maybe this is all tied in together?

Lines of code in ESP-WROVER_Web_Radio is as follows:

// Level is set (see platformio.ini to set this)
/*
	LEVEL_NONE       (0) // Stumm. Nada. On your own.
	LEVEL_ERROR      (1) // Usually fatal
	LEVEL_WARN       (2) // Only when things go wrong
	LEVEL_INFO       (3) // Useful just to see it working
	LEVEL_DEBUG      (4) // Debugging programming
	LEVEL_VERBOSE    (5) // Every message
*/

Thanks as always.

RalphBacon, 2021-08-04:
You are indeed correct; it is the debug level that controls the output.

On the Arduino IDE make sure your parameters for the ESP32 look like this:

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

Pay special attention to the **Core Debug Level** which should be set to **Verbose** initially; once it's all running (including the circular buffer in PSRAM) we can start decreasing it.

tadder, 2021-08-04:
What a dumbo I am, I was convinced that debug level implementation would be within the code, so I didn’t look to a solution within the IDE. As you can see, I now have confirmation that PSRAM is implemented and used. Hurrah!

I have returned CIRCULARBUFFERSIZE to 150000, but the capacity indication subsequently showed between 46% and 100% accompanied with some stuttering. Returning this value to 10000 shows a 100% figure and no stuttering. Seems counter-intuitive to me, but at least the solution is obvious?

Am I correct in believing that the ‘NEXT’ function implementation via the break out pins on the PCB is yet to be implemented?

[D][esp32-hal-psram.c:47] psramInit(): PSRAM enabled
[E][ESP32-WROVER_Web_Radio.ino:46] setup(): Version v1.210701_35 - 2021-07-01 14:37:42.854906
[D][ESP32-WROVER_Web_Radio.ino:53] setup(): This board has PSRAM installed.
[D][ESP32-WROVER_Web_Radio.ino:60] setup(): Total heap: 329600
[D][ESP32-WROVER_Web_Radio.ino:61] setup(): Free heap: 303208
[D][ESP32-WROVER_Web_Radio.ino:62] setup(): Total PSRAM: 4194236
[D][ESP32-WROVER_Web_Radio.ino:63] setup(): Free PSRAM: 4044232
[D][ESP32-WROVER_Web_Radio.ino:64] setup(): Used PSRAM: 150004
[D][ESP32-WROVER_Web_Radio.ino:72] setup(): Starting SPI
[I][ESP32-WROVER_Web_Radio.ino:84] setup(): LITTLEFS system mounted SUCCESSFUL.

Thanks Ralph, now to make an enclosure.

RalphBacon, 2021-08-04:
@tadder Not a dumbo, because had you been using the PlatformIO version that is _exactly_ how I control the debugging level (hence all the comments in the code on that topic); but the Arduino IDE works differently!

You will usually get 100% buffering when using a tiny 10K buffer because the buffer is so small (therefore easy to fill with just a half-second of audio). A larger buffer may _never_ get to 100% on some stations (mine is hovering around 37% right now). But you should definitely not get stuttering with a larger buffer, quite the reverse.

The only time I get stuttering is if I start sending out too much information on the serial (debugging) port, even at 115200 baud, but even on the Verbose setting here it's been running perfectly for some months now. Whilst a song is playing you don't get much info except the name of the track/artist and how much memory is remaining.

Let me know the station URL on which you get stuttering with a large buffer (or it all of them?) and I will check it out here.

tadder, 2021-08-05:
So the percentage report indicates the amount of buffer actually used? So the lower the figure the better?
I take back what I said yesterday, there is in fact only the occasional stutter on ‘UK Dance Radio’ and two stations that don’t work at all. Very happy with that.

If you are interested here is a report on all the stations in my list and the amount of buffer reported (at 115k):

Antenne1.de				52%
BBC Radio 2 (new)			67%
BBC Radio 4 (new)			44%
Antenne1 128k			100%
Beatles 128k				100%
Mellow Magic (Redirected)		88%
Greatest Hits 112k (National)	88%
Mowtown Magic Oldies		100%
Mellow Magic (48k AAC)		37%
South East Radio (AAC 64k)		42%
UK Dance Radio			100%	occasional stutter
EZ Hits South FLA			100%
Radio Kehlkopf			connects but no sound
De Natchegaal			does not connects
Greatest Hits (Lincoln)		38%
Heckington Community Radio	100%
Radio Lincs FM			39%
Majestic Jukebox			41%
Classic FM				100%
XRDS.fm Clarksdale Mississi	100%

Thanks Ralph, I shall stop bugging you now, your support has been over and above.

RalphBacon, 2021-08-06:
@tadder Just to clarify, the higher the buffer level, the better. So 100% means that the buffer is stuffed full of data and gives the full 8 seconds of buffering. Lower than that means a correspondingly lower level of buffering but doesn't mean that you will get audio artefacts or stuttering; it all depends on the radio station.

Why are some below 100% you ask (I anticipated)? Basically, I read the streaming data upon connection to a station and mostly they return lots of data _initially_ (for buffering purposes) but then restrict it to a more "real-time" stream. Now, I could wait and continue to buffer but we would end up with a long silence before the buffer was full (Amazon Echo seems to do this and it's very annoying, that initial, long silence).

Anyway, after a few seconds, and as long as the buffer has got a "reasonable" amount (25-30% of buffer) of data in it, we start playing the audio. Some of my stations start at about 37% but over time (several hours) they creep up to that 100% mark.

Your station list percentages seem fine. You have used my "test station" list, which contains some very dodgy ones (poor connectivity, so I could test the buffering) so I'm sure that a commercial radio station will ensure trouble free streaming, in the same way I get it here.

As you're now happy I'll close this thread - but feel free to re-open if you hit any issues (or open a new thread for new issues). Happy listening!

PVsolar, 2021-08-06:
Hello Ralph, tadder,
Very interesting discussion between you and also here I learn a lot. I struggeled with the issue of which library is used in other projects as well. Also I noticed that only a simple name change is not sufficient to hide a library version from the IDE. My solution is that I created a special folder where I place all different library versions with a relation to the program where they were used. So before updating such program I have to look which librries I have to replace in the library folder. Very annoying because I sometimes forget it or miss one. I hoped that the library folder in the folder where the ino file is (like the data folder) was the preferred library but no, I had to copy them to the official library folder. But is this not a good idea to ask the Arduino team to implement? Then you can keep the library variations with the program were they are used and when there is no library in the library folder in the program folder than the IDE looks in the general library.

By the way, as I am Dutch, I saw a typo in a station name in the list: De Natchegaal must be: De Nachtegaal, meaning The Nightingale.
Hans

tadder, 2021-08-07:
Hi Hans,

I agree completely, if a library located in the same folder as the
sketch were to take priority over libraries located anywhere else this
would bring some clarity. But I suspect (complete guesswork on my part)
that the reason the Arduino team does not implement this is that it is
not really consistent with how libraries are expected to be used.
Libraries are about standing on the shoulders of those who have been
before us and ensuring we do not re-invent the wheel. Any library that
is not available to other programs (sketches) doesn’t really adhere to
this base philosophy. As a hobbyist my libraries are used by a limited
number of programs and it would be no problem to duplicate them when
required, but presumably this is not the case if you are a developer
with multiple projects on the go.

One things for certain, if it wasn't for libraries, my projects would
have to be considerably simpler and hence not so rewarding.

Brian

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

RalphBacon, 2021-08-08:
This is one reason I switched to, and remain on, PlatformIO.

In PlatformIO, one option is to add libraries for a project and they are cast in concrete, never to change again. A snapshot of what the library was, and will be for ever more. No "surprises" when you fire up the project in 12 months' time and find the library has been updated and you get compilation errors!

The other option is to tell PlatformIO which libraries you want to import (just like the Arduino) _but you can specify the versions you're willing to take_ . So you might say, I'll take all minor versions of library X at version 2 but I don't want a version 3 library because I know that will not be backward compatible.

Worth considering? Start with getting it all installed and get the Blink sketch working. Then follow the (excellent) documentation for PlatformIO on how to do the above. Yes, it's a learning curve and requires some effort but stops all the above issues with libraries mentioned for the Arduino IDE, plus a huge host of programming aids (auto completion, hints, finding the location of library functions... the list goes on).

PVsolar, 2021-08-08:
Hello Ralph, Brian,
I agree with Brian that libraries should be compatible but in practise you can not hold to that without a "library manager" who will check all updates and release a next version. Not for a volunteers platform. So implementing some system of handling various versions in parallel is not a sin in my opinion. As PlatformIO has this possibility it demonstrates that there is a need for that. Ralph, you smashes me left and right to start with IO. I was enthousiast, than you advised against it and now you make me enthousiast again. I do not blame you but you made it clear that IO has advantages but is not something you do in an afternoon. Certainly not for a beginner like me. I follow your advise and start with blink. Then I can better judge to continue or not. Thank you both for your time and help.
Hans

Closed 2021-08-06.

Thread 19 (2021-08-06):

Station List Text File Format

tadder, 2021-08-06:
Hi Ralph,
I am attempting to add extra stations to the ‘stationList.txt’ file. I have been trying unsuccessfully to ascertain the correct format for each line. I’m sure you have explained the technique somewhere in the past, but searching all the Web Radio videos and your github have so far yielded a blank. Can you offer a pointer please?

tadder, 2021-08-06:
Sorry Ralph found the asnswer in a previous issue.

Closed 2021-08-06.

Thread 20 (2021-08-13):

Future Development

tadder, 2021-08-13:
Hi Ralph,
I can see that you currently have a lot of ‘irons in the fire’ when it comes to subject matter for your channel, so I am wondering what plans (if any) you have for the WebRadio? Thanks to a lot of support from yourself I now have a working radio. I know that you have place holders within the project for possible tone controls and have mooted that maybe you would put some effort into handling http 1.1 and playlists (.pls). I can understand that you may have other priorities and if so would you consider publishing a few ‘notes’ that might allow those of us new to the code to pick up the mantle?

RalphBacon, 2021-08-13:
Yes, many irons and not enough time. Such is life. 🤷‍♂️

Regarding the ESP32 Web Radio, I never realised that so many viewers would run with it. Some, more experienced developers just take the code and get on with it, others require more hand-holding.

Now, before I develop further features I really, really want to create a new, structured GitHub that is a central repository for all the code (both Arduino IDE and PlatformIO) with examples, hints, tips & traps. This means I can point my existing GitHub repositories that cover the radio to the centralised one, with no duplication or confusion over what is the latest code.

I've fixed the http 1.1 issue now (it only affects the BBC, bless them) but dealing with playlists (.pls files) would be useful to many. Even WinAmp from 10 years ago could do this and is what I use to test out URLs.

My unit plays the radio every day, all day here in my workshop and it "just works" (except when a farmer digs up the nearby broadband line). So bugs are probably few, but I could do a "wish list" of features or usability changes and see what viewers think? Maybe someone would then "pick up the mantle" as you put it, and do that?

Of course, if I create a new GitHub, there's nothing to stop someone forking the code and doing their own thing with the option of new code being merged back into the main branch at some point - in which case I will be a consumer of other people's changes to my own code. Quite bizarre! But that's the Open Source way.

Anything specific you had in mind? Would the above approach work?

tadder, 2021-08-13:
Of course it’s this very ‘hand-holding’ that makes your projects so attractive to those of us who do require this extra support. Long term I’m sure this does enable us to develop our skills. I first discovered your Channel when you introduced me to the MAX7219 (back in 2016 would you believe). I went on to build a few projects based on this and believe I have developed general electronic knowledge since.

Back to the WebRadio, my personal view is that the tone controls may potentially be very useful. Also the ability to store a volume offset against a particular station could enable compensation for the likes of the BBC that consistently broadcast at lower levels (or is that me just being plain lazy?)

Perhaps any developments could be linked to tuition in PlatformIO? A suggestion that makes me slightly nervous, but if this is the future way forward, then those of us still hanging on to the Arduino IDE need to adapt and the more ‘hand-holding’ offered during the transition the better.

No doubt all achievable if you sacrifice any spare time you might still be hanging on to. ;-)

minolmal, 2021-12-01:
Hi Ralph,
I just finished this project and got it to work. works seamlessly with LOLIN32. I wish to adopt a WROVER and properly make it on a PCB and all. Just had to config for my setup. I've searched for a working Internet Radio project for so long. Thank you for all time and sweat you put on this. I think this project is the most reliable, almost ready-made like. 💯

I'm working on a DIY Audio setup (just the audio input methods for now.) with FM, Internet Radio, AUX, BLE. Prototype is in the making. Of course, it'll be open source. When I post it publicly, I'll sure mention you sir. :)

I'm need of a method to upload a station link, after compiling. I have few idea I'll try in future. If you'd like this development, I can sort of collaborate.

Cheers.

RalphBacon, 2021-12-01:
> Hi Ralph, I just finished this project and got it to work
<snip>
> I'm need of a method to upload a station link, after compiling. I have few ideas I want to try in future. If you'd like this development, I can sort of collaborate.
>
> Cheers.

Hi Minol, very glad you got it to work. Many others have also reported success. Using a WROVER gives you the Circular Buffer that I do find useful inasmuch that short (<8 seconds) interruptions of the data stream are hidden.

Mine is running 24 x7 here on my workbench in a lovely 3D case given to me by another constructor. I also have my original version indoors so I can listen to the radio in the shower!

If you use PlatformIO (VS Code) then the updates are much easier to do! Are you using the Arduino IDE?

UPDATE: You may find that the VS1053B hangs sometimes on switch on. It requires a small change to the hardware and code. Basically the reset pin of the VS1053B must not be connected to the reset pin of the ESP32 but to another pin, I've used pin 25 in my code. If you don't do this hardware change the software continues to work as normal (but your VS1053b may hang sometimes on startup).

I do have some PCBs available still. One PCB for the main unit, and one PCB for the TFT Touch Screen, connected via an IDC cable (rather than the unreliable DuPont cables). I also use two audio isolating transformers connected to the VS1053b output; that stops any noise/buzzing and conforms to the datasheet for that device which specifies that the COM output pin should NOT be connected to GND! Noise free and works so well. The PCB caters for these tiny (and cheap) transformers. Of course, to use my PCBs the components will have to be exactly the same as mine (I use a TTGO T8 v1.71 ESP32). Perhaps you wish to design your own PCBs?

Updating the station list could easily be accomplished via OTA updates of the SPIFFS/LittleFS partition. I have been very lazy and did not pursue this option. But if you design a solution I would be interested.

Let me know if you are interested in the PCBs and where you are in the world.

minolmal, 2021-12-01:
>Using a WROVER gives you the Circular Buffer that I do find useful inasmuch that short (<8 seconds) interruptions of the data stream are hidden.

I think WROVER is a MUST for someone who is not just making it for the sake of making it. I've already seen several stations having problems with low buffer space.

>If you use PlatformIO (VS Code) then the updates are much easier to do! Are you using the Arduino IDE?

I've migrated to PIO almost two years ago. workflow is much more forgiving and less tiring. I still use Arduino IDE for feature testing, as it need very little setting up, but I prefer PIO.

>reset pin of the VS1053B must not be connected to the reset pin of the ESP32 but to another pin

yeah, I've seen this issue in previous little projects I've done. I used ESP RESET for now, just to get things going. Thanks for the heads-up, I'll keep that in mind when I design my PCB. 👍

>Perhaps you wish to design your own PCBs?

I plan to add several other components(Rotary encoders, separate MCU for IO handling+drive a display). I will be designing my own PCB. going for 10cmx10cm stack-able design. I think I used some parts of your schematic too. Thanks for the offer. 😃

>if you design a solution I would be interested.

I'll link you after. Might take some time. I'm doing these after my regular job, sadly. 😄

Cheers.

RalphBacon, 2021-12-01:
It certainly sounds like you have all planned this out and I wish you luck.

Yes, doing this sort of thing after your day-job can be tiring, even more so if you have a family but it will keep you occupied through the cold ❄️ winter months! ⛄

If you do get any issues, or have comments or suggestions etc feel free to post here. In the meantime I'll close this as I think we are done!

RalphBacon, 2021-12-01:
Closed #20

Closed 2021-12-01.

Thread 21 (2021-12-01):

Add EasyEDA Isolating Transformers PCB project to Github repository

rjshiffer, 2021-12-01:
Hi Ralph,

Would you consider adding your EasyEDA project (schematic & PCB) for the PCB for the 2 audio isolating transformers to this repository?

I used your previously provided two EasyEDA projects found in [210-ESP32-Web-Radio-And-More](https://github.com/RalphBacon/210-ESP32-Web-Radio-PCBs-And-More) for building the radio and would like to add the transformers.  It would be nice to have the full set of PCBs available.

Thanks for considering,
Richard

RalphBacon, 2021-12-02:
Hi Richard

I hope you are well and looking forward to the festivities!

Now, regarding the PCB: I have two options: I already have a new motherboard (i.e. without the screen, which has its own PCB) which already incorporates the audio transformers. They are not electrically connected to anything as the VS1053b is not soldered directly to the motherboard; the output from the 3.5mm socket has to be wired to the PCB pads (I use 3 header pins and floating wires) and the audio output then comes from another set of 3 pins. The audio transformers fit under the VS1053b as there is room if the suggested stand-offs are used. All pretty compact and neat.

Alternatively, I have a mini PCB just for the transformers which means you also have to wire them to the motherboard but can mount it anywhere.

I do believe I have spare examples of both boards that I could send you, plus the EasyEDA project, of course. Your call!

I haven’t changed the design to route the VS1053b RESET to ESP32 GPIO pin 25 but the code assumes this.

If the hardware change hasn’t been made the code runs as it always did.

Hacking the current PCB (as I did) is pretty easy.

(very small, looks huge here)

Best Regards

Ralph S Bacon

 <https://www.youtube.com/ralphbacon> https://www.youtube.com/ralphbacon

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

rjshiffer, 2021-12-02:
Hi Ralph,

Your offer of both boards and matching EasyEDA projects sounds great.  I actually have two built radios and I'm now trying to figure out how to create enclosures for them.  (Not my greatest skill set as I've never made any kind of enclosure before.)  With both, I could experiment with different styles.

Would it be possible to have a picture of the new PCB which already incorporates the audio transformers assembled? This could give me clues both how to connect the transformers and also put it in an enclosure.

I am located in the United States, near Chicago.  Will that be a problem? Let me know what the expected postage would cost.

I hope that I'm not asking too much, but this radio is the coolest project I've made!

Thanks for all your efforts,

Richard

RalphBacon, 2021-12-03:
Email me your address (find it [here](https://www.youtube.com/RalphBacon/about)) and I'll get it organised.

I don't think the postage will be much, about £3 - £4 but I'll let you know when I've actually sent them. As you live in the States I'll put it all into a nice padded envelope that the Post Office delight in charging me extra for ("Large letter"). Yeah, right.

I'll send you pics too.

I'm delighted you think this is a cool project; as I use it every single day (it's running now) I certainly find it one of my most useful projects. More importantly I achieved what I set out to do: to be able to listen to (foreign) streaming radio that other providers insisted on telling me I could not listen to in my part of the world (due to blah blah copyright blah blah more BS). Hah! I showed them!

BTW Have you got those little transformers? I bought a few so I might have some spare too.

Speak soon!

RalphBacon, 2021-12-30:
Leaving open until confirmation that PCBs received.

Thread 22 (2022-11-06):

Mistake. What's wrong?

samand587, 2022-11-06:
Arduino: 1.8.19 (Windows 10), Board:"ESP32 Wraver Module, Default 4MB with spiffs (1.2MB APP/1.5MB SPIFFS), QIO, 80MHz, 921600, None, Disabled"

C:\Users\Nestor\Documents\Arduino\libraries\LITTLEFS-master\src\LITTLEFS.cpp: In member function 'virtual bool LITTLEFSImpl::exists(const char*)':
C:\Users\Nestor\Documents\Arduino\libraries\LITTLEFS-master\src\LITTLEFS.cpp:44:28: error: no matching function for call to 'LITTLEFSImpl::open(const char*&, const char [2])'
File f = open(path, "r");
^
In file included from C:\Users\Nestor\Documents\Arduino\libraries\LITTLEFS-master\src\LITTLEFS.cpp:17:
C:\Users\Nestor\AppData\Local\Arduino15\packages\esp32\hardware\esp32\2.0.5\libraries\FS\src/vfs_api.h:38:17: note: candidate: 'virtual fs::FileImplPtr VFSImpl::open(const char*, const char*, bool)'
FileImplPtr open(const char* path, const char* mode, const bool create) override;
^~~~
C:\Users\Nestor\AppData\Local\Arduino15\packages\esp32\hardware\esp32\2.0.5\libraries\FS\src/vfs_api.h:38:17: note: candidate expects 3 arguments, 2 provided
Several libraries found for "Preferences.h"
Is used by: C:\Users\Nestor\AppData\Local\Arduino15\packages\esp32\hardware\esp32\2.0.5\libraries\Preferences
Not used: C:\Users\Nestor\Documents\Arduino\libraries\Preferences-2.0.0
Several libraries found for "WiFi.h"
Is used by: C:\Users\Nestor\AppData\Local\Arduino15\packages\esp32\hardware\esp32\2.0.5\libraries\WiFi
Not used: C:\Program Files (x86)\Arduino\libraries\WiFi
exit status 1
Compilation error for the ESP32 Wrover Module board.

samand587, 2022-11-07:
I fixed it a little and I get this error. What can I see?

Arduino: 1.8.19 (Windows 10), Board:"ESP32 Wrover Module, No OTA (2MB APP/2MB SPIFFS), QIO, 80MHz, 921600, Verbose, Disabled"

C:\Users\Nestor\Documents\Arduino\libraries\LittleFS_esp32-1.0.6\src\LITTLEFS.cpp: In member function 'virtual bool LITTLEFSImpl::exists(const char*)':
C:\Users\Nestor\Documents\Arduino\libraries\LittleFS_esp32-1.0.6\src\LITTLEFS.cpp:44:28: error: no matching function for call to 'LITTLEFSImpl::open(const char*&, const char [2])'
File f = open(path, "r");
^
In file included from C:\Users\Nestor\Documents\Arduino\libraries\LittleFS_esp32-1.0.6\src\LITTLEFS.cpp:17:
C:\Users\Nestor\AppData\Local\Arduino15\packages\esp32\hardware\esp32\2.0.5\libraries\FS\src/vfs_api.h:38:17: note: candidate: 'virtual fs::FileImplPtr VFSImpl::open(const char*, const char*, bool)'
FileImplPtr open(const char* path, const char* mode, const bool create) override;
^~~~
C:\Users\Nestor\AppData\Local\Arduino15\packages\esp32\hardware\esp32\2.0.5\libraries\FS\src/vfs_api.h:38:17: note: candidate expects 3 arguments, 2 provided
Several libraries found for "WiFi.h"
Is used by: C:\Users\Nestor\AppData\Local\Arduino15\packages\esp32\hardware\esp32\2.0.5\libraries\WiFi
Not used: C:\Program Files (x86)\Arduino\libraries\WiFi
exit status 1
Compilation error for the ESP32 Wrover Module board.

RalphBacon, 2022-11-07:
Things have changed with LittleFS it would seem. I know that Espressif were planning to integrate it into the main ESP framework.

I will have to look at this in more detail but I cannot do this before Tuesday afternoon (8th Nov). Please standby!

samand587, 2022-11-10:
Hello, friend! I managed to fill in the sketch. I can see it in the port monitor. I have nothing but the ESP connected yet. Is this how it should be? And where can I get the connection diagram? Thanks!

Rebooting...
ets Jun  8 2016 00:22:57

rst:0xc (SW_CPU_RESET),boot:0x13 (SPI_FAST_FLASH_BOOT)
configsip: 0, SPIWP:0xee
clk_drv:0x00,q_drv:0x00,d_drv:0x00,cs0_drv:0x00,hd_drv:0x00,wp_drv:0x00
mode:DIO, clock div:1
load:0x3fff0018,len:4
load:0x3fff001c,len:1216
ho 0 tail 12 room 4
load:0x40078000,len:10944
load:0x40080400,len:6388
entry 0x400806b4
[E][ESP32-WROVER_Web_Radio.ino:46] setup(): Version v1.210701_35 - 2021-07-01 14:37:42.854906
abort() was called at PC 0x4014fe03 on core 1

ELF file SHA256: 0000000000000000

Backtrace: 0x4008d924:0x3ffb1dc0 0x4008db9d:0x3ffb1de0 0x4014fe03:0x3ffb1e00 0x4014fe4a:0x3ffb1e20 0x4014f523:0x3ffb1e40 0x4014f85a:0x3ffb1e60 0x4014f5c1:0x3ffb1e80 0x400e2122:0x3ffb1ea0 0x400d4499:0x3ffb1ec0 0x400e21b6:0x3ffb1fb0 0x4008eba2:0x3ffb1fd0

Rebooting...
ets Jun  8 2016 00:22:57

samand587, 2022-11-10:
I tried to connect VS1053 according to the scheme shown here. Nothing changes, there is no sound, there is a constant reboot. What am I doing wrong? Here is the log

Rebooting...
ets Jun 8 2016 00:22:57

rst:0xc (SW_CPU_RESET),boot:0x13 (SPI_FAST_FLASH_BOOT)
configsip: 0, SPIWP:0xee
clk_drv:0x00,q_drv:0x00,d_drv:0x00,cs0_drv:0x00,hd_drv:0x00,wp_drv:0x00
mode:DIO, clock div:1
load:0x3fff0018,len:4
load:0x3fff001c,len:1216
ho 0 tail 12 room 4
load:0x40078000,len:10944
load:0x40080400,len:6388
entry 0x400806b4
[E][ESP32-WROVER_Web_Radio.ino:46] setup(): Version v1.210701_35 - 2021-07-01 14:37:42.854906
abort() was called at PC 0x4014fe03 on core 1

ELF file SHA256: 0000000000000000

Backtrace: 0x4008d924:0x3ffb1dc0 0x4008db9d:0x3ffb1de0 0x4014fe03:0x3ffb1e00 0x4014fe4a:0x3ffb1e20 0x4014f523:0x3ffb1e40 0x4014f85a:0x3ffb1e60 0x4014f5c1:0x3ffb1e80 0x400e2122:0x3ffb1ea0 0x400d4499:0x3ffb1ec0 0x400e21b6:0x3ffb1fb0 0x4008eba2:0x3ffb1fd0

Rebooting...
ets Jun 8 2016 00:22:57

dhcnet47, 2022-11-10:
Try

https://github.com/RalphBacon/205-Internet-Radio/tree/main/Arduino%20IDE%20Version/Circular%20Buffer

this fixed it for me!

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

dhcnet47, 2022-11-10:
Sorry Ralph we crossed in or replies

Dave

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

samand587, 2022-11-10:
Dear author!
Please indicate where and in which file you need to make changes. I can't find the line you specified. Thanks!

samand587, 2022-11-10:
Changed in the main.h
#ifdef BOARD_HAS_PARAM file
#define CIRCULAR BUFFER SIZE 150000 <-- change this value to 10000
#else
#define CIRCULAR BUFFER SIZE 10000
#endif

The reboot has stopped, I get this, there is no sound.

ets Jun 8 2016 00:22:57

rst:0x1 (POWERON_RESET),boot:0x13 (SPI_FAST_FLASH_BOOT)
flash read err, 1000
ets_main.c 371
ets Jun 8 2016 00:22:57

rst:0x10 (RTCWDT_RTC_RESET),boot:0x13 (SPI_FAST_FLASH_BOOT)
configsip: 0, SPIWP:0xee
clk_drv:0x00,q_drv:0x00,d_drv:0x00,cs0_drv:0x00,hd_drv:0x00,wp_drv:0x00
mode:DIO, clock div:1
load:0x3fff0018,len:4
load:0x3fff001c,len:1216
ho 0 tail 12 room 4
load:0x40078000,len:10944
load:0x40080400,len:6388
entry 0x400806b4
[E][ESP32-WROVER_Web_Radio.ino:46] setup(): Version v1.210701_35 - 2021-07-01 14:37:42.854906
C:\Users\Nestor\Documents\Arduino\libraries\LITTLEFS-master\src\lfs.c:1076:error: Corrupted dir pair at {0x0, 0x1}
E (865) esp_littlefs: mount failed, (-84)
E (869) esp_littlefs: Failed to initialize LittleFS

dhcnet47, 2022-11-10:
Have you created/uploaded the littlefs data?

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

RalphBacon, 2022-11-10:
You need to understand how to upload a LittleFS partition to your ESP32.

That is where various files are held (including the station list). See video #203 https://youtu.be/4r6YZlLfKfw

Luckily, the LittleFS system is now standard (you don't need to do anything to use it as far as I know) but you do need to upload a partition contained in your /data folder.

RalphBacon, 2022-11-10:
@dhcnet47 Don't worry about crossing replies! I'm currently under pressure to edit my next video so any help you can give is welcomed!

samand587, 2022-11-10:
Thank you, author! I'll try!
I did it
Changed in the main.h
#ifdef BOARD_HAS_PARAM file
#define CIRCULAR BUFFER SIZE 150000 <-- change this value to 10000
#else
#define CIRCULAR BUFFER SIZE 10000
#endif

dhcnet47, 2022-11-10:
It is exactly 12 months since I built my webradio!  Thanks for the help you gave me!

Dave

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

samand587, 2022-11-11:
Hi! Installed LittleFS What to see next? I get this error Thanks!
Arduino: 1.8.19 (Windows 10), Плата:"ESP32 Wrover Module, No OTA (2MB APP/2MB SPIFFS), QIO, 80MHz, 921600, None"

Chip : esp32
Using partition scheme from Arduino IDE.
Start: 0x210000
Size : 0x1f0000

LittleFS Error: mklittlefsnot found!

samand587, 2022-11-11:
Hi! I started the radio, but there are problems. The TOUCH does not work. When turned on, it writes: "Start audio player" and does not go further. The decoder and display are working properly, I checked the wiring. What can I see? And how is the playlist created? Thanks!

RalphBacon, 2022-11-11:
When you compile the code using the Arduino IDE, please set the Core Debugging Level option (Menu > Tools) to 5. This will give more output so I can see what is going on exactly. Then re-post the output which should have entries like@
[I][ESP32-WROVER_Web_Radio.ino:62] setup() LITTLEFS system mounted SUCCESSFUL

Note that the first character of these messages indicate the severity. V = verbose, D = debug, I=information, W = warning (something has gone wrong) and E = fatal error.

samand587, 2022-11-11:
ets Jun  8 2016 00:22:57

rst:0x1 (POWERON_RESET),boot:0x13 (SPI_FAST_FLASH_BOOT)
configsip: 0, SPIWP:0xee
clk_drv:0x00,q_drv:0x00,d_drv:0x00,cs0_drv:0x00,hd_drv:0x00,wp_drv:0x00
mode:DIO, clock div:1
load:0x3fff0018,len:4
load:0x3fff001c,len:1216
ho 0 tail 12 room 4
load:0x40078000,len:10944
load:0x40080400,len:6388
entry 0x400806b4
[D][esp32-hal-psram.c:47] psramInit(): PSRAM enabled
[E][ESP32-WROVER_Web_Radio.ino:46] setup(): Version v1.210701_35 - 2021-07-01 14:37:42.854906
[D][ESP32-WROVER_Web_Radio.ino:53] setup(): This board has PSRAM installed.
[D][ESP32-WROVER_Web_Radio.ino:60] setup(): Total heap: 329652
[D][ESP32-WROVER_Web_Radio.ino:61] setup(): Free heap: 303176
[D][ESP32-WROVER_Web_Radio.ino:62] setup(): Total PSRAM: 4194236
[D][ESP32-WROVER_Web_Radio.ino:63] setup(): Free PSRAM: 4184232
[D][ESP32-WROVER_Web_Radio.ino:64] setup(): Used PSRAM: 10004
[D][ESP32-WROVER_Web_Radio.ino:72] setup(): Starting SPI
[I][ESP32-WROVER_Web_Radio.ino:84] setup(): LITTLEFS system mounted SUCCESSFUL.
[D][tftHelpers.h:90] initDisplay(): 0179,
[D][tftHelpers.h:90] initDisplay(): 0DD2,
[D][tftHelpers.h:90] initDisplay(): 0104,
[D][tftHelpers.h:90] initDisplay(): 0DD2,
[D][tftHelpers.h:90] initDisplay(): 0007,
[I][tftHelpers.h:94] initDisplay(): Touch Calibration completed
[E][esp32-hal-cpu.c:93] addApbChangeCallback(): duplicate func=400E2A78 arg=3FFBDDB4
[I][tftHelpers.h:219] setupDisplayModule(): TFT Initialised
[D][ESP32-WROVER_Web_Radio.ino:92] setup(): Starting Audio Player.
[D][VS1053.cpp:156] begin():

[D][VS1053.cpp:157] begin(): Reset VS1053...

[D][VS1053.cpp:161] begin(): End reset VS1053...

[D][VS1053.cpp:119] testComm(): VS1053 not properly installed!

RalphBacon, 2022-11-11:
So now you have your error. Correct the wiring for the VS1053 and it will progress beyond this stage.

samand587, 2022-11-12:
Hi! I checked the audio board on another project KaRadio 32. Everything works fine! I don't know why he doesn't want to run in your project. Can you tell me? Thanks!

RalphBacon, 2022-11-12:
I've looked at which pins are connected to the VS1053 from the ESP32. Can you confirm you have these:

VS1053_CS       32
VS1053_DCS    33
VS1053_DREQ  35

The VS1053 used to occasionally stop at this point so I updated the code in Visual Studio (but not Arduino) to specifically reset the VS1053 using pin D25.

// Separate reset for the VS1053
#define VS1053_RST 25

I then connected the VS1053 to pin 25 on the ESP32 and executed this code around line 88 of main.cpp, just before starting the Audio Player command: player.begin():

```
    // VS1053 MP3 decoder. If we don't get a response continue anyway.
    log_d("Starting Audio Player.");
    displayTrackArtist("Starting Audio Player.");

    pinMode(VS1053_RST, OUTPUT);
    digitalWrite(VS1053_RST, LOW);
    delay(100);
    digitalWrite(VS1053_RST, HIGH);
```

If you want to try this to see whether it fixes your issue let me know how you get on. But please do double check that wiring again!

samand587, 2022-11-12:
I checked the wiring, everything matches. I completely updated the wiring - nothing has changed! I am ready for any action, but I have little experience and need a hint. Thanks!

samand587, 2022-11-13:
Hi! When I insert
pinMode(VS1053_RST, OUTPUT) into the code;
digitalWrite(VS1053_RST, LOW);
delay(100);
digitalWrite(VS1053_RST, HIGH);
then I get this error
Arduino: 1.8.19 (Windows 10), Board:"ECP32 Rover Module, No OTO (2 MB APP/2MB SPIFFS), QIO, 80 MHz, 921600, None"

C:\Users\Nestor\Documents\Arduino\ESP32-WROVER_Web_Radio\ESP32-WROVER_Web_Radio.ino: In function 'void setup()':
ESP32-WROVER_Web_Radio:94:11: error: 'VS1053_RST' was not declared in this scope
pinMode(VS1053_RST, OUTPUT);
^
Several libraries found for "WiFi.h"
Used by: C:\Users\Nestor\AppData\Local\Arduino15\packages\esp32\hardware\esp32\1.0.6\libraries\WiFi
Not used: C:\Program Files (x86)\Arduino\libraries\WiFi
exit status 1
'VS1053_RST' was not declared in this scope

RalphBacon, 2022-11-13:
Before the extra code you have added, insert this line:

int VS1053_RST = 25;

Recompile, upload and don't forget to connect the RESET of the VS1053 to pin 25 of y our ESP32.

samand587, 2022-11-13:
Great! The player began to load, I go to the main screen, but there is no connection to the station, there is no sound, the TOUCH does not work. The monitor writes this

[D][ESP32-WROVER_Web_Radio.ino:601] stationConnect(): -----------------------------------
[D][ESP32-WROVER_Web_Radio.ino:602] stationConnect():      Connecting to station 0
[D][ESP32-WROVER_Web_Radio.ino:603] stationConnect(): -----------------------------------
[D][ESP32-WROVER_Web_Radio.ino:604] stationConnect(): HOST: stream.antenne1.de
[D][ESP32-WROVER_Web_Radio.ino:605] stationConnect(): PATH: /a1stg/livestream1.aac
[D][ESP32-WROVER_Web_Radio.ino:606] stationConnect(): PORT: 80
[D][ESP32-WROVER_Web_Radio.ino:607] stationConnect(): NAME: Antenne1.de
[D][ESP32-WROVER_Web_Radio.ino:608] stationConnect(): DATA: Yes
[I][ESP32-WROVER_Web_Radio.ino:638] stationConnect(): Free memory: 238668 bytes
[D][ESP32-WROVER_Web_Radio.ino:673] stationConnect(): Host: stream.antenne1.de Port:80
[D][ESP32-WROVER_Web_Radio.ino:693] stationConnect(): Connected to stream.antenne1.de (Antenne1.de)
[I][ESP32-WROVER_Web_Radio.ino:703] stationConnect(): Getting data from /a1stg/livestream1.aac (WITHOUT Metadata)
[D][ESP32-WROVER_Web_Radio.ino:712] stationConnect(): Waiting for header data
[D][ESP32-WROVER_Web_Radio.ino:738] stationConnect(): HEADER: HTTP/1.0 200 OK
[D][ESP32-WROVER_Web_Radio.ino:743] stationConnect(): 200 - OK response
[D][ESP32-WROVER_Web_Radio.ino:738] stationConnect(): HEADER: icy-br: 64
[D][ESP32-WROVER_Web_Radio.ino:785] stationConnect(): Bit rate:64
[D][ESP32-WROVER_Web_Radio.ino:738] stationConnect(): HEADER: icy-pub: 1
[D][ESP32-WROVER_Web_Radio.ino:738] stationConnect(): HEADER: icy-description: Region Stuttgart
[D][ESP32-WROVER_Web_Radio.ino:738] stationConnect(): HEADER: icy-audio-info: ice-samplerate=44100;ice-bitrate=64;ice-channels=2
[D][ESP32-WROVER_Web_Radio.ino:738] stationConnect(): HEADER: icy-url: http://www.antenne1.de
[D][ESP32-WROVER_Web_Radio.ino:738] stationConnect(): HEADER: Instance-id: d6d68036ca9c006af472aaba10b854ea
[D][ESP32-WROVER_Web_Radio.ino:738] stationConnect(): HEADER: Cache-Control: no-cache
[D][ESP32-WROVER_Web_Radio.ino:738] stationConnect(): HEADER: Server: Antenne 1 Streaming 8.4.3
[D][ESP32-WROVER_Web_Radio.ino:738] stationConnect(): HEADER: icy-genre: antenne 1 Stuttgart
[D][ESP32-WROVER_Web_Radio.ino:738] stationConnect(): HEADER: Expires: Mon, 26 Jul 1997 05:00:00 GMT
[D][ESP32-WROVER_Web_Radio.ino:738] stationConnect(): HEADER: icy-metaint: 0
[D][ESP32-WROVER_Web_Radio.ino:769] stationConnect(): NEW Metadata Interval:0
[D][ESP32-WROVER_Web_Radio.ino:738] stationConnect(): HEADER: Pragma: no-cache
[D][ESP32-WROVER_Web_Radio.ino:738] stationConnect(): HEADER: icy-name: antenne 1 Stuttgart
[D][ESP32-WROVER_Web_Radio.ino:738] stationConnect(): HEADER: Connection: close
[D][ESP32-WROVER_Web_Radio.ino:738] stationConnect(): HEADER: Content-Type: audio/aacp
[D][ESP32-WROVER_Web_Radio.ino:738] stationConnect(): HEADER: Set-Cookie: AISSessionId=634f369cbb1bcec0_2190739_4T3oxmDA__0000000h2Ef; Path=/; Domain=stream.antenne1.de; Max-Age=6000; Expires=Sun, 13 Nov 2022 09:41:10 GMT
[D][ESP32-WROVER_Web_Radio.ino:738] stationConnect(): HEADER:
[D][ESP32-WROVER_Web_Radio.ino:405] readHttpStream(): Low buffer: 0%, occurence 1
[D][ESP32-WROVER_Web_Radio.ino:405] readHttpStream(): Low buffer: 0%, occurence 2
[D][ESP32-WROVER_Web_Radio.ino:405] readHttpStream(): Low buffer: 0%, occurence 3
[D][ESP32-WROVER_Web_Radio.ino:405] readHttpStream(): Low buffer: 0%, occurence 4
[D][ESP32-WROVER_Web_Radio.ino:405] readHttpStream(): Low buffer: 0%, occurence 5
[D][ESP32-WROVER_Web_Radio.ino:405] readHttpStream(): Low buffer: 0%, occurence 6

RalphBacon, 2022-11-13:
OK, this line
```
readHttpStream(): Low buffer: 0%,
```
means that it cannot read the stream data. Try pressing RESET on the ESP32 to see if that changes anything.

Or perhaps the stream is blocked by your ISP. Which country do you live in? I can then find a suitable (local) station to try it on.

Also a (small) picture of the front screen would be useful.

samand587, 2022-11-13:
My country is Russia. I tried to change the playlist- I'm probably not doing it right, but it's playing. I attach the reboot log.

rst:0x1 (POWERON_RESET),boot:0x13 (SPI_FAST_FLASH_BOOT)
configsip: 0, SPIWP:0xee
clk_drv:0x00,q_drv:0x00,d_drv:0x00,cs0_drv:0x00,hd_drv:0x00,wp_drv:0x00
mode:DIO, clock div:1
load:0x3fff0018,len:4
load:0x3fff001c,len:1216
ho 0 tail 12 room 4
load:0x40078000,len:10944
load:0x40080400,len:6388
entry 0x400806b4
[D][esp32-hal-psram.c:47] psramInit(): PSRAM enabled
[E][ESP32-WROVER_Web_Radio.ino:46] setup(): Version v1.210701_35 - 2021-07-01 14:37:42.854906
[D][ESP32-WROVER_Web_Radio.ino:53] setup(): This board has PSRAM installed.
[D][ESP32-WROVER_Web_Radio.ino:60] setup(): Total heap: 329668
[D][ESP32-WROVER_Web_Radio.ino:61] setup(): Free heap: 303320
[D][ESP32-WROVER_Web_Radio.ino:62] setup(): Total PSRAM: 4194236
[D][ESP32-WROVER_Web_Radio.ino:63] setup(): Free PSRAM: 4184232
[D][ESP32-WROVER_Web_Radio.ino:64] setup(): Used PSRAM: 10004
[D][ESP32-WROVER_Web_Radio.ino:72] setup(): Starting SPI
[I][ESP32-WROVER_Web_Radio.ino:84] setup(): LITTLEFS system mounted SUCCESSFUL.
[D][tftHelpers.h:90] initDisplay(): 0179,
[D][tftHelpers.h:90] initDisplay(): 0DD2,
[D][tftHelpers.h:90] initDisplay(): 0104,
[D][tftHelpers.h:90] initDisplay(): 0DD2,
[D][tftHelpers.h:90] initDisplay(): 0007,
[I][tftHelpers.h:94] initDisplay(): Touch Calibration completed
[E][esp32-hal-cpu.c:93] addApbChangeCallback(): duplicate func=400E2AA0 arg=3FFBDDB4
[I][tftHelpers.h:219] setupDisplayModule(): TFT Initialised
[D][ESP32-WROVER_Web_Radio.ino:92] setup(): Starting Audio Player.
[D][VS1053.cpp:156] begin():

[D][VS1053.cpp:157] begin(): Reset VS1053...

[D][VS1053.cpp:161] begin(): End reset VS1053...

[D][VS1053.cpp:132] testComm(): Slow SPI,Testing VS1053 read/write registers...

[D][VS1053.cpp:132] testComm(): Fast SPI, Testing VS1053 read/write registers again...

[D][VS1053.cpp:183] begin(): endFillByte is 0

[D][ESP32-WROVER_Web_Radio.ino:108] setup(): Switch player to MP3 mode
[D][VS1053.cpp:307] switchToMp3Mode(): Switched to mp3 mode

[D][VS1053.cpp:273] softReset(): Performing soft-reset

[D][ESP32-WROVER_Web_Radio.ino:122] setup(): Treble boost expected to be: 82, is: 82
[D][ESP32-WROVER_Web_Radio.ino:128] setup(): Bass boost expected to be: 138, is: 138
[I][stationSelectHelper.h:467] populateStationList(): Radio stations imported successfully.
[D][stationSelectHelper.h:478] populateStationList(): 0 - stream.antenne1.de /a1stg/livestream1.aac 80 (Antenne1.de) YES
[D][stationSelectHelper.h:478] populateStationList(): 1 - stream.live.vc.bbcmedia.co.uk /bbc_radio_two 80 (BBC Radio 2 (new)) NO
[D][stationSelectHelper.h:478] populateStationList(): 2 - stream.live.vc.bbcmedia.co.uk /bbc_radio_fourfm 80 (BBC Radio 4 (new)) NO
[D][stationSelectHelper.h:478] populateStationList(): 3 - stream.antenne1.de /a1stg/livestream2.mp3 80 (Antenne1 128k) YES
[D][stationSelectHelper.h:478] populateStationList(): 4 - listen.181fm.com /181-beatles_128k.mp3 80 (Beatles 128k) YES
[D][stationSelectHelper.h:478] populateStationList(): 5 - stream-mz.planetradio.co.uk /magicmellow.mp3 80 (Mellow Magic (Redirected)) YES
[D][stationSelectHelper.h:478] populateStationList(): 6 - edge-bauermz-03-gos2.sharp-stream.com /net2national.mp3 80 (Greatest Hits 112k (National)) YES
[D][stationSelectHelper.h:478] populateStationList(): 7 - airspectrum.cdnstream1.com /1302_192 8024 (Mowtown Magic Oldies) YES
[D][stationSelectHelper.h:478] populateStationList(): 8 - live-bauer-mz.sharp-stream.com /magicmellow.aac 80 (Mellow Magic (48k AAC)) YES
[D][stationSelectHelper.h:478] populateStationList(): 9 - stream.btsstream.com /seaac 8000 (South East Radio (AAC 64k)) YES
[D][stationSelectHelper.h:478] populateStationList(): 10 - uk2.internet-radio.com / 8024 (UK Dance Radio) YES
[D][stationSelectHelper.h:478] populateStationList(): 11 - us4.internet-radio.com /stream?type=http&nocache=72 8197 (EZ Hits South FLA) NO
[D][stationSelectHelper.h:478] populateStationList(): 12 - s1.slotex.pl / 7274 (Radio Kehlkopf) NO
[D][stationSelectHelper.h:478] populateStationList(): 13 - 204.187.100.18 / 1485 (De Natchegaal) YES
[D][stationSelectHelper.h:478] populateStationList(): 14 - live-bauer-mz.sharp-stream.com /net2lincoln.aac 80 (Greatest Hits (Lincoln)) YES
[D][stationSelectHelper.h:478] populateStationList(): 15 - ais-edge09-live365-dal02.cdnstream.com /a52107?listenerId=esAdblock0650048 80 (Heckington Community Radio) YES
[D][stationSelectHelper.h:478] populateStationList(): 16 - live-bauer-mz.sharp-stream.com /net1lincoln.aac 80 (Radio Lincs FM) YES
[D][stationSelectHelper.h:478] populateStationList(): 17 - uk3.internet-radio.com /live 8405 (Majestic Jukebox) YES
[D][stationSelectHelper.h:478] populateStationList(): 18 - media-ice.musicradio.com /ClassicFMMP3 80 (Classic FM) YES
[I][stationSelectHelper.h:83] stationSelectSetup(): Total stations found: 19
[D][stationSelectHelper.h:87] stationSelectSetup(): This will require 4 pages
[D][ESP32-WROVER_Web_Radio.ino:900] readLITTLEFSInfo(): LITTLEFS parameter 'SSID'
[D][ESP32-WROVER_Web_Radio.ino:900] readLITTLEFSInfo(): LITTLEFS parameter 'WiFiPassword'
[D][wifiHelpers.h:8] connectToWifi(): -----------------------------------
[D][wifiHelpers.h:9] connectToWifi(): Connecting to SSID: dlink
[D][wifiHelpers.h:10] connectToWifi(): -----------------------------------
[D][wifiHelpers.h:21] connectToWifi(): Setting ESP32 to STA mode
[D][WiFiGeneric.cpp:374] _eventCallback(): Event: 0 - WIFI_READY
[D][wifiHelpers.h:25] connectToWifi(): Setting ESP32 to NOT store credentials in NVR
[D][WiFiGeneric.cpp:374] _eventCallback(): Event: 2 - STA_START
[D][wifiHelpers.h:29] connectToWifi(): Setting ESP32 to NOT allow sleep
[D][wifiHelpers.h:32] connectToWifi(): Setting ESP32 to ALLOW auto re-connect
[D][wifiHelpers.h:44] connectToWifi(): Initiating connection with WiFi.
[D][wifiHelpers.h:47] connectToWifi(): Setting ESP32 to REDUCE maximum transmit power
[D][wifiHelpers.h:53] connectToWifi(): Waiting for WiFi connection...
[D][WiFiGeneric.cpp:374] _eventCallback(): Event: 4 - STA_CONNECTED
[D][WiFiGeneric.cpp:374] _eventCallback(): Event: 7 - STA_GOT_IP
[D][WiFiGeneric.cpp:419] _eventCallback(): STA IP: 192.168.0.110, MASK: 255.255.255.0, GW: 192.168.0.1
[D][wifiHelpers.h:63] connectToWifi(): WiFi connected with (local) IP address of: 192.168.0.110
[D][ESP32-WROVER_Web_Radio.ino:197] setup(): Current station 0 appears on page 0
[D][ESP32-WROVER_Web_Radio.ino:201] setup(): Current station number: 0
[D][ESP32-WROVER_Web_Radio.ino:601] stationConnect(): -----------------------------------
[D][ESP32-WROVER_Web_Radio.ino:602] stationConnect():      Connecting to station 0
[D][ESP32-WROVER_Web_Radio.ino:603] stationConnect(): -----------------------------------
[D][ESP32-WROVER_Web_Radio.ino:604] stationConnect(): HOST: stream.antenne1.de
[D][ESP32-WROVER_Web_Radio.ino:605] stationConnect(): PATH: /a1stg/livestream1.aac
[D][ESP32-WROVER_Web_Radio.ino:606] stationConnect(): PORT: 80
[D][ESP32-WROVER_Web_Radio.ino:607] stationConnect(): NAME: Antenne1.de
[D][ESP32-WROVER_Web_Radio.ino:608] stationConnect(): DATA: Yes
[D][ESP32-WROVER_Web_Radio.ino:1253] fadeOutMusic(): Fading music OUT
[D][ESP32-WROVER_Web_Radio.ino:633] stationConnect(): Circ buffer FLUSHED
[I][ESP32-WROVER_Web_Radio.ino:638] stationConnect(): Free memory: 245008 bytes
[D][ESP32-WROVER_Web_Radio.ino:673] stationConnect(): Host: stream.antenne1.de Port:80
[D][ESP32-WROVER_Web_Radio.ino:693] stationConnect(): Connected to stream.antenne1.de (Antenne1.de)
[I][ESP32-WROVER_Web_Radio.ino:703] stationConnect(): Getting data from /a1stg/livestream1.aac (WITHOUT Metadata)
[D][ESP32-WROVER_Web_Radio.ino:712] stationConnect(): Waiting for header data
[D][ESP32-WROVER_Web_Radio.ino:738] stationConnect(): HEADER: HTTP/1.0 200 OK
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

Thread 23 (2023-06-12):

How to turn all led on on a stepper to run the stepper motor

yoongteng, 2023-06-12:
Hi guys my issue on this project is when i run the below code. The stepper led lights up one by one and cant function the stepper motor. The load cell works well with the oled display. Izit the interruption between virtual pin that cause this issue?

#include <TFT_eSPI.h>

/* Comment this out to disable prints and save space */
#define BLYNK_PRINT Serial

#include <Stepper.h>
#include <HX711.h>
#include <Wire.h>
#include "soc/rtc.h"
#include <stdlib.h>
#include <Adafruit_GFX.h>
#include <Adafruit_SSD1306.h>
#include <SimpleTimer.h>
#include "esp32-hal-cpu.h"

#include <WiFi.h>
#include <WiFiClient.h>
const char ssid[] = "4G CPE FF5A"; // WiFi name
const char password[] = "yuankai00"; // WiFi password

const int LOADCELL1_DOUT_PIN = 19;
const int LOADCELL_SCK_PIN = 23;

#define SENSORCNT 1
HX711 scale[SENSORCNT];

// Define the pins for the OLED display
const int OLED_SDA_PIN = 21;
const int OLED_SCL_PIN = 22;

int rbutton = 18; // this button will be used to reset the scale to 0.
String myString;
String cmessage; // complete message
char buff[10];
float weight;
float calibration_factor = 410.45; // for me this vlaue works just perfect 206140

SimpleTimer timer;

// for the OLED display

#define SCREEN_WIDTH 128 // OLED display width, in pixels
#define SCREEN_HEIGHT 64 // OLED display height, in pixels

// Declaration for an SSD1306 display connected to I2C (SDA, SCL pins)
#define OLED_RESET     -1 // Reset pin # (or -1 if sharing Arduino reset pin)
Adafruit_SSD1306 display(SCREEN_WIDTH, SCREEN_HEIGHT, &Wire, OLED_RESET);

#include <BlynkSimpleEsp32.h>
char auth[] = "lQkgSEGxVzm3SAfET_85JU7DE3tCP1v7"; // Blynk Authentication Token
WiFiServer server(80);

#include <SPI.h>
#include <TFT_eSPI.h>
TFT_eSPI tft = TFT_eSPI(); // Resolution 135 x 240
#define FF17 &FreeSans9pt7b
#define FF21 &FreeSansBold9pt7b
#define ROW1 0,16
#define ROW2 0,38
#define ROW3 0,60
#define ROW4 0,82
#define ROW5 0,104
#define ROW6 0,126

#define BUTTON1 35
#define BUTTON2 0

#define STEPPER_IN1 27
#define STEPPER_IN2 26
#define STEPPER_IN3 25
#define STEPPER_IN4 33

#define REVOLUTION_STEP 2048 // 1 revolution

boolean stepperDirection = false;
int stepperStep = 0;
int stepperStepCount = 0;
boolean stepperMove = false;
long prevMillisStepper = 0;
int intervalStepper = 4; // Minimum is 2

boolean button1Pressed = false;
boolean button2Pressed = false;

BLYNK_WRITE(V0) // Button Widget is writing to pin V0
{
  stepperDirection = param.asInt();

  tft.fillRect(120, 65, 120, 25, TFT_BLACK);
  tft.setCursor(120, 82);
  if (stepperDirection) {
    tft.print("CCW");
  }
  else {
    tft.print("CW");
  }
}

BLYNK_WRITE(V1) // Button Widget is writing to pin V1
{
  int stepperSpeed = param.asInt();

  tft.fillRect(120, 87, 120, 25, TFT_BLACK);
  tft.setCursor(120, 104);
  if (stepperSpeed == 1) {
    intervalStepper = 4;
    tft.print("Low");
  }
  else if (stepperSpeed == 2) {
    intervalStepper = 3;
    tft.print("Medium");
  }
  else if (stepperSpeed == 3) {
    intervalStepper = 2;
    tft.print("High");
  }
}

BLYNK_WRITE(V2) // Button Widget is writing to pin V2
{
  stepperMove = true;
  stepperStepCount = 2;
  stepperStep = 4;

  tft.fillRect(120, 109, 120, 25, TFT_BLACK);
  tft.setCursor(120, 126);
  tft.print("Run");
}

void setup()
{
  pinMode(BUTTON1, INPUT_PULLUP);
  pinMode(BUTTON2, INPUT_PULLUP);

  pinMode(STEPPER_IN1, OUTPUT);
  pinMode(STEPPER_IN2, OUTPUT);
  pinMode(STEPPER_IN3, OUTPUT);
  pinMode(STEPPER_IN4, OUTPUT);

  Serial.begin(115200);
  Serial.print("Initialize Blynk.");

  tft.init();
  tft.setRotation(3);
  tft.fillScreen(TFT_BLACK);

  tft.setFreeFont(FF21);
  tft.setTextColor(TFT_BLUE);
  tft.setCursor(ROW1);
  tft.print("Blynk Status:");

  tft.setFreeFont(FF17);
  tft.setTextColor(TFT_WHITE);
  tft.setCursor(120, 16);
  tft.print("Initialize...");

  WiFi.begin(ssid, password);
  while (WiFi.status() != WL_CONNECTED) {
    delay(500);
    Serial.print(".");
  }

  Serial.println("");
  Serial.println("WiFi connected.");
  Serial.println("IP address: ");
  Serial.println(WiFi.localIP());

  Blynk.begin(auth, ssid, password);

  tft.fillRect(120, 0, 120, 35, TFT_BLACK);
  tft.setCursor(120, 16);
  tft.print("Ready!");

  tft.setFreeFont(FF21);
  tft.setTextColor(TFT_RED);
  tft.setCursor(ROW3);
  tft.print("STEPPER");
  tft.setTextColor(TFT_GREEN);
  tft.setCursor(ROW4);
  tft.print("Direction:");
  tft.setCursor(ROW5);
  tft.print("Speed:");
  tft.setCursor(ROW6);
  tft.print("Status:");

  tft.setFreeFont(FF17);
  tft.setTextColor(TFT_YELLOW);
  tft.setCursor(120, 82);
  tft.print("CW");
  tft.setCursor(120, 104);
  tft.print("Low");
  tft.setCursor(120, 126);
  tft.print("Stop");

  Blynk.virtualWrite(0, 0);
  Blynk.virtualWrite(1, 1);
  Blynk.virtualWrite(2, 0);

  Serial.begin(115200);
  display.begin(SSD1306_SWITCHCAPVCC, 0x3C);
  display.clearDisplay();

  display.setTextSize(2);
  display.setTextColor(WHITE);
  display.setCursor(0, 0);
  display.println("Load Cell");
  display.display();

  scale[0].begin(LOADCELL1_DOUT_PIN, LOADCELL_SCK_PIN);
  //scale[1]->begin(LOADCELL2_DOUT_PIN, LOADCELL_SCK_PIN);
  //scale[2]->begin(LOADCELL3_DOUT_PIN, LOADCELL_SCK_PIN);

  scale[0].set_scale(410.45);
  scale[0].tare();
  scale[0].read();
  scale[0].read_average(20);
  scale[0].get_value(5);
  scale[0].get_units(5), 1;

  //setCpuFrequencyMhz(RTC_CPU_FREQ_80M);
  //pinMode(rbutton, INPUT_PULLUP);
  //scale.set_scale();
  //scale.tare(); //Reset the scale to 0
  //long zero_factor = scale.read_average(); //Get a baseline reading

  //display.begin(SSD1306_SWITCHCAPVCC, 0x3C);
  //timer.setInterval(1000L, getSendData);
  //display.clearDisplay();
  //display.setTextColor(WHITE);

}

void loop()
{
  Blynk.run();
  timer.run();

  char str[12];
  float units = 0.0;
  display.setTextSize(1);
  display.setTextColor(WHITE, BLACK);

  display.setCursor(0, 16);
  display.print("Weight : ");
  units = scale[0].get_units();
  display.println(units, 1);
  display.display();

  display.setCursor(0, 16);
  display.print("Weight : ");
  units = scale[0].get_units(10);
  display.println(units, 1);
  display.display();

  scale[0].power_down();
  delay(1000);
  scale[0].power_up();

  if (digitalRead(BUTTON1) == LOW &&
      button1Pressed == false) {
    button1Pressed = true;

    stepperDirection = false;
    stepperMove = true;
    stepperStepCount = 0;
    stepperStep = 1;
  }
  else if (digitalRead(BUTTON1) == HIGH &&
           button1Pressed == true) {
    button1Pressed = false;
  }

  if (digitalRead(BUTTON2) == LOW) {

    stepperDirection = true;
    stepperMove = true;
    stepperStepCount = 0;
    stepperStep = 1;
  }
  else if (digitalRead(BUTTON2) == HIGH &&
           button2Pressed == true) {
    button2Pressed = false;
  }

  if (millis() - prevMillisStepper > intervalStepper) {

    if (stepperMove == true) {
      if (stepperDirection) {
        if (stepperStep++ >= 3) {
          stepperStep = 0;
        }
      }
      else {
        if (stepperStep-- == 0) {
          stepperStep = 3;
        }
      }

      if (stepperStepCount++ == REVOLUTION_STEP) {
        stepperMove = false;
        stepperStep = 4;

        Blynk.virtualWrite(2, 0);

        tft.fillRect(120, 109, 120, 25, TFT_BLACK);
        tft.setCursor(120, 126);
        tft.print("Stop");
      }

      switch (stepperStep) {
        case 0:
          digitalWrite(STEPPER_IN1, HIGH);
          digitalWrite(STEPPER_IN2, LOW);
          digitalWrite(STEPPER_IN3, LOW);
          digitalWrite(STEPPER_IN4, LOW);
          break;

        case 1:
          digitalWrite(STEPPER_IN1, LOW);
          digitalWrite(STEPPER_IN2, HIGH);
          digitalWrite(STEPPER_IN3, LOW);
          digitalWrite(STEPPER_IN4, LOW);
          break;

        case 2:
          digitalWrite(STEPPER_IN1, LOW);
          digitalWrite(STEPPER_IN2, LOW);
          digitalWrite(STEPPER_IN3, HIGH);
          digitalWrite(STEPPER_IN4, LOW);
          break;

        case 3:
          digitalWrite(STEPPER_IN1, LOW);
          digitalWrite(STEPPER_IN2, LOW);
          digitalWrite(STEPPER_IN3, LOW);
          digitalWrite(STEPPER_IN4, HIGH);
          break;

        default:
          digitalWrite(STEPPER_IN1, LOW);
          digitalWrite(STEPPER_IN2, LOW);
          digitalWrite(STEPPER_IN3, LOW);
          digitalWrite(STEPPER_IN4, LOW);
          break;
      }
    }

    prevMillisStepper = millis();
  }
}

void getSendData()
{

//Blynk.virtualWrite(V3,"Weight:");
//Blynk.virtualWrite(V4,myString);

// Oled display
  display.clearDisplay();
  display.setTextSize(3);
  display.setCursor(0,0); // column row
  display.print("Weight:");

  display.setTextSize(4);
  display.setCursor(0,30);
  display.print(myString);

 display.display();
}
