RalphBacon/205-Internet-Radio/(commit log)

2020-11-11 Arduino users read this
2020-11-11 Arduino users read this (PlatformIO too)
2020-11-11 Arduino & PlatformIO users read this!
2020-12-26 Update ESP32 Construction Details (with Photos).md
2021-01-08 How to install the transformers on the PCB
2021-01-18 Arduino version uploaded
    Arduino IDE version for the ESP32 WROOM or WROVER
2021-01-23 Version 1.19
    Volume & Brightness fix
    [ToDo.h, main.cpp, main.h, stationSelectHelper.h]
2021-01-24 Create VS1053 Cable connection.jpg
2021-01-26 Uploaded V1.29
    Minor changes: cancel button in station list, bug fixes, usability fixes (eg VS1053 initialisation)
    [ESP32-WROVER_Web_Radio.ino, ToDo.h, main.h, stationSelectHelper.h]
2021-07-21 Updated cbuf.h from v1.0.6 ESP32 core
2021-07-21 V1.35 released
    Fixed issue with BBC and HTTP 1v1. Some background bug fixes. Started developing a Settings screen to contain little used functions such as Screen Brightness, Treble, Bass. In progress, not yet completed. Does not affect main sketch.
    [ESP32-WROVER_Web_Radio.ino, ToDo.h, main.h, settingsHelper.h, stationSelectHelper.h, taskPlayMusicHelper.h, urlHelper.h]
2021-12-08 Refresh 1v35
    [stationList.xlsx]
2021-12-30 Bug fixes for Internet failure recovery
    Recover the connection better when the Internet or Wi-Fi fails.
    [main.cpp, taskPlayMusicHelper.h, wifiHelpers.h]
2021-12-30 Version 1.38 for PlatformIO
    Bug fixes.
    [no_ota.csv, stationList.xlsx]
2022-01-02 Updated Jan 2022
    Added the Audio Transformers plus connected the RST of the VS1053b to pin 25 of the ESP32 to ensure a proper reset.
